Dalcouffe1/Design-Build-Fly/README.md

# CAPSTONE Design–Build–Fly: Lift + Cruise VTOL (student capstone)

A hybrid VTOL with four vertical lift rotors for takeoff and landing, and a pusher prop and fixed wing for cruise. The lift rotors stop in cruise. The aircraft is built and flight-tested on a **fixed $2,000 budget** (hardware, spares, test gear, tax and shipping) by **2027-04-30**.

**Open the design review:** double-click [`VTOL-Review.html`](VTOL-Review.html). It is one self-contained report in three parts (the decision, the design, build and fly), with interactive charts, a rotatable SOLIDWORKS model and links to the companion documents:

| Document | Open |
|---|---|
| Design review DBF-RPT-001, issue 3 | [`VTOL-Review.html`](VTOL-Review.html) |
| Build manual DBF-MAN-001 (14 work packages, step by step) | [`build-manual.html`](build-manual.html) · source [`docs/build/BUILD-MANUAL.md`](docs/build/BUILD-MANUAL.md) |
| Test and evaluation plan DBF-TP-001 | [`test-plan.html`](test-plan.html) · source [`docs/test/TEST-PLAN.md`](docs/test/TEST-PLAN.md) |
| Flight software setup DBF-SW-001 | [`flight-software.html`](flight-software.html) · source [`firmware/README.md`](firmware/README.md) |
| Hot-wire templates (1:1) | [`templates.html`](templates.html) |
| Drawing set DBF-DRW-001 rev B (9 sheets) | [`cad/drawings/DBF-DRW-001.PDF`](cad/drawings/DBF-DRW-001.PDF) |

## Current design (v0.4.0, 2026-10-21)

The numbers below come from `analysis/results.json` (sizing) and `analysis/aero/aero_results.json` (aerodynamics).

| | |
|---|---|
| Layout | C0: 4-lift twin-boom quadplane, H-tail with twin rudders on the booms, pusher on the pod; best of 29 configurations that keep the lift rotors stopped in cruise (`analysis/tradestudy.json`) |
| Span / wing | 2.4 m, 0.632 m² (chord 263 mm), NACA 2415, XPS foam core with packing-tape skin |
| MTOW | 6.43 kg (hard cap 25 kg; below the 8–15 kg working target, pending sign-off) |
| Lift / pusher | 5 × SunnySky X4110S 400KV; 17 in lift props; APC 14×8.5EP pusher |
| Hover / cruise | 888 W / 323 W at 20 m/s (aero build-up 297 W); hover T/W 1.95 on maker data |
| Energy | 2 × Ovonic 6S 6500 mAh LiPo; 13.1 min cruise available after 2 min hover + 20 % reserve (needs the printed leg fairings) |
| Aerodynamics | CD0 0.0427, L/D 8.3 at cruise; stall 12.05 m/s predicted (R11 ≤ 12, at the limit); neutral point 40.4 % MAC with the pod |
| Structure | 6061-T6 booms, spar sockets and a 0.76 m slip-fit joiner; joiner reserve factor 1.78 on yield at 4.5 g |
| CAD | SOLIDWORKS rev B: 75 part files, 397 components including every screw, nut, washer and insert; interference-checked |
| Avionics | CoreWing F405 Wing V2 + ArduPlane 4.7.2 stable QuadPlane; parameter file `firmware/vtol_c0.param` checked, SITL scenarios A–G pass |
| Budget | **$1,896.79 committed** (goods $1,620.67 + 10.25 % tax + $110 shipping estimate); **$103.21 reserve** |

## Repository layout

| Path | What it is |
|---|---|
| `VTOL-Review.html`, `*.html` at the root | The review and its companion pages (generated by `review/build.mjs`) |
| `docs/DESIGN-BASIS.md` | Requirements R1–R20 (Given vs Assumed), design outcomes |
| `docs/research/` | Parts research with prices, URLs and dates; `hardware-spec.md` (fasteners and fits), `configurations.md` (trade-study literature), `aerodynamics.md`, `firmware.md` |
| `docs/build/` | Build manual, cut / print / wiring lists, hot-wire template generator |
| `docs/test/` | Test plan, test matrix, flight test cards, data-reduction scripts |
| `docs/purchasing/C0_BOM.csv` | Purchasing list grouped by vendor, with order-tracking columns |
| `analysis/` | Sizing model and script, vortex-lattice check, trade study, independent checks (`verify.py`) |
| `analysis/aero/` | XFOIL, NeuralFoil, AVL, drag build-up and SU2 CFD (`run_all.py`) |
| `firmware/` | ArduPlane parameter files, setup guide, checklists, parameter checker, SITL scripts and results |
| `cad/` | SOLIDWORKS model generator, drawings, simulations and outputs. See [`cad/README.md`](cad/README.md) |
| `review/` | Page sources (`src/`), companion-page renderer and build script |

## Regenerate everything

```bash
node analysis/sizing.mjs        # sizing + BOM  -> analysis/results.json
node analysis/vlm.mjs           # aero check    -> analysis/aero.json
node analysis/export_bom.mjs    # purchasing    -> docs/purchasing/C0_BOM.csv
py -3 analysis/verify.py        # independent checks (expects "FAILED CHECKS: none")
node analysis/tradestudy.mjs    # 29-variant trade study -> analysis/tradestudy.json
py -3 analysis/aero/run_all.py  # aerodynamics and CFD -> analysis/aero/aero_results.json (--skip-cfd for the fast tools)
py -3 firmware/tools/check_params.py firmware/vtol_c0.param
node review/build.mjs           # review and companion pages
```

The CAD and simulations need SOLIDWORKS 2025 with Simulation on Windows:

```bash
powershell -ExecutionPolicy Bypass -File cad/build.ps1   # params -> parts, assembly, drawings, meshes
cad/Sim.exe cad/params.txt cad/sim                      # FEA + modal + thermal -> cad/sim/results.txt
```

## Working rules (from CLAUDE.md)

- Every number cites its source: a repo file, a formula shown in the review, or a URL with the date checked.
- Estimates are labelled `est`. Unknowns are shown as "—" and never invented.

## Open items for the team

1. **Approve and order.** Client approval and Order A (test motors, packs, charger) by 2026-11-02.
2. **Flying site and legal path.** Ask UCPD/Risk Services by 2026-11-06 and request Richmond Field Station.
3. **Thrust stand first.** Qualify every motor and ESC before any flight; C0 has no hover motor-out tolerance.
4. **Measure.** Each chapter of the review lists what the team still has to measure; the overview gathers them in one list.
