Dalcouffe1/Design-Build-Fly/analysis/aero/plots/aircraft_polar.png

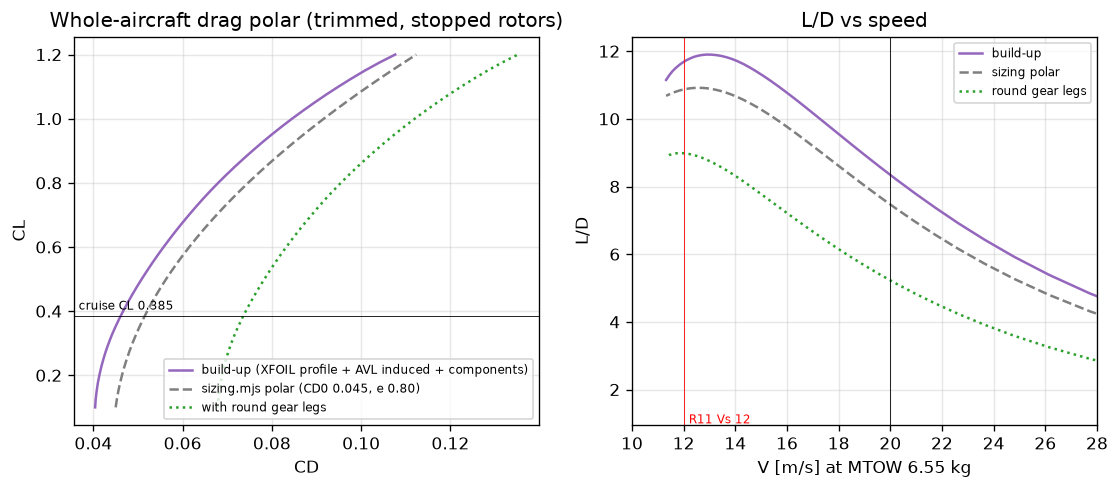
analysis/aero/plots/aircraft_polar.png
