Dalcouffe1/Design-Build-Fly/analysis/aero/plots/cg_np.png

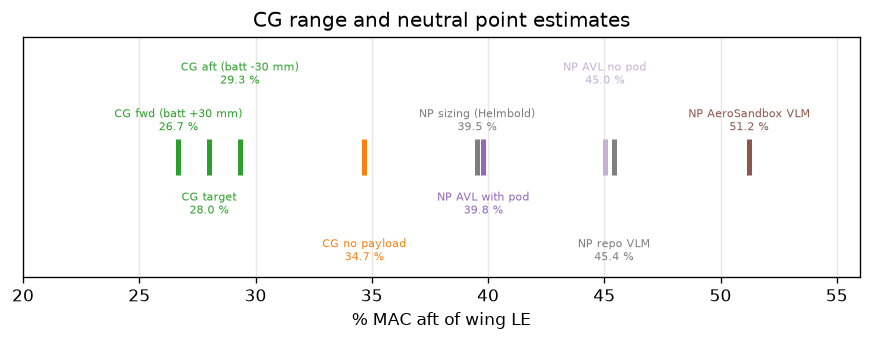
analysis/aero/plots/cg_np.png
