Dalcouffe1/Design-Build-Fly/analysis/aero/plots/cp_distributions.png

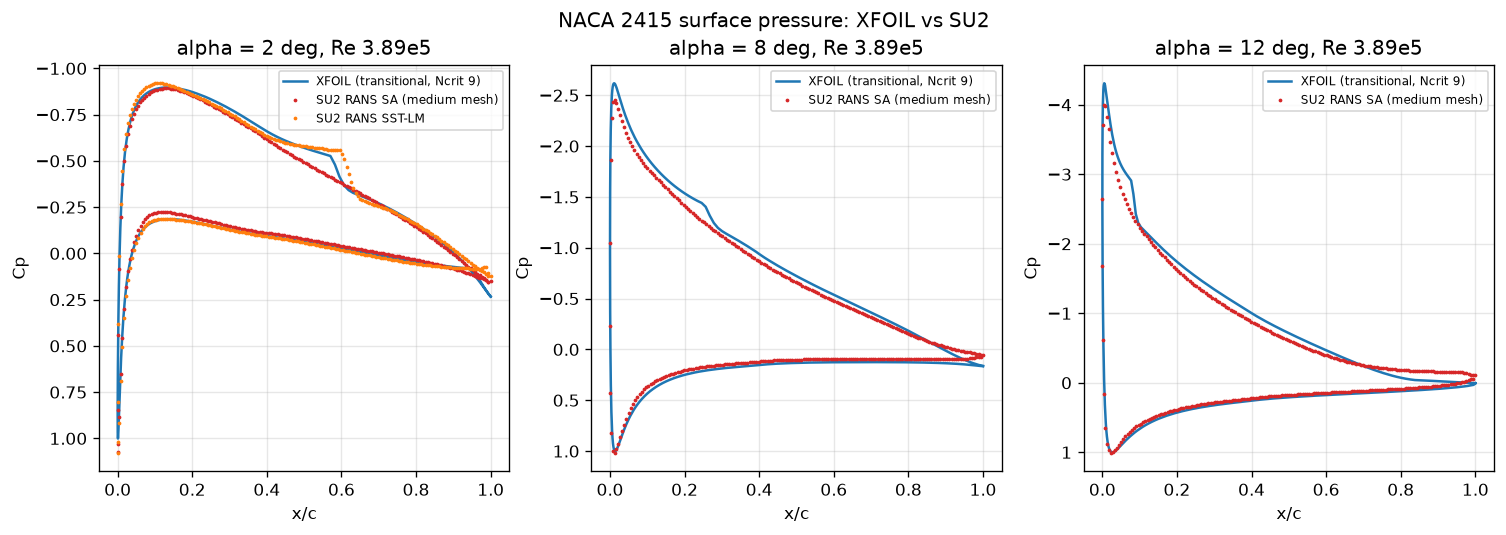
analysis/aero/plots/cp_distributions.png
