Dalcouffe1/Design-Build-Fly/analysis/aero/plots/drag_breakdown.png

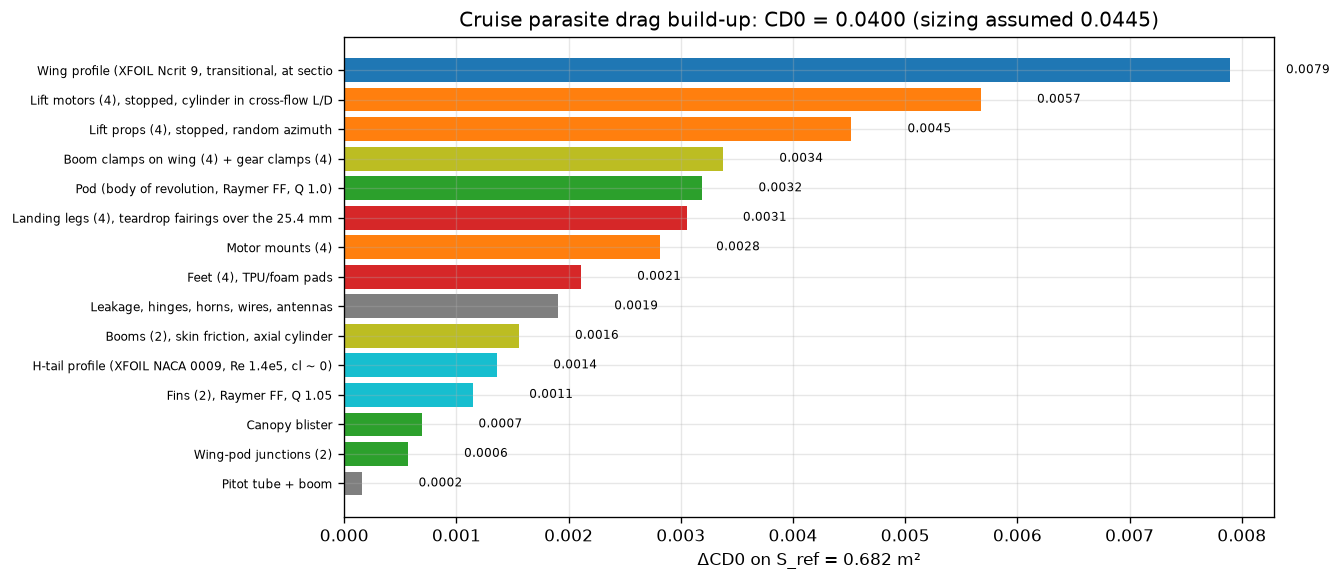
analysis/aero/plots/drag_breakdown.png
