Dalcouffe1/Design-Build-Fly/analysis/aero/plots/drag_pie.png

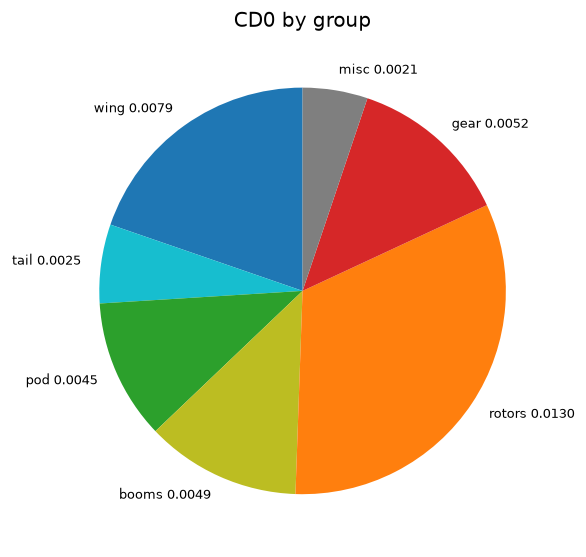
analysis/aero/plots/drag_pie.png
