Dalcouffe1/Design-Build-Fly/analysis/aero/plots/flow_0.png

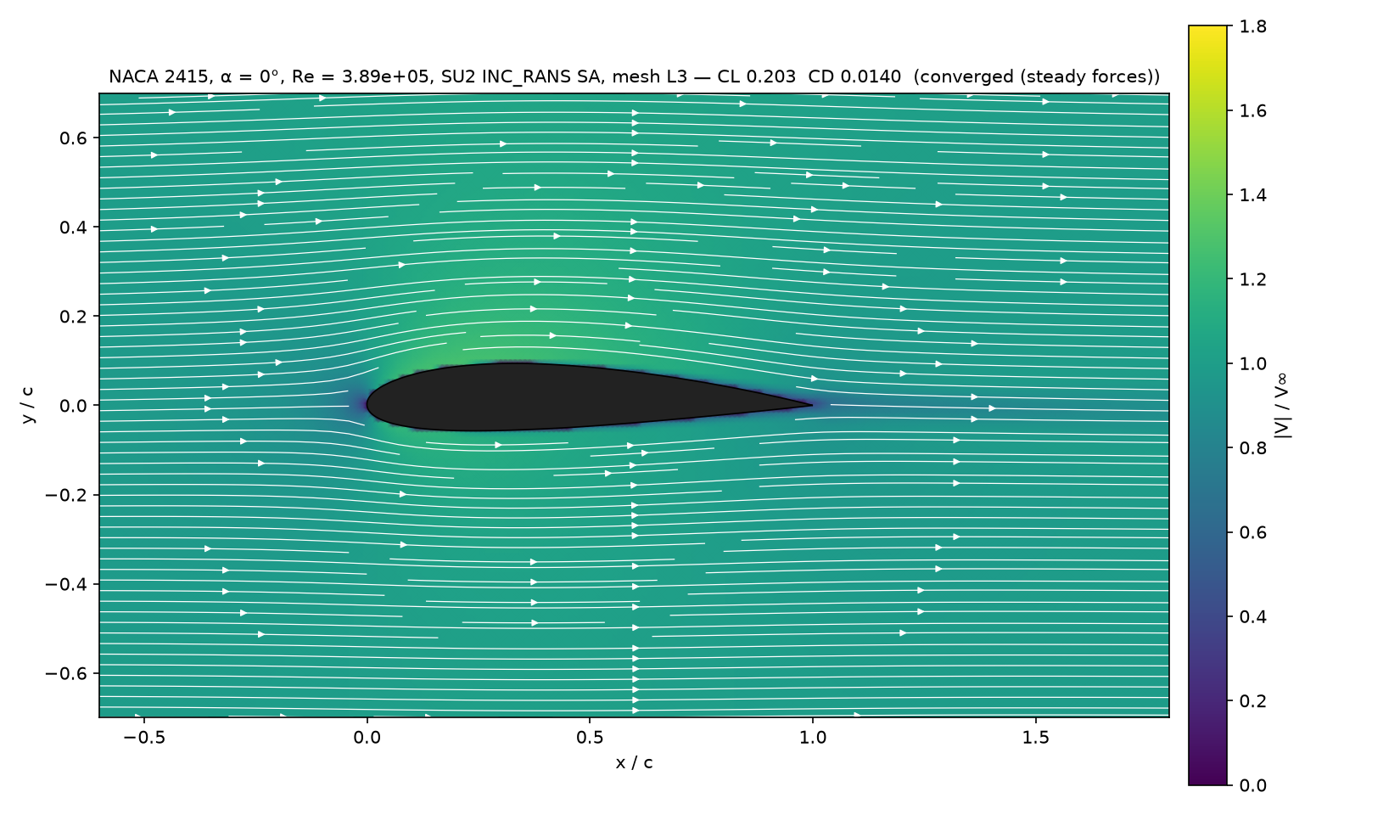
analysis/aero/plots/flow_0.png
