Dalcouffe1/Design-Build-Fly/analysis/aero/plots/flow_3d.png

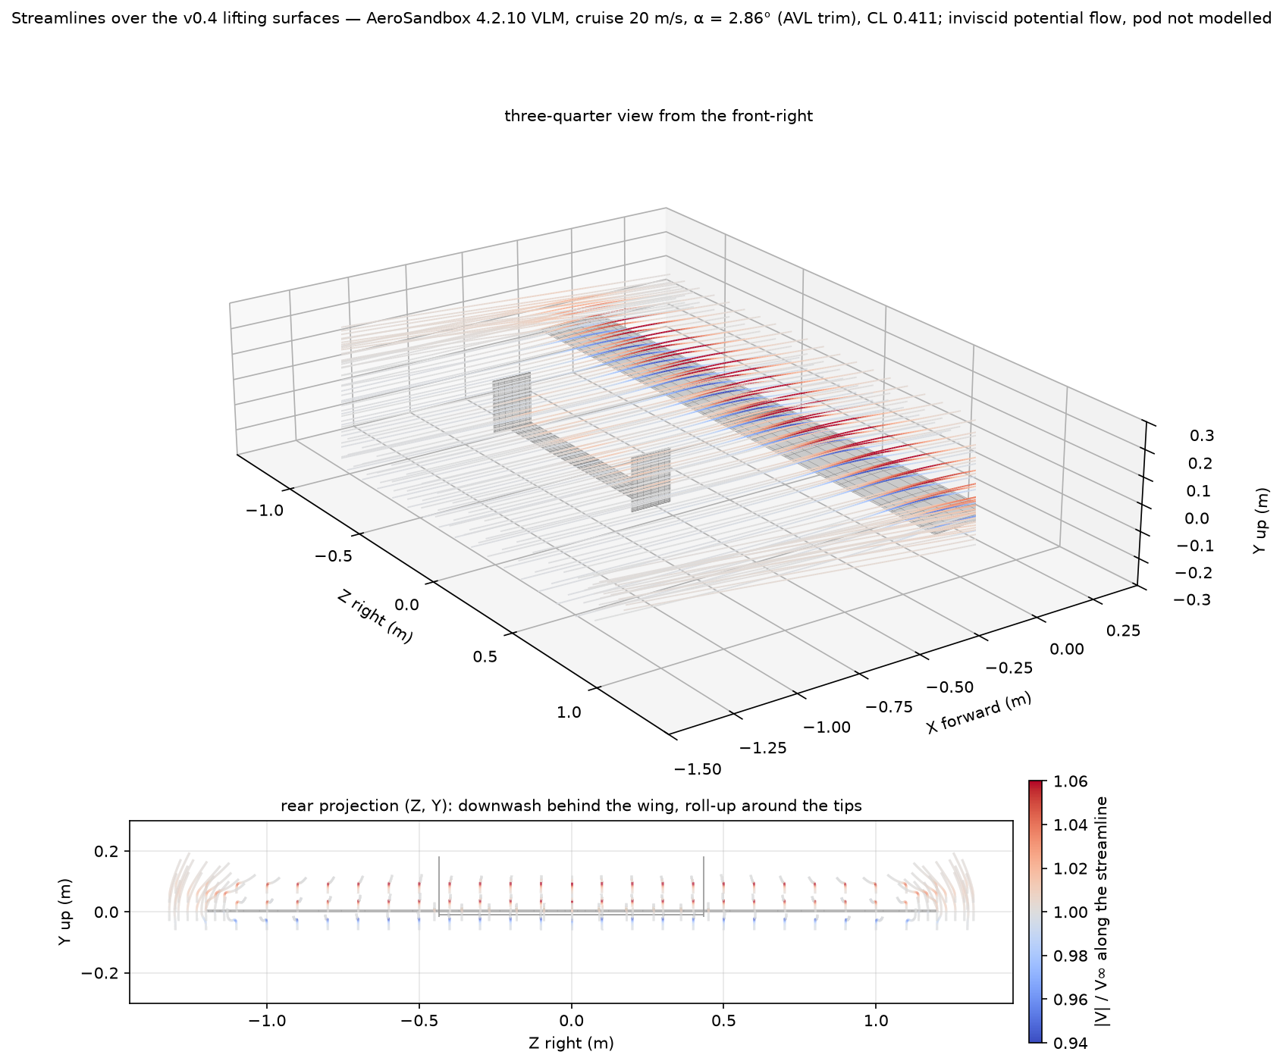
analysis/aero/plots/flow_3d.png
