Dalcouffe1/Design-Build-Fly/analysis/aero/plots/flow_4.png

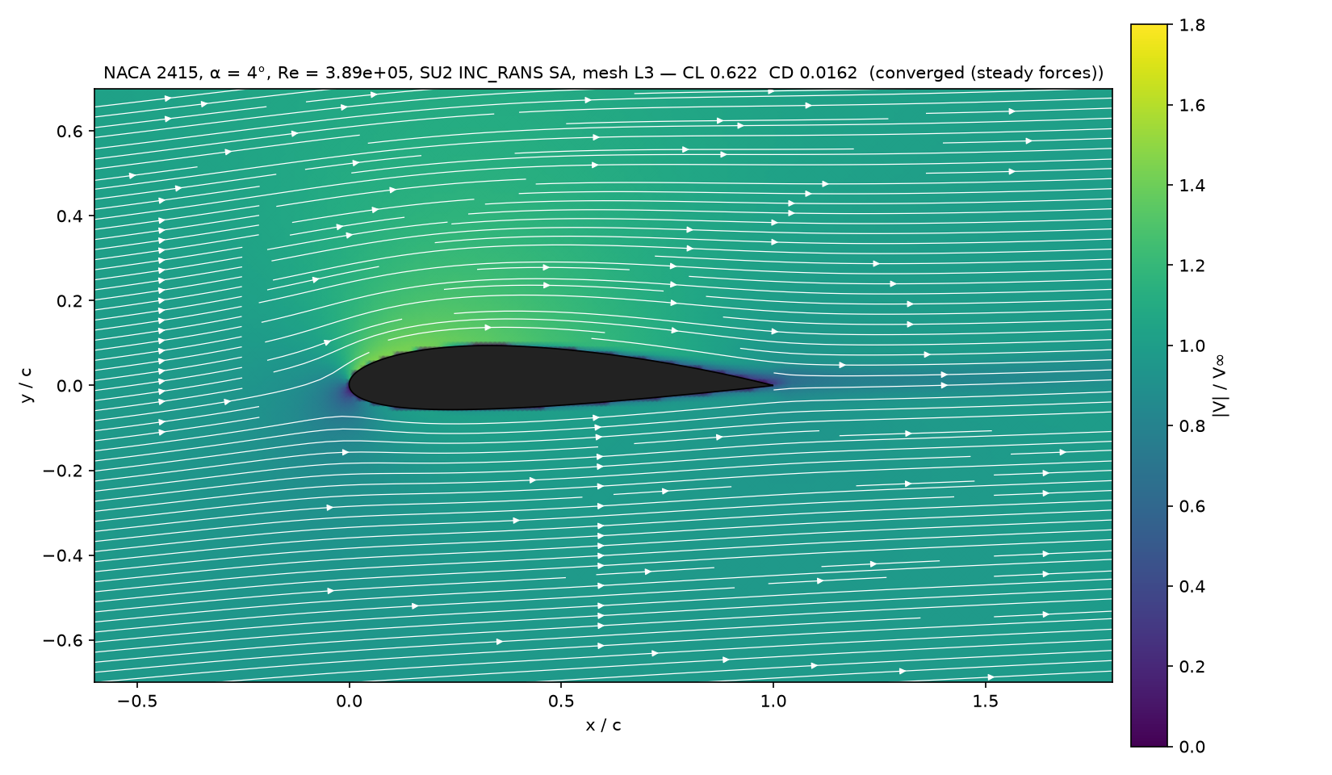
analysis/aero/plots/flow_4.png
