Dalcouffe1/Design-Build-Fly/analysis/aero/plots/flow_8.png

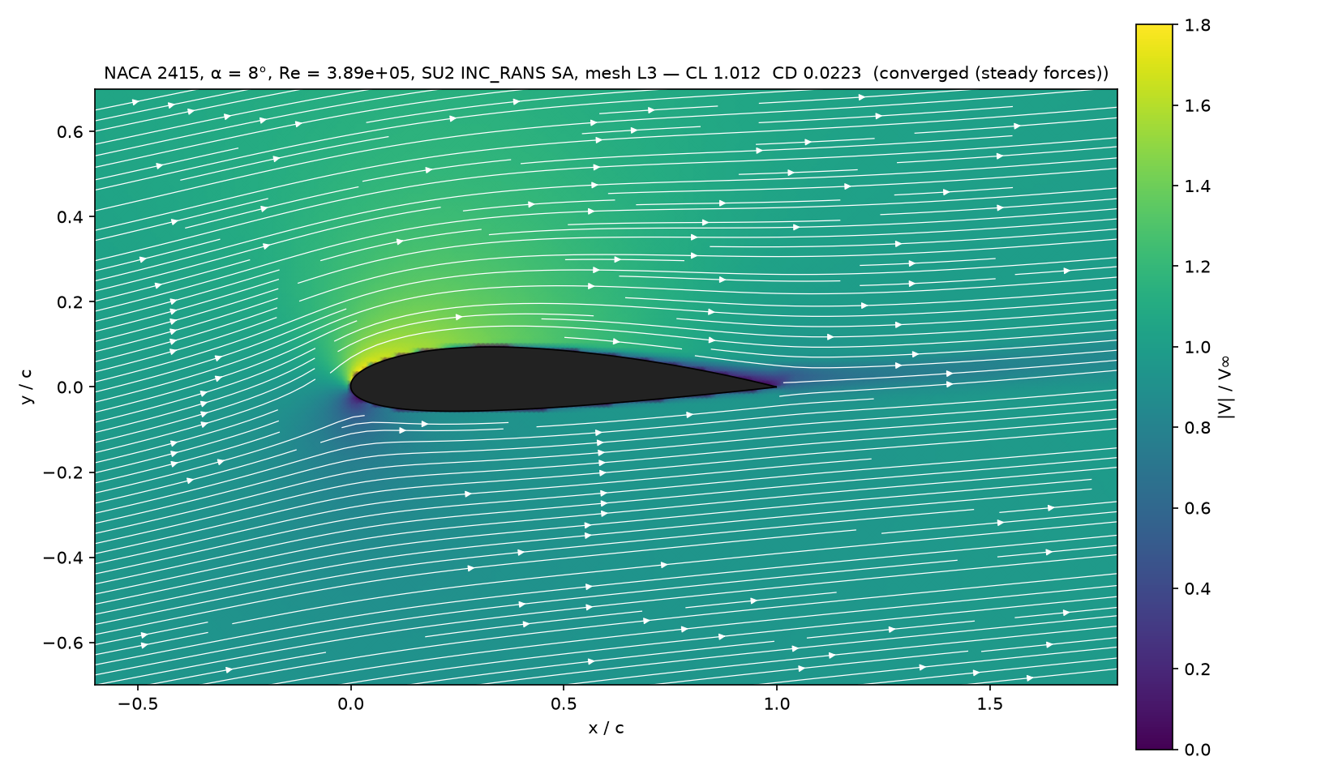
analysis/aero/plots/flow_8.png
