Dalcouffe1/Design-Build-Fly/analysis/aero/plots/flow_12.png

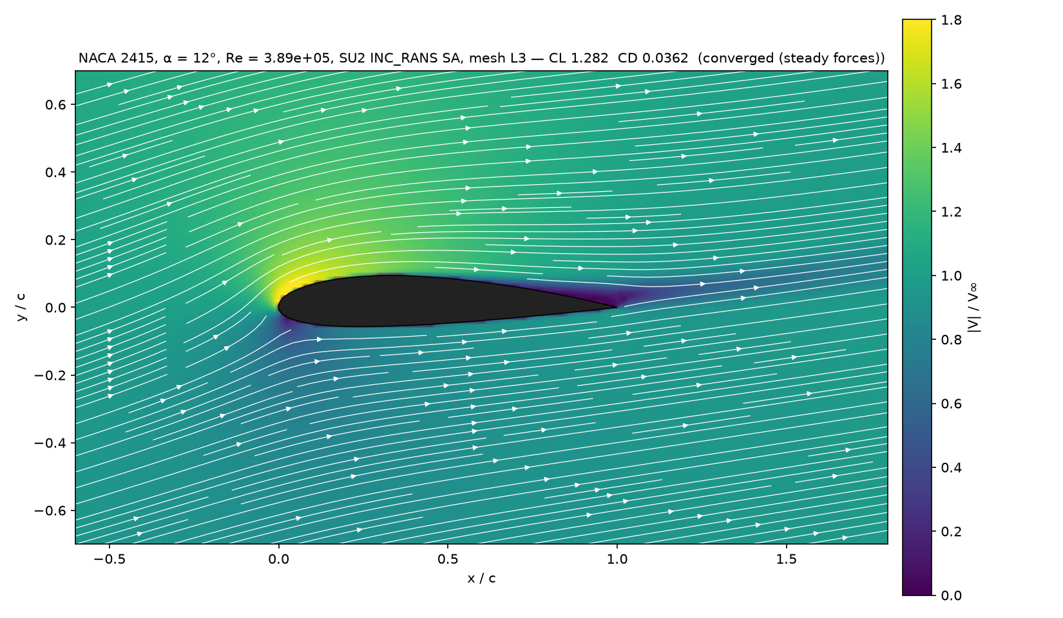
analysis/aero/plots/flow_12.png
