Dalcouffe1/Design-Build-Fly/analysis/aero/plots/flow_15.png

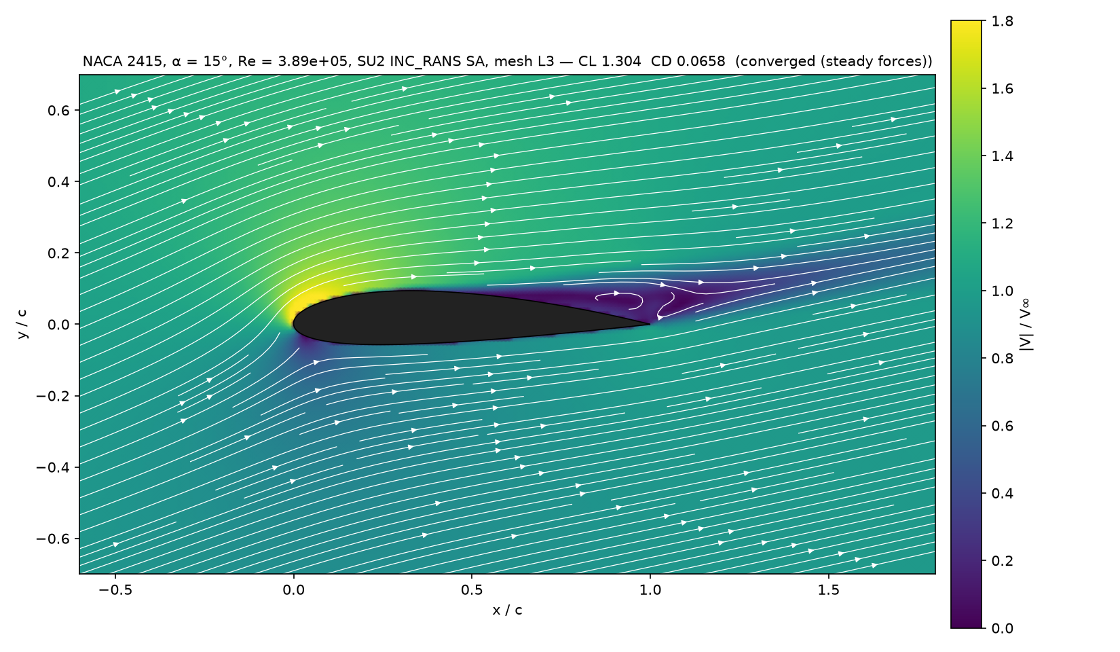
analysis/aero/plots/flow_15.png
