Dalcouffe1/Design-Build-Fly/analysis/aero/plots/flow_cp_8.png

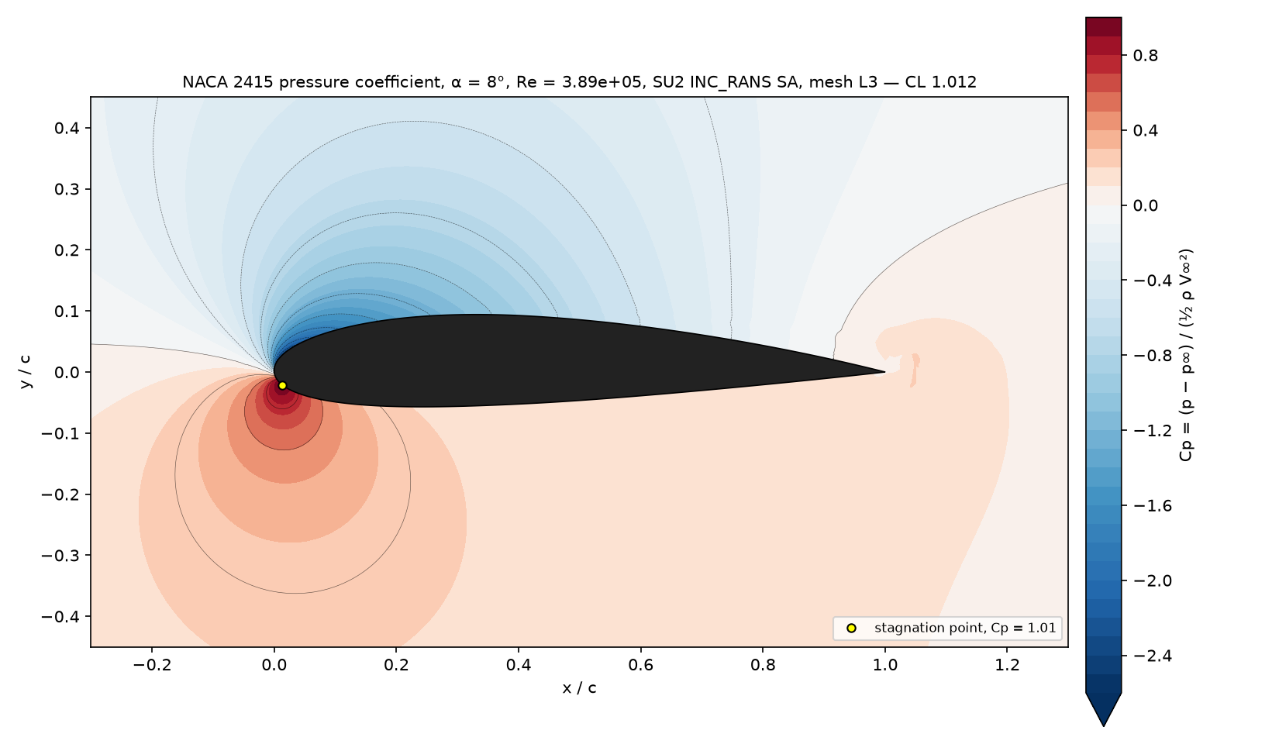
analysis/aero/plots/flow_cp_8.png
