Dalcouffe1/Design-Build-Fly/analysis/aero/plots/mesh_check_L1.png

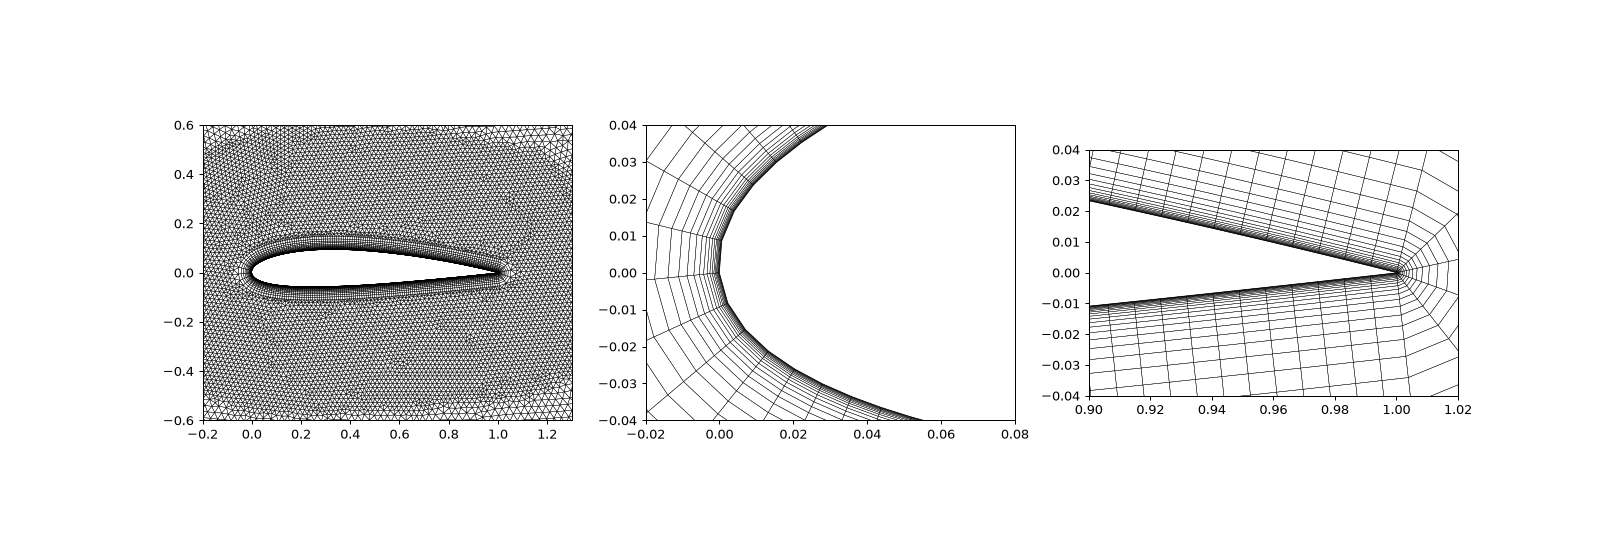
analysis/aero/plots/mesh_check_L1.png
