Dalcouffe1/Design-Build-Fly/analysis/aero/plots/section_polars.png

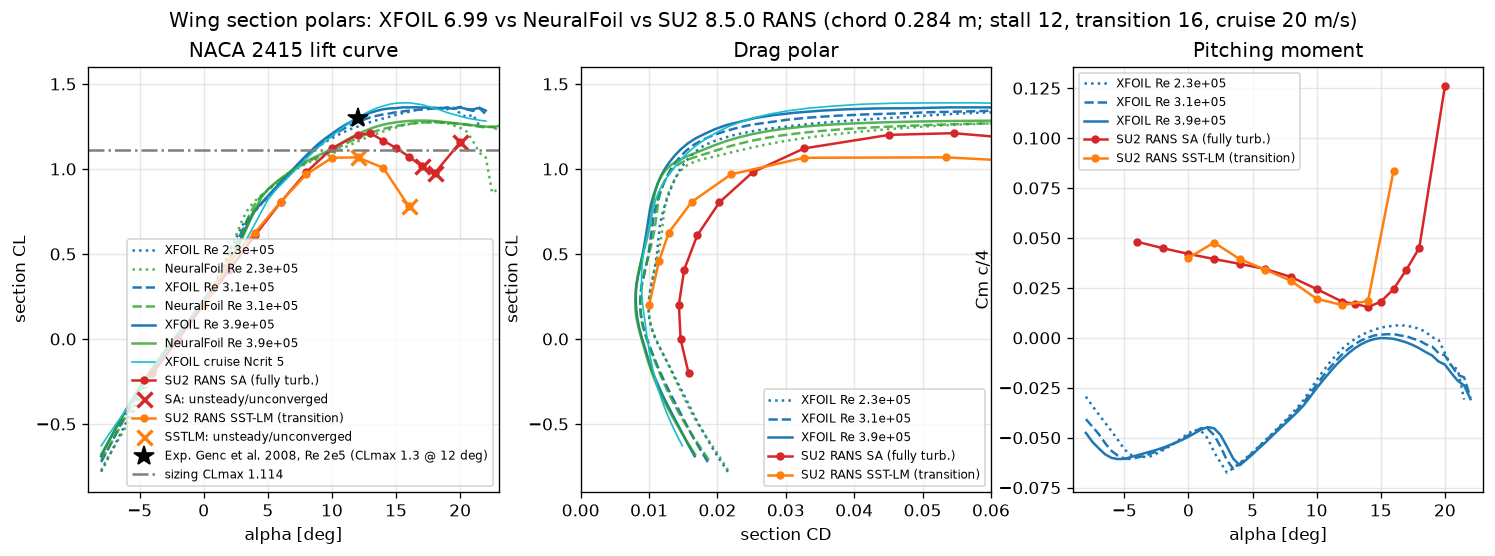
analysis/aero/plots/section_polars.png
