Dalcouffe1/Design-Build-Fly/analysis/aero/plots/span_loading.png

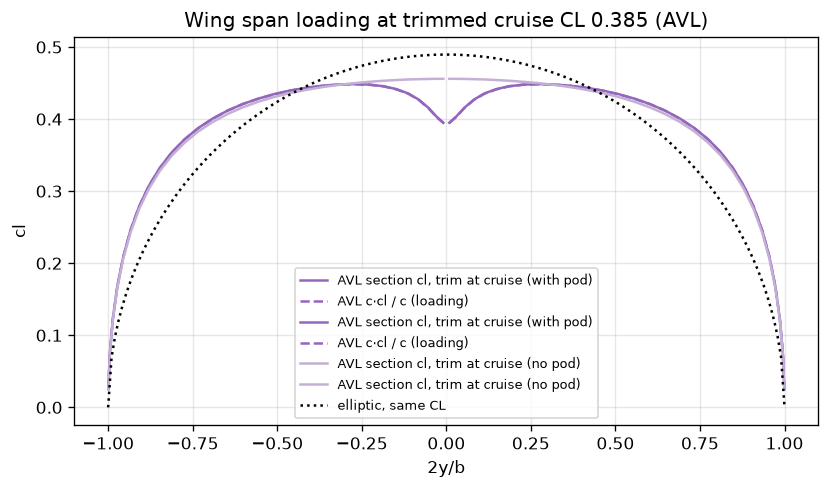
analysis/aero/plots/span_loading.png
