Dalcouffe1/Design-Build-Fly/analysis/aero/plots/stability.png

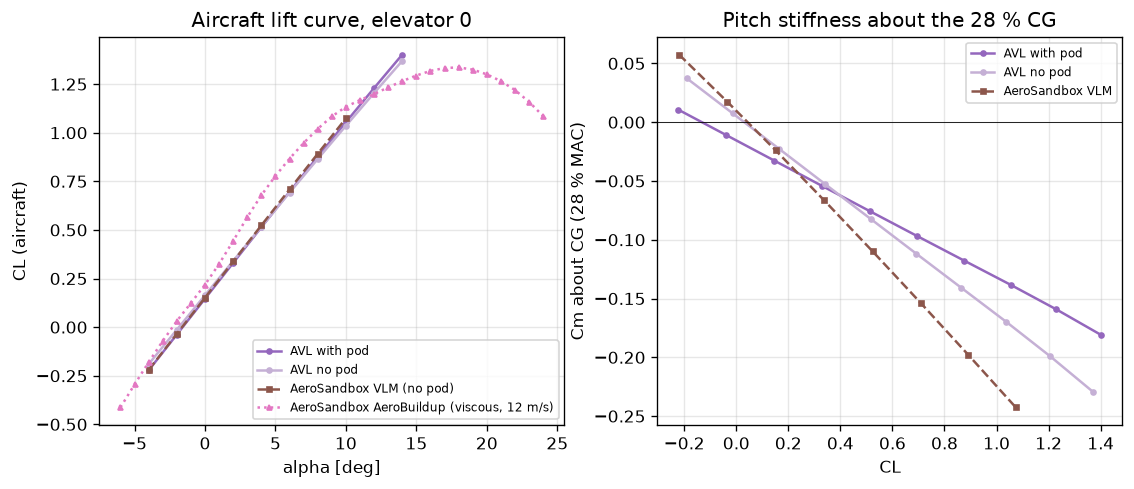
analysis/aero/plots/stability.png
