Dalcouffe1/Design-Build-Fly/analysis/aero/plots/su2_convergence.png

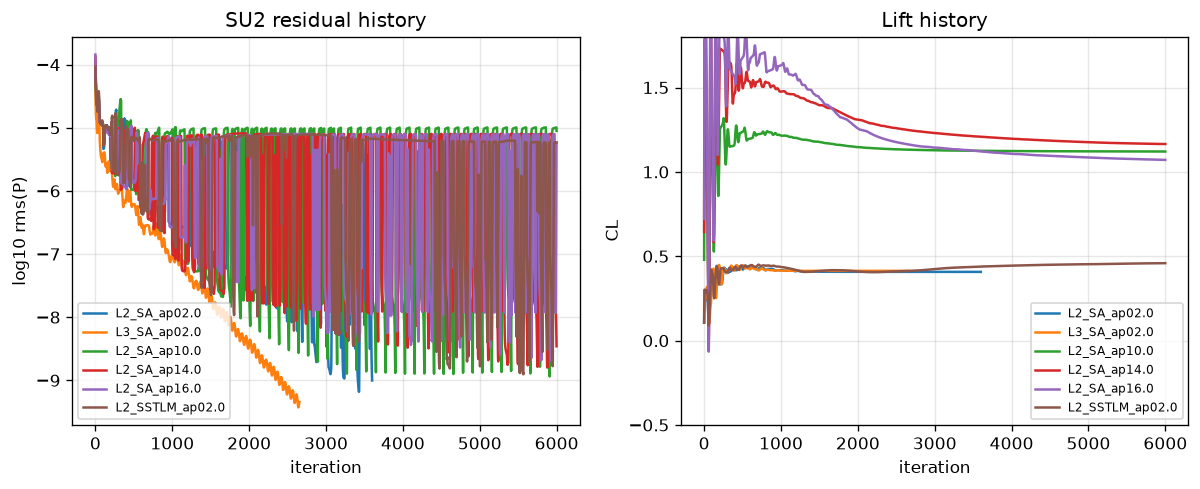
analysis/aero/plots/su2_convergence.png
