Dalcouffe1/Design-Build-Fly/analysis/aero/plots/su2_mesh_study.png

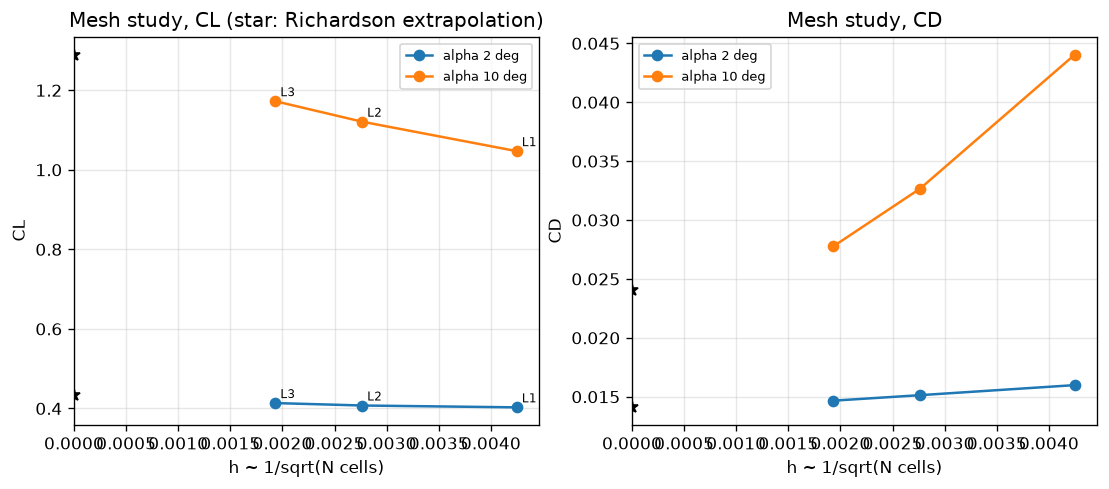
analysis/aero/plots/su2_mesh_study.png
