Dalcouffe1/Design-Build-Fly/analysis/aero/plots/tail_section_polars.png

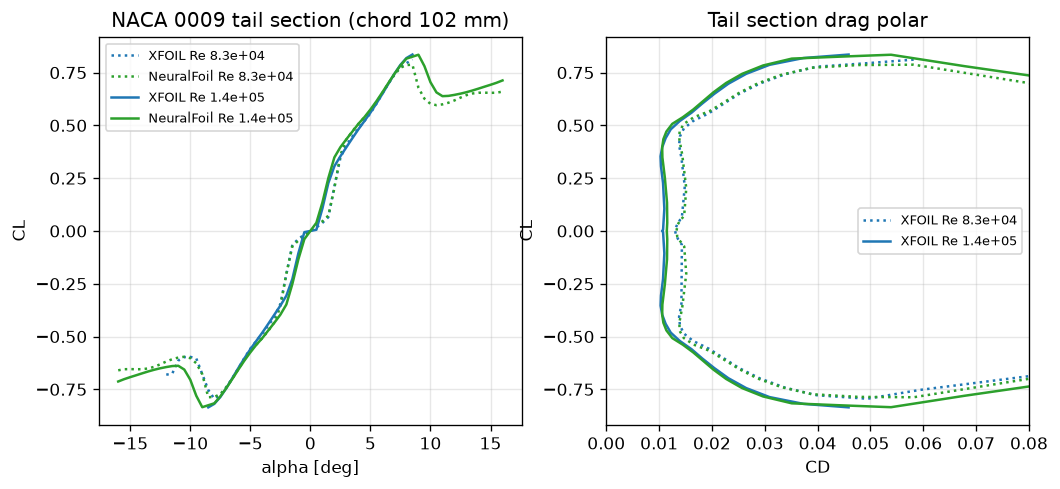
analysis/aero/plots/tail_section_polars.png
