Dalcouffe1/Design-Build-Fly/analysis/thermal/img/lift_unit_hover_30_60_90.png

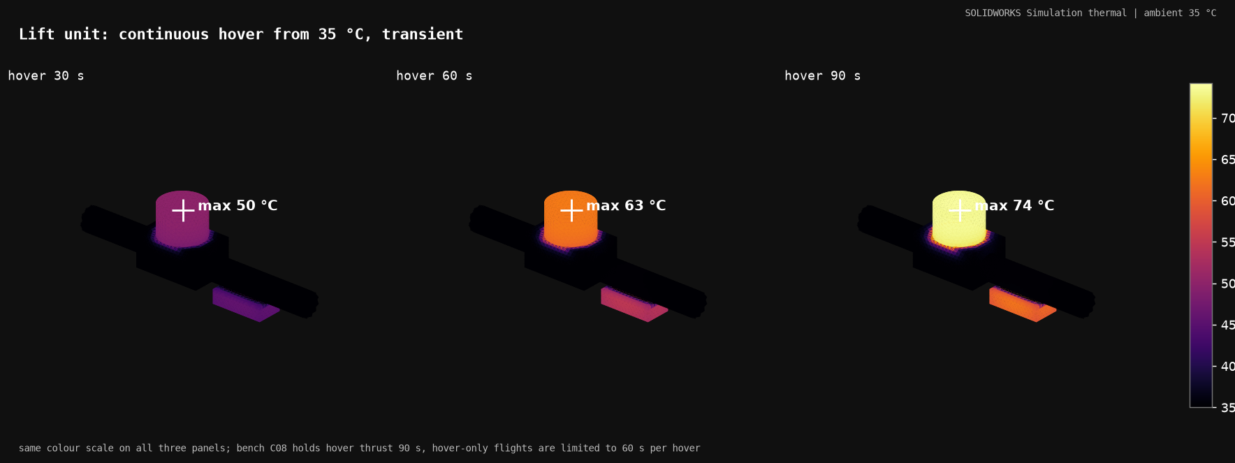
analysis/thermal/img/lift_unit_hover_30_60_90.png
