Dalcouffe1/Design-Build-Fly/analysis/thermal/img/lift_unit_mission.png

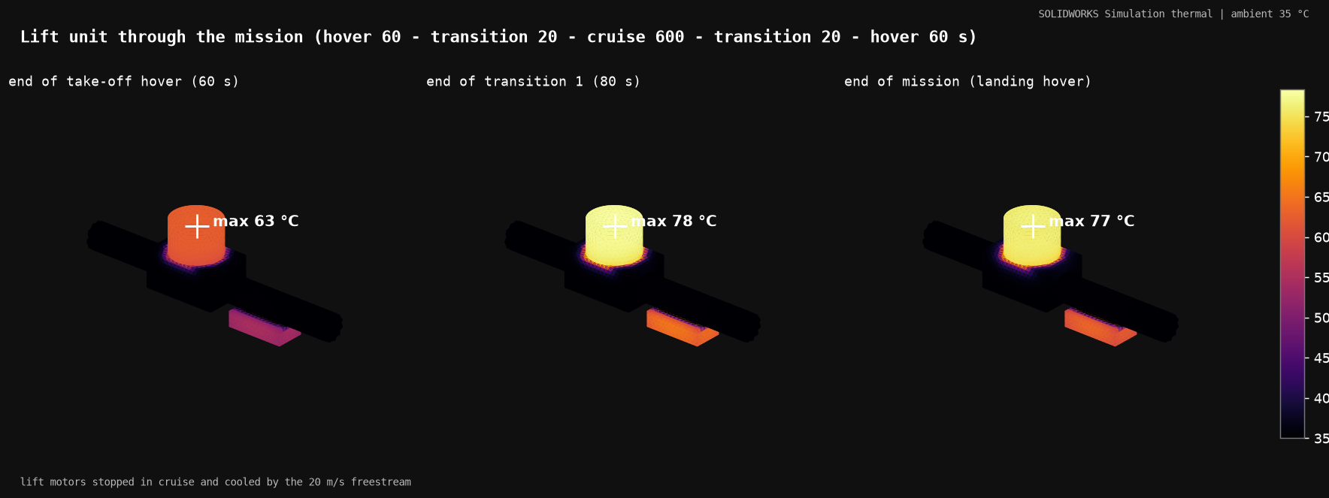
analysis/thermal/img/lift_unit_mission.png
