Dalcouffe1/Design-Build-Fly/analysis/thermal/img/lift_unit_steady.png

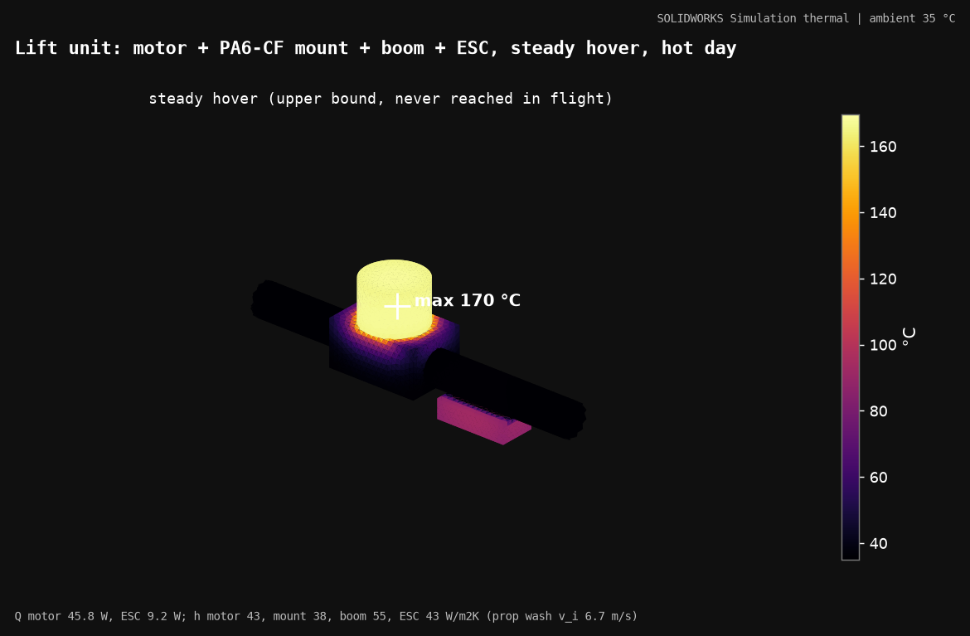
analysis/thermal/img/lift_unit_steady.png
