Dalcouffe1/Design-Build-Fly/analysis/thermal/img/pod_end_cruise.png

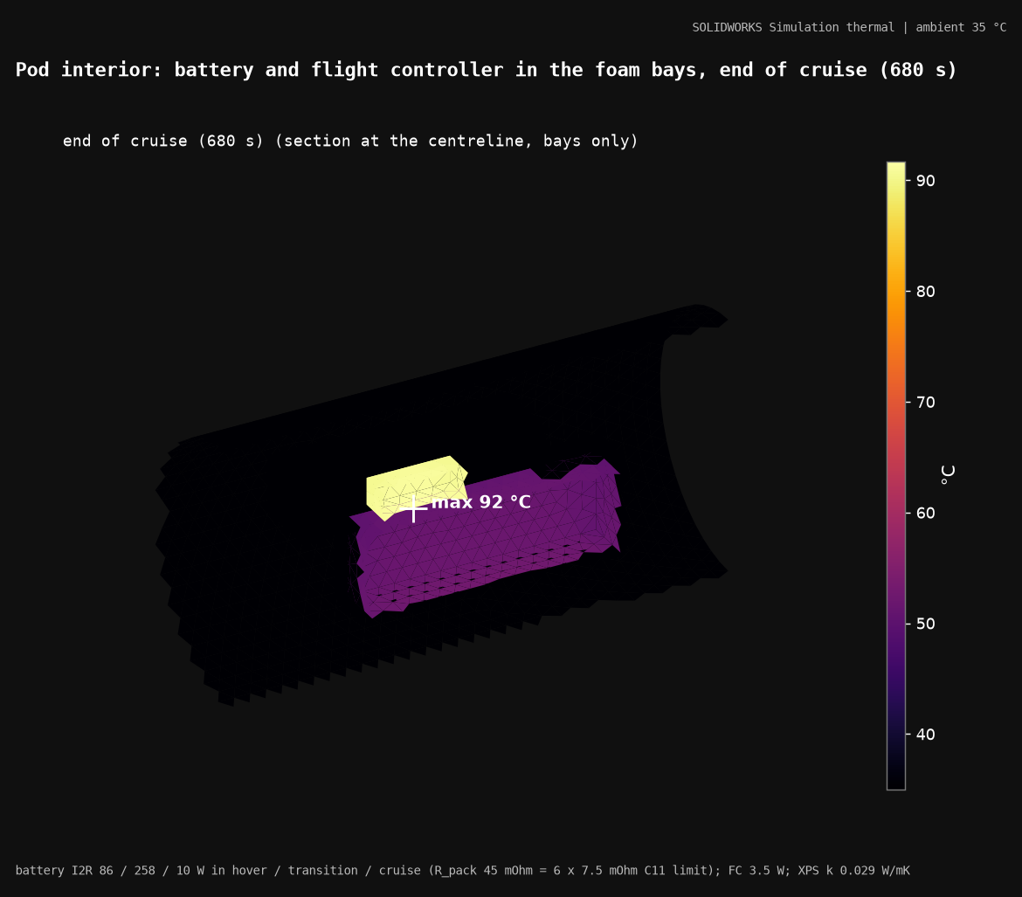
analysis/thermal/img/pod_end_cruise.png
