Dalcouffe1/Design-Build-Fly/analysis/thermal/img/pusher_cruise.png

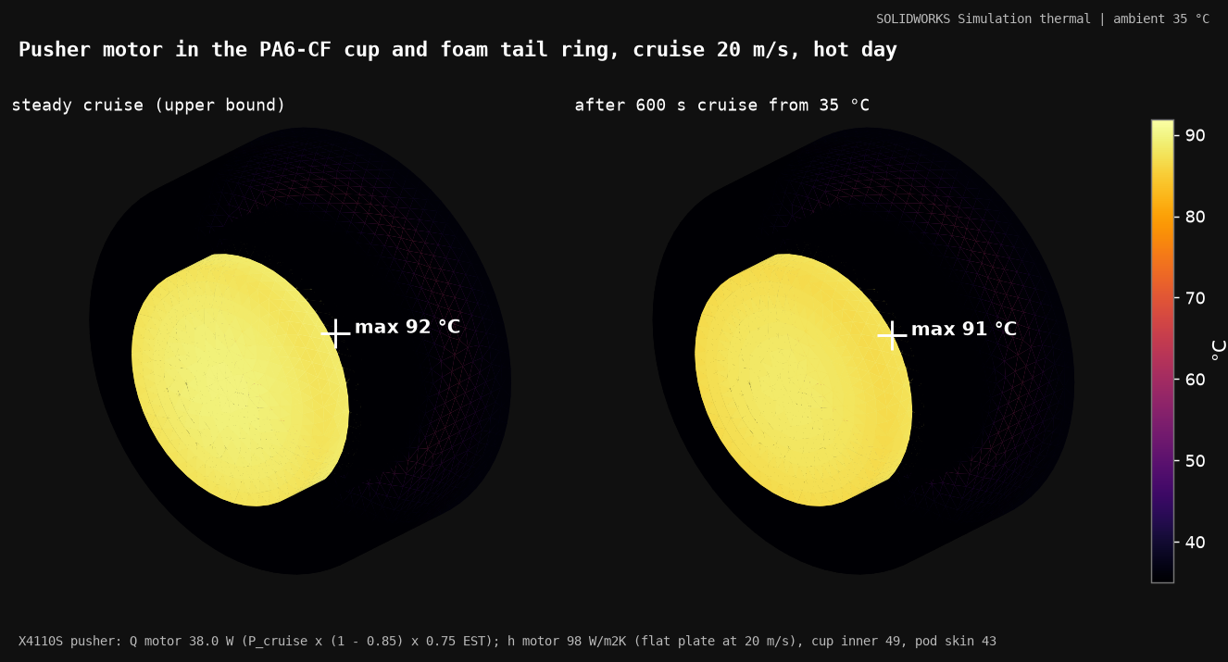
analysis/thermal/img/pusher_cruise.png
