Dalcouffe1/Design-Build-Fly/cad/drawings/DBF-DRW-001_sheet4.png

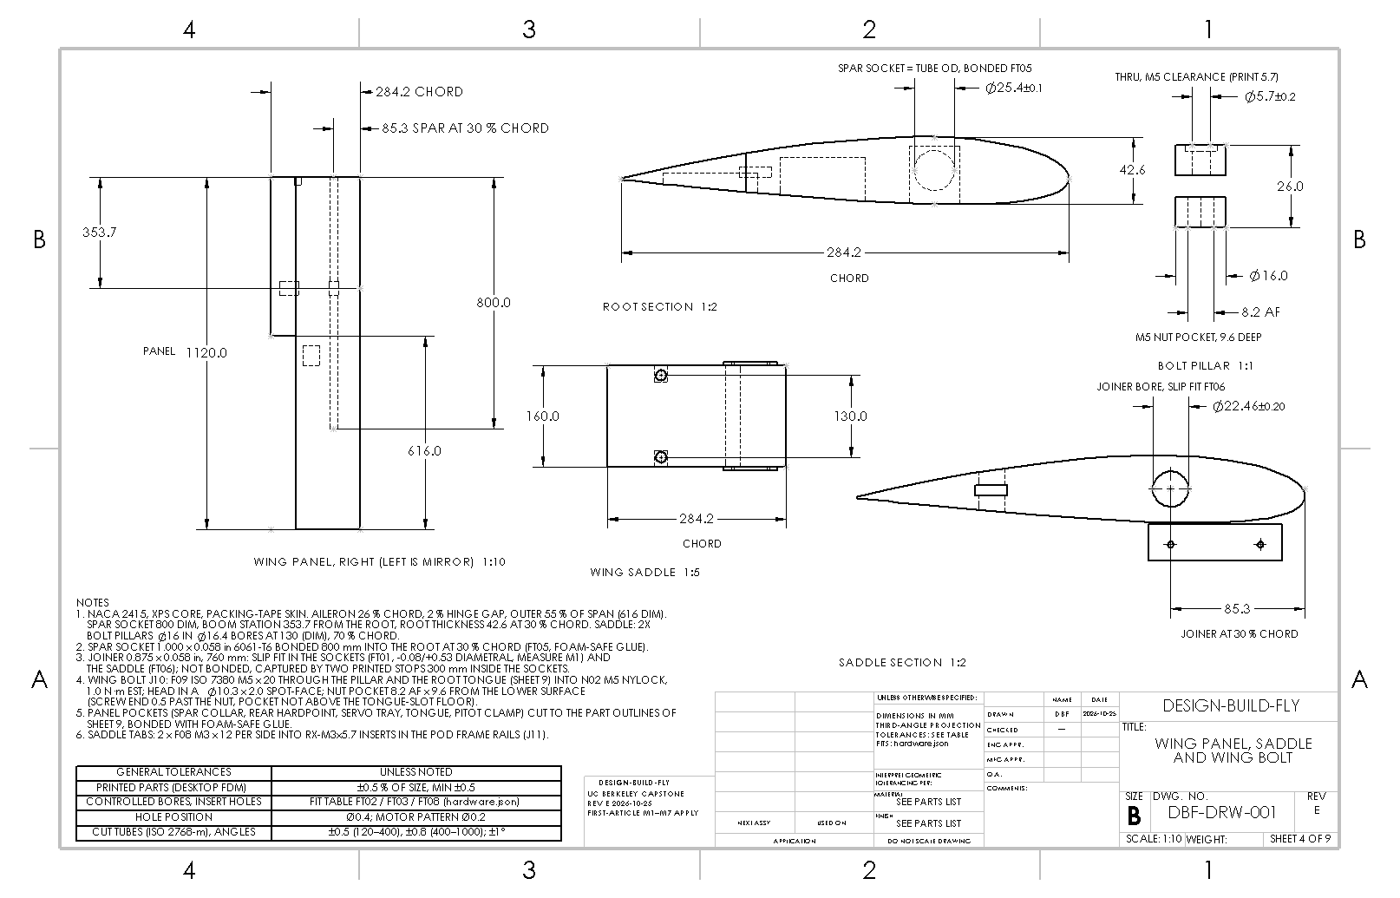
cad/drawings/DBF-DRW-001_sheet4.png
