Dalcouffe1/Design-Build-Fly/cad/drawings/DBF-DRW-001_sheet8.png

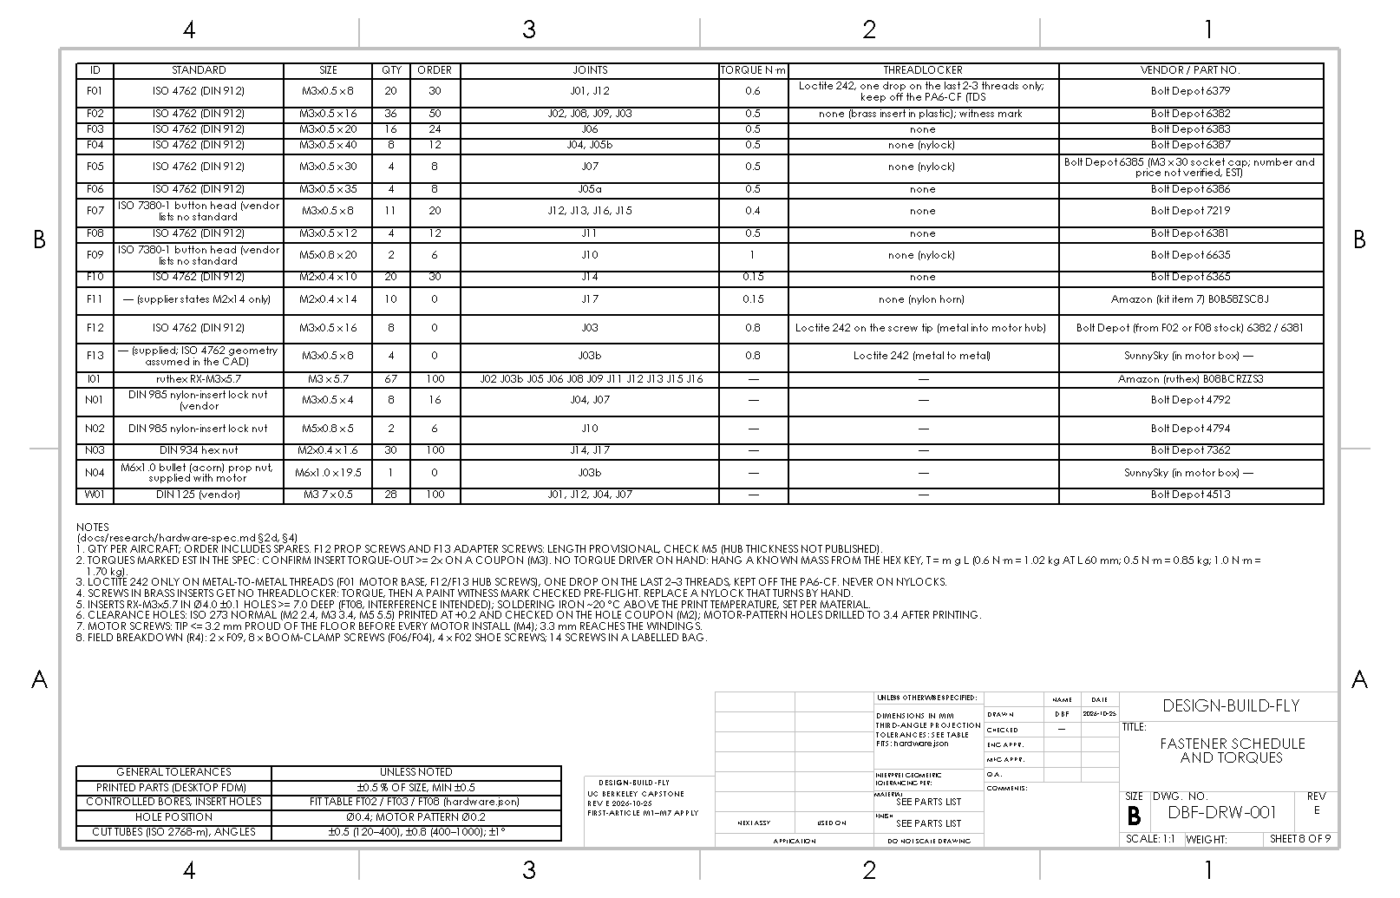
cad/drawings/DBF-DRW-001_sheet8.png
