Dalcouffe1/Design-Build-Fly/cad/images/VTOL_Concept_front.png

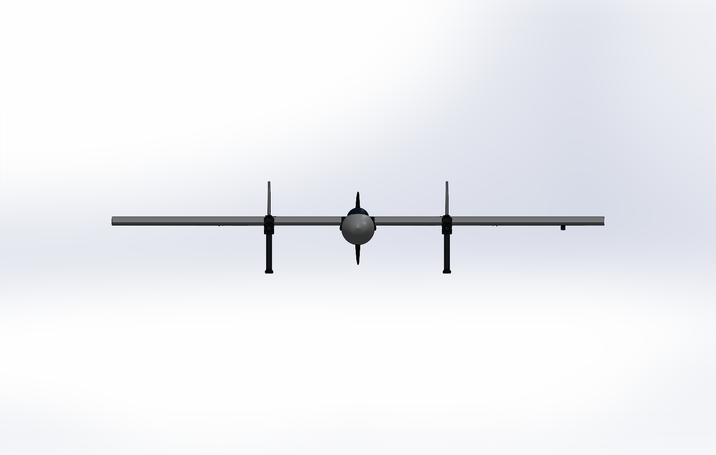
cad/images/VTOL_Concept_front.png
