Dalcouffe1/Design-Build-Fly/cad/images/VTOL_Concept_iso.png

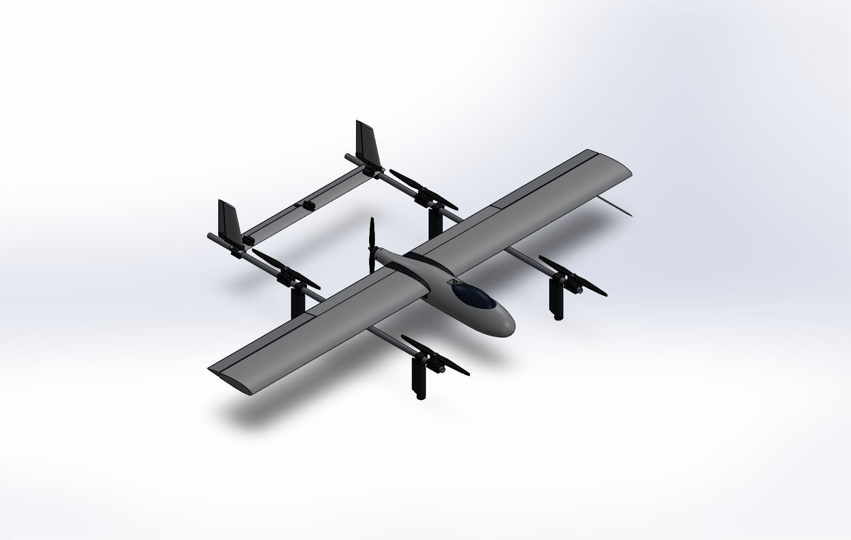
cad/images/VTOL_Concept_iso.png
