Dalcouffe1/Design-Build-Fly/cad/images/VTOL_Concept_side.png

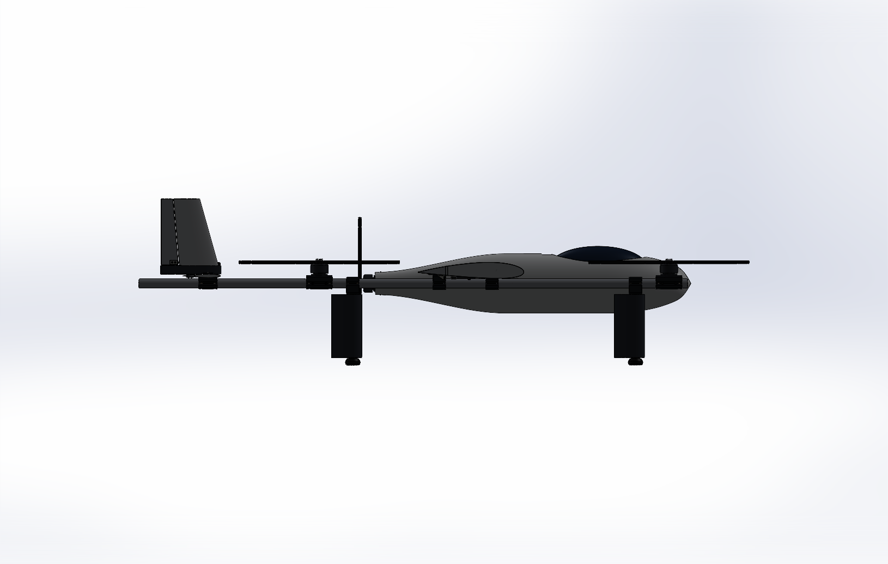
cad/images/VTOL_Concept_side.png
