Dalcouffe1/Design-Build-Fly/cad/images/VTOL_Concept_top.png

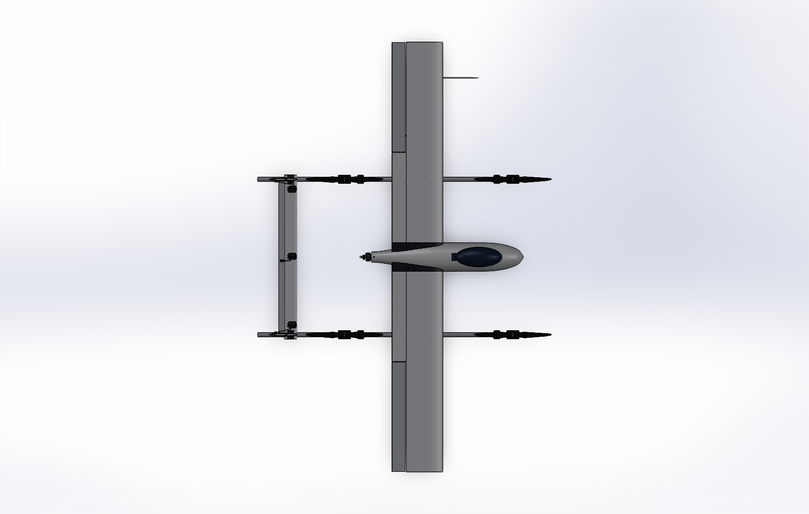
cad/images/VTOL_Concept_top.png
