Dalcouffe1/Design-Build-Fly/cad/sim/FEA_Boom_vonMises.png

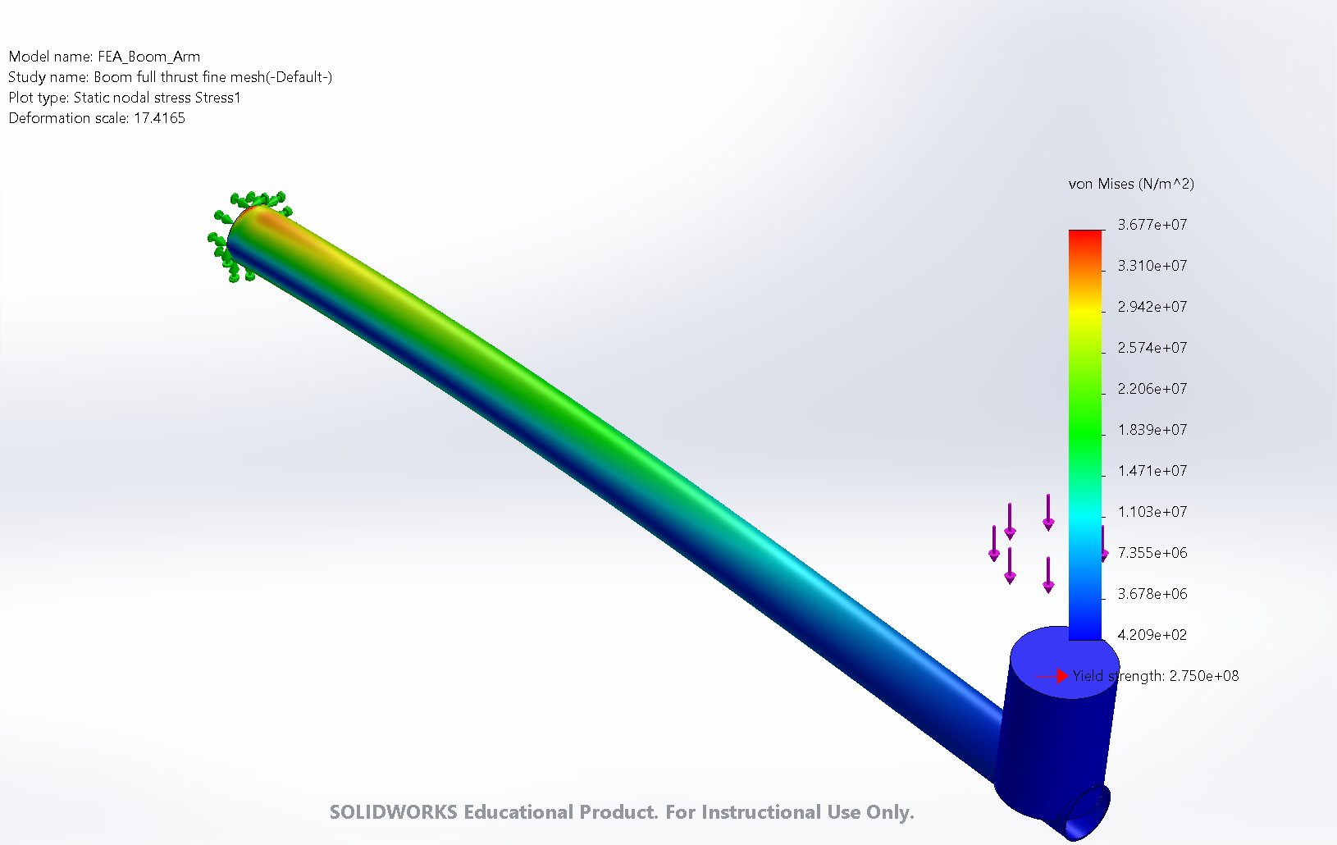
cad/sim/FEA_Boom_vonMises.png
