Dalcouffe1/Design-Build-Fly/cad/sim/FEA_Spar_vonMises.png

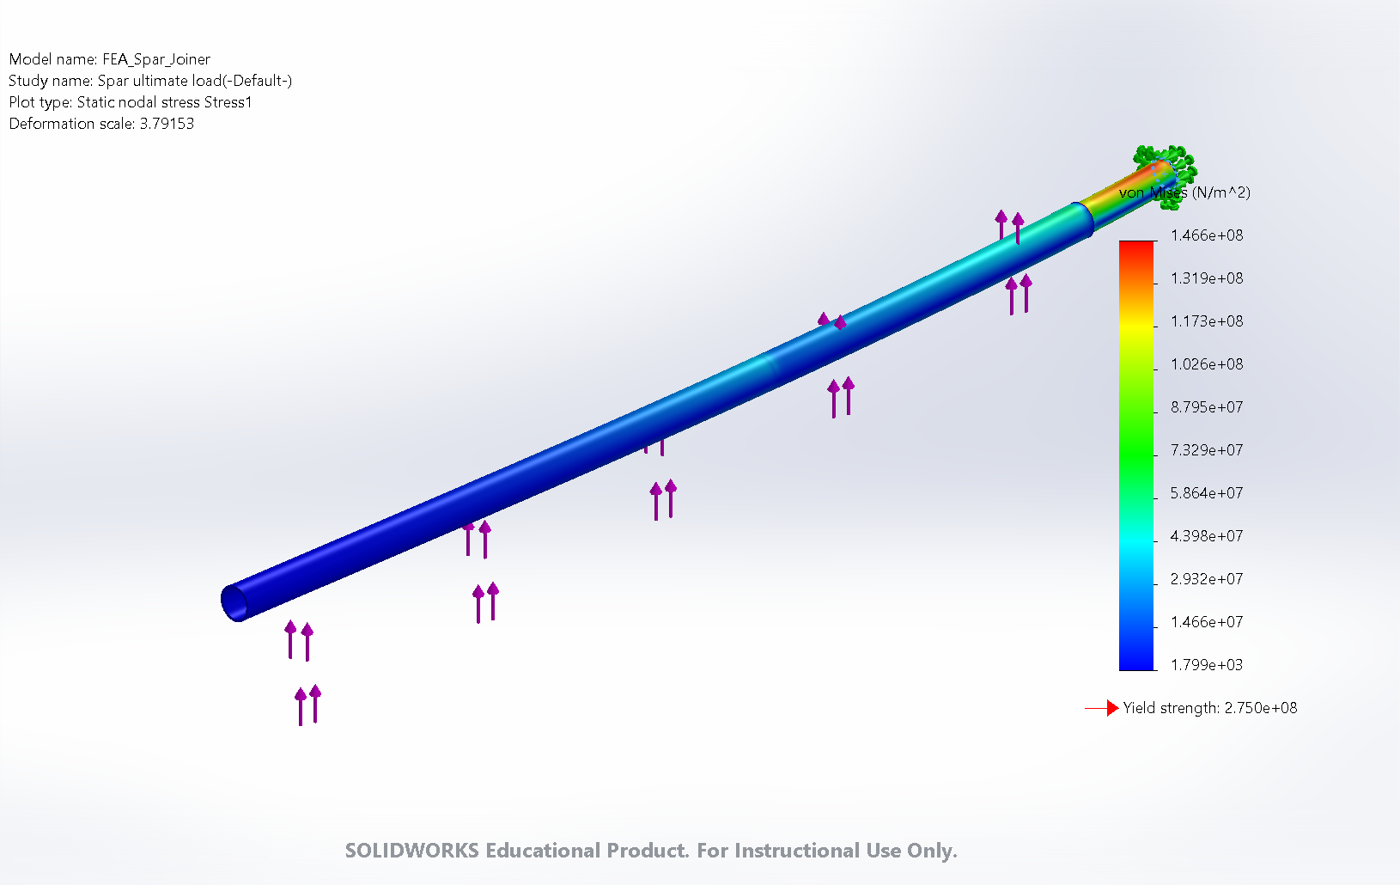
cad/sim/FEA_Spar_vonMises.png
