Dalcouffe1/Design-Build-Fly/cad/sim/THERM_Motor_steady.png

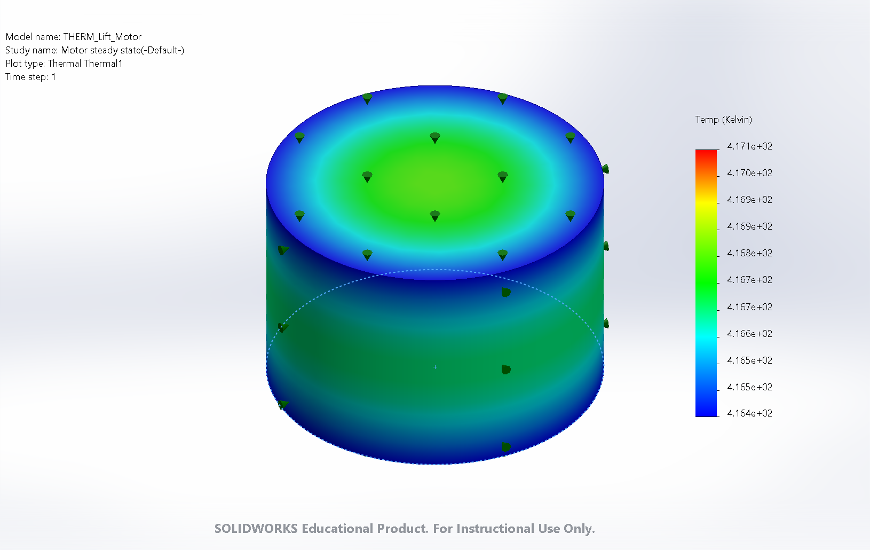
cad/sim/THERM_Motor_steady.png
