Dalcouffe1/Design-Build-Fly/cad/sim/thermal/THERM_Lift_Unit_steady.png

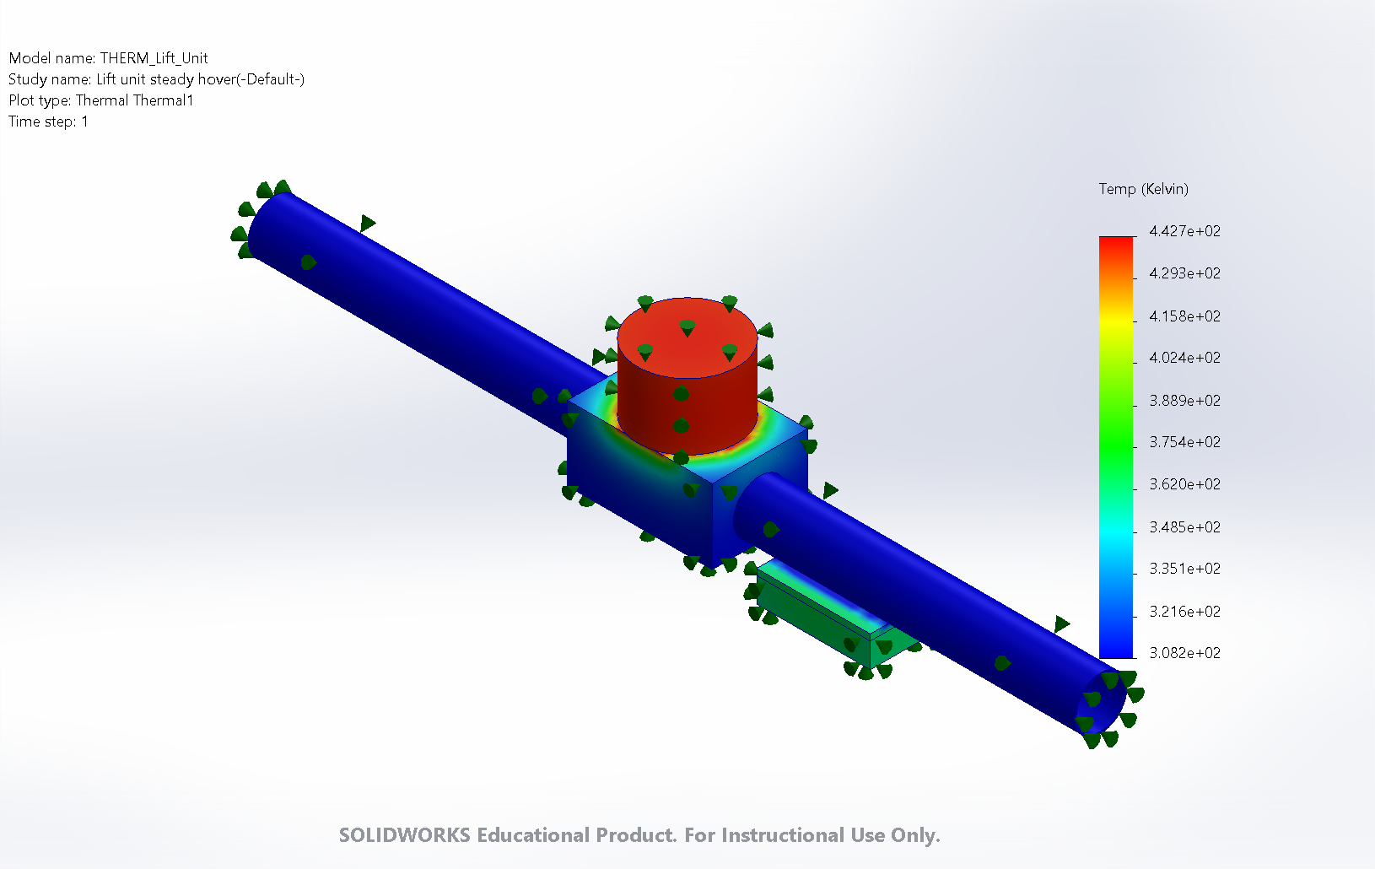
cad/sim/thermal/THERM_Lift_Unit_steady.png
