Dalcouffe1/Design-Build-Fly/cad/sim/thermal/THERM_Pod_mission.png

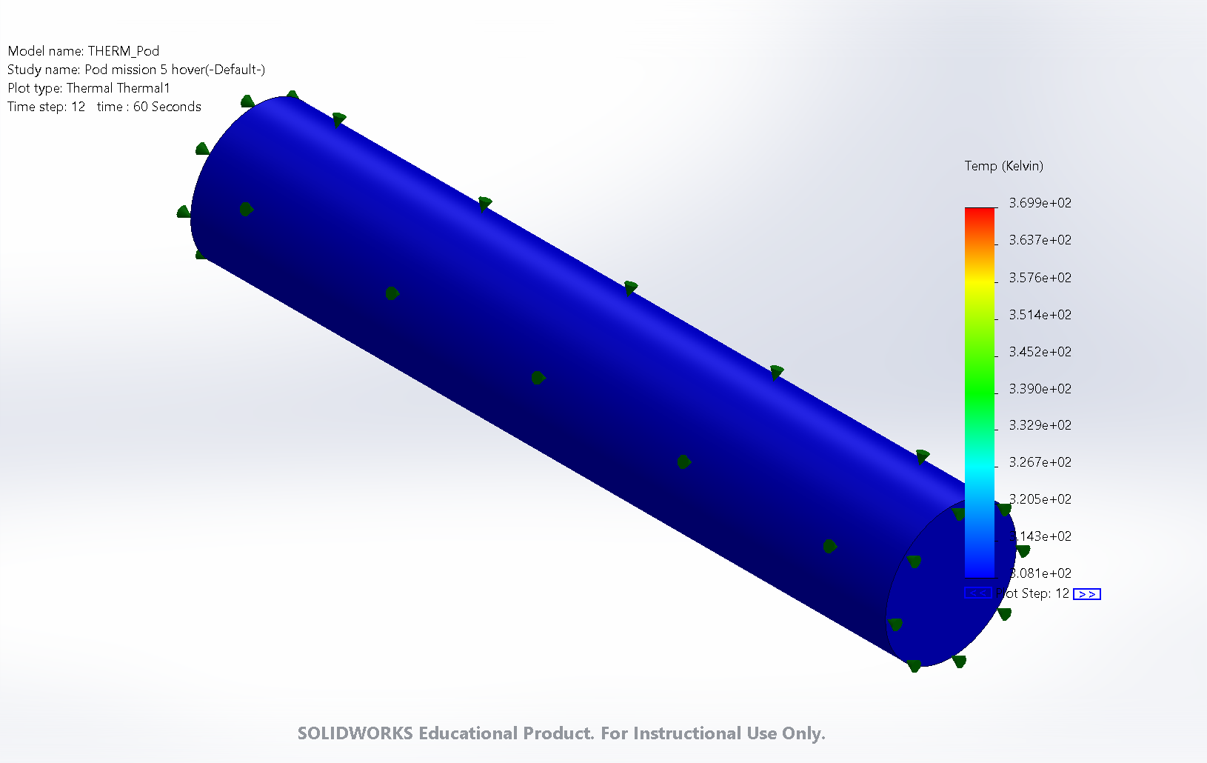
cad/sim/thermal/THERM_Pod_mission.png
