Dalcouffe1/Design-Build-Fly/cad/sim/thermal/THERM_Pusher_steady.png

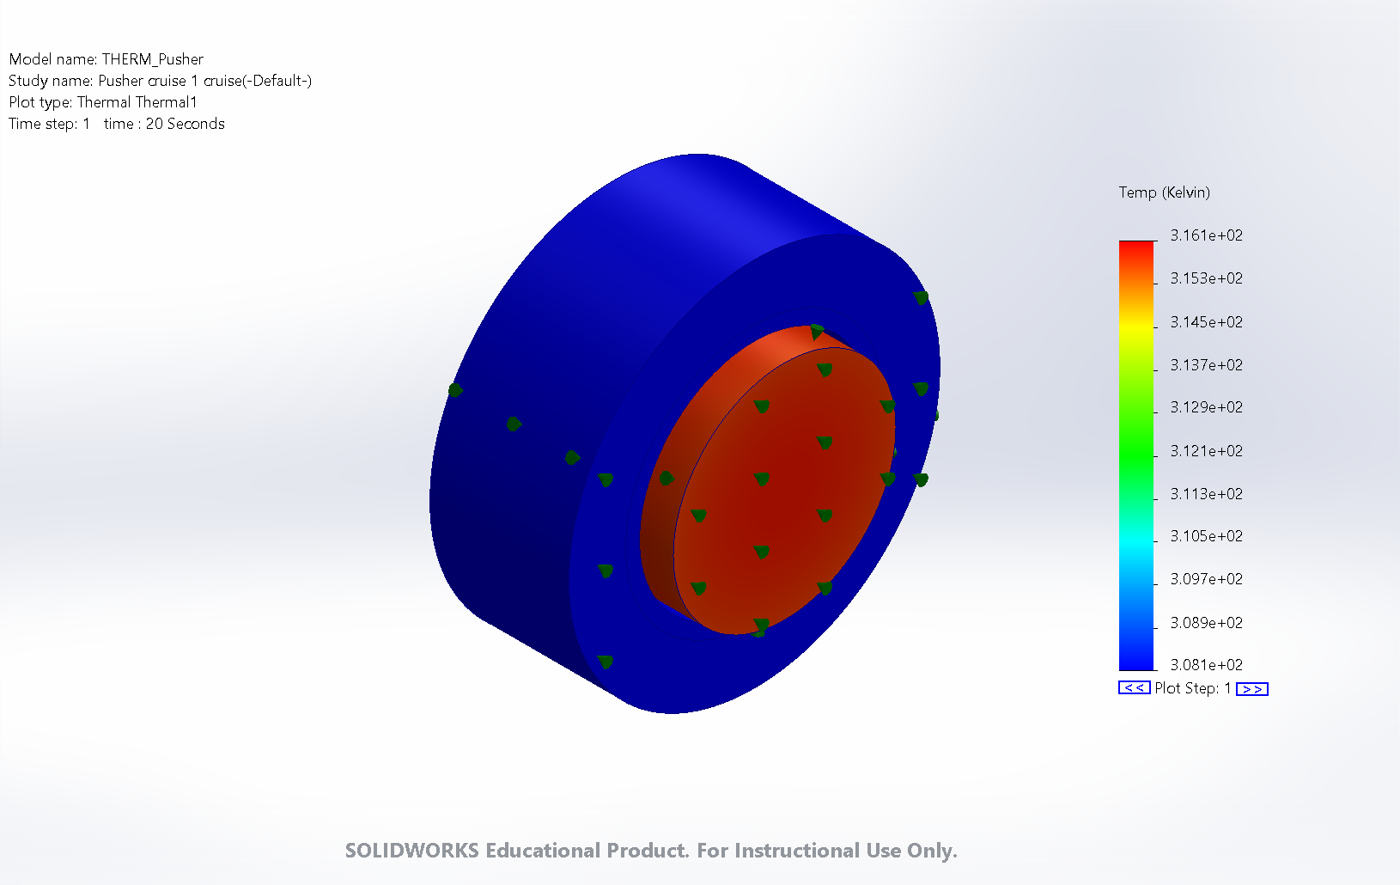
cad/sim/thermal/THERM_Pusher_steady.png
