Dalcouffe1/Design-Build-Fly/docs/reference/lift-cruise-reference.png

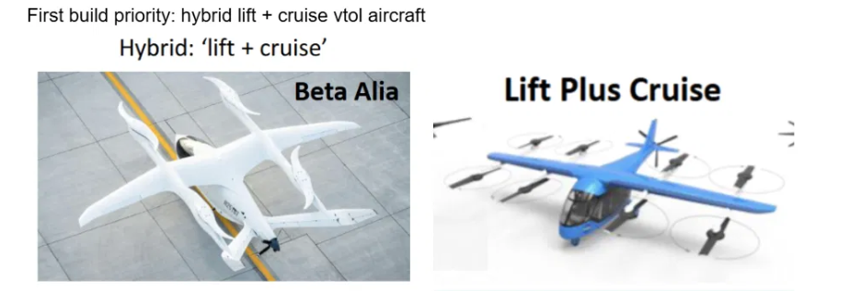
docs/reference/lift-cruise-reference.png
