Dalcouffe1/Design-Build-Fly/cad/mesh/Fuselage_Pod.STL

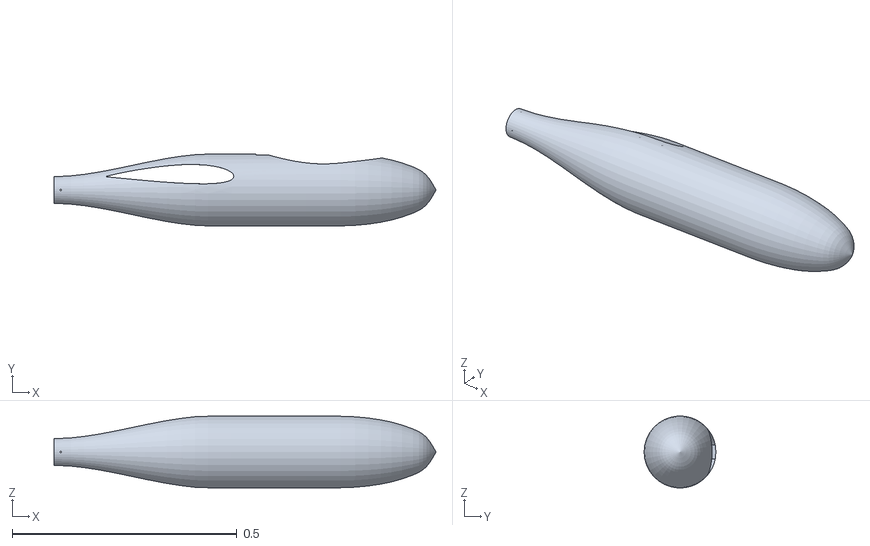
[picture p45: CAD file, 2026-10-25]
cad/mesh/Fuselage_Pod.STL
0.85 x 0.16 x 0.16
