Dalcouffe1/Design-Build-Fly/cad/model/FC_Tray.SLDPRT

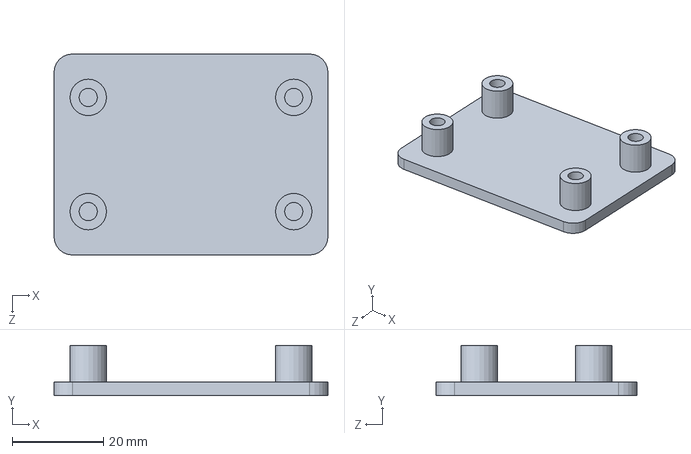
[picture p46: CAD file, 2026-10-25]
cad/model/FC_Tray.SLDPRT
60.0 x 11.0 x 44.0 mm
