Dalcouffe1/Design-Build-Fly/cad/sim/THERM_Lift_Motor.SLDPRT

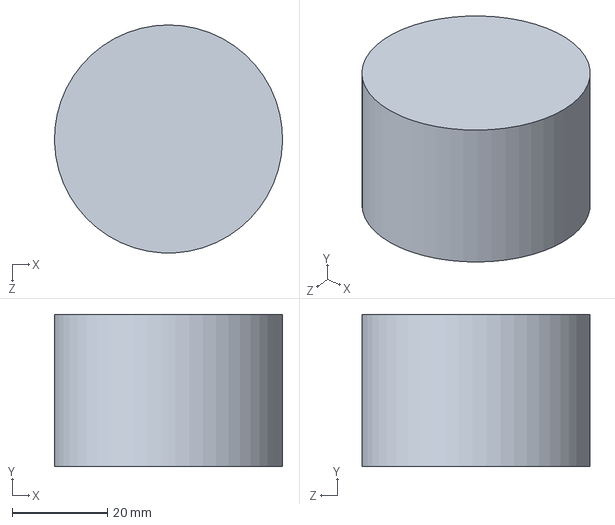
[picture p47: CAD file, 2026-10-25]
cad/sim/THERM_Lift_Motor.SLDPRT
48.0 x 32.0 x 48.0 mm
