Dalcouffe1/Design-Build-Fly/cad/sim/thermal/THERM_Pusher.SLDPRT

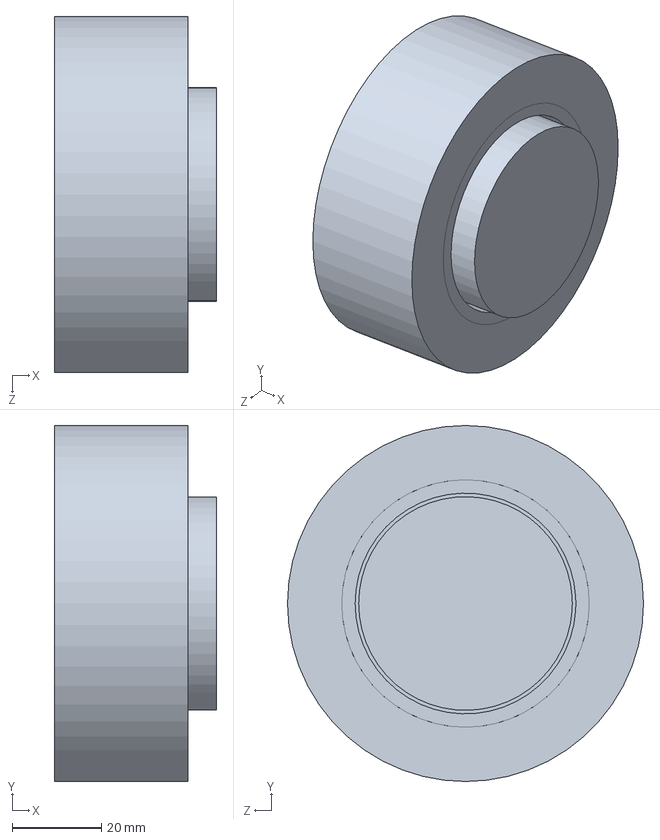
[picture p48: CAD file, 2026-10-25]
cad/sim/thermal/THERM_Pusher.SLDPRT
36.5 x 80.0 x 80.0 mm
