Dalcouffe1/Design-Build-Fly/cad/mesh/Spar_Collar.STL

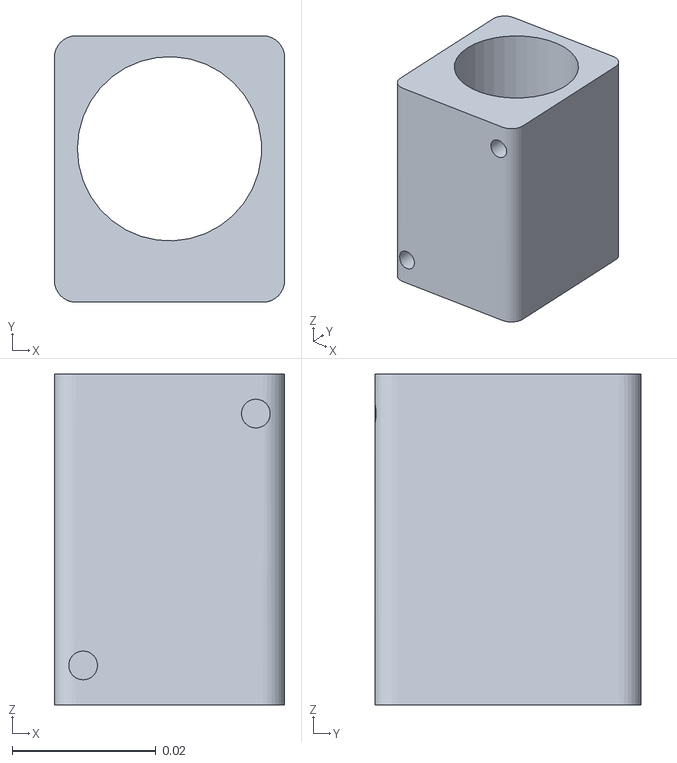
[picture p49: CAD file, 2026-10-25]
cad/mesh/Spar_Collar.STL
0.032 x 0.037 x 0.046
