Dalcouffe1/Design-Build-Fly/cad/model/Pushrod_Rudder.SLDPRT

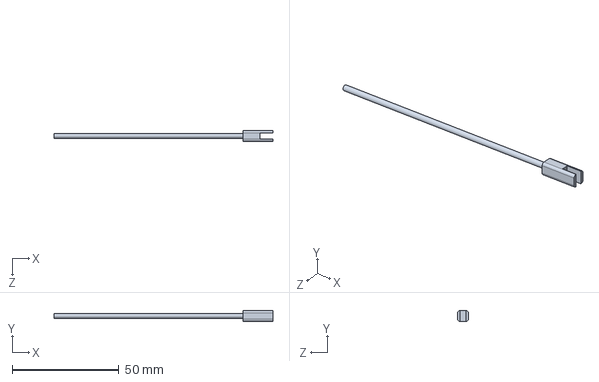
[picture p50: CAD file, 2026-10-25]
cad/model/Pushrod_Rudder.SLDPRT
102.4 x 5.00 x 5.00 mm
