Dalcouffe1/Design-Build-Fly/cad/sim/FEA_Boom_Arm.SLDPRT

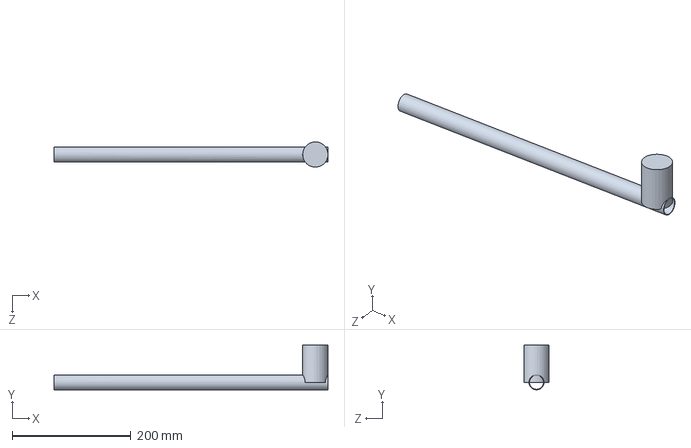
[picture p51: CAD file, 2026-10-25]
cad/sim/FEA_Boom_Arm.SLDPRT
462.0 x 75.4 x 42.7 mm
