Dalcouffe1/Design-Build-Fly/cad/sim/thermal/THERM_Pod.SLDPRT

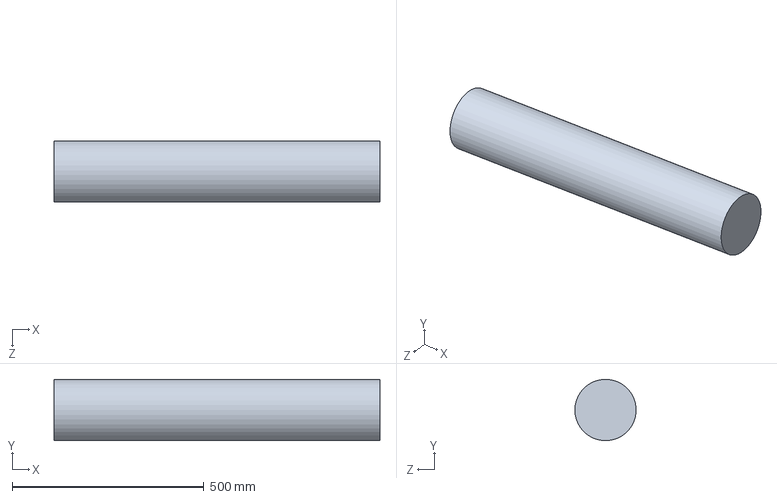
[picture p52: CAD file, 2026-10-25]
cad/sim/thermal/THERM_Pod.SLDPRT
850.0 x 159.9 x 160.0 mm
