Dalcouffe1/Design-Build-Fly/cad/mesh/Pushrod_Aileron.STL

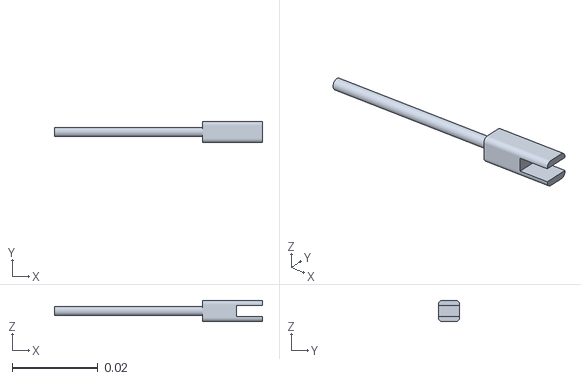
[picture p53: CAD file, 2026-10-25]
cad/mesh/Pushrod_Aileron.STL
0.0484 x 0.005 x 0.005
