Dalcouffe1/Design-Build-Fly/cad/model/Pusher_Motor.SLDPRT

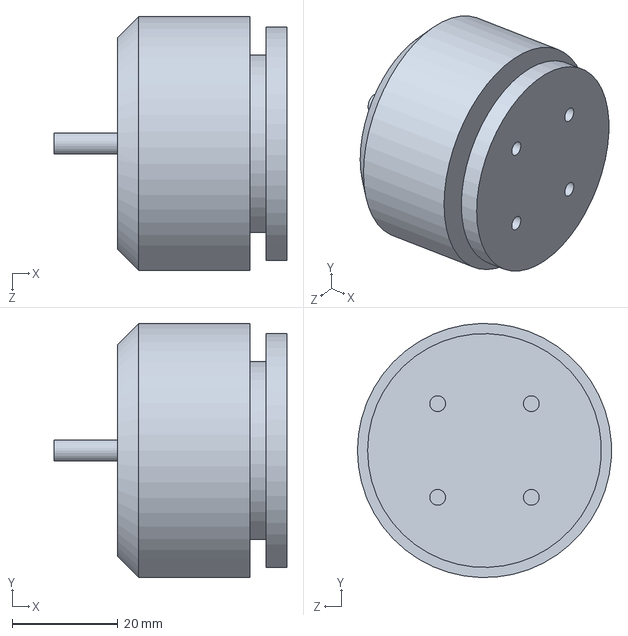
[picture p54: CAD file, 2026-10-25]
cad/model/Pusher_Motor.SLDPRT
44.0 x 48.0 x 48.0 mm
