Dalcouffe1/Design-Build-Fly/cad/sim/FEA_Spar_Joiner.SLDPRT

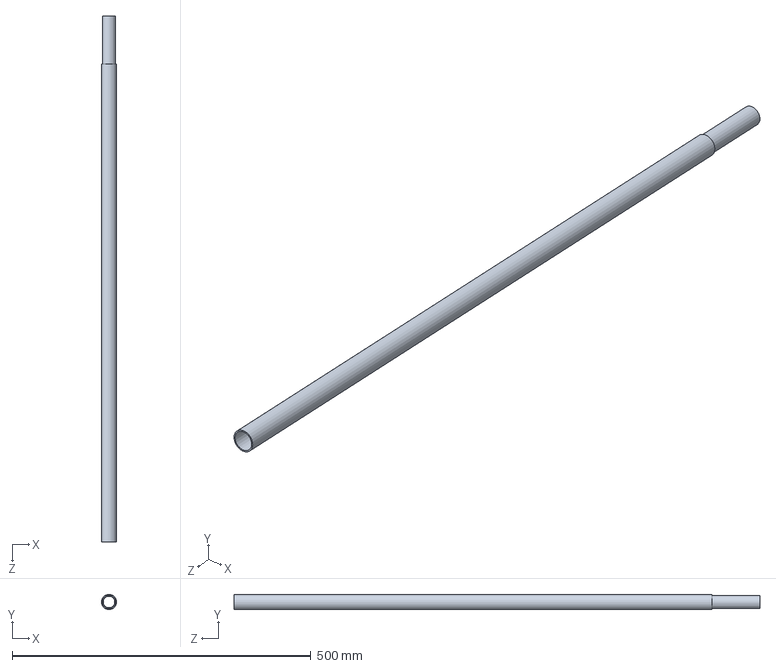
[picture p55: CAD file, 2026-10-25]
cad/sim/FEA_Spar_Joiner.SLDPRT
25.4 x 25.2 x 880.0 mm
