Dalcouffe1/Design-Build-Fly/cad/sim/thermal/THERM_Lift_Unit.SLDPRT

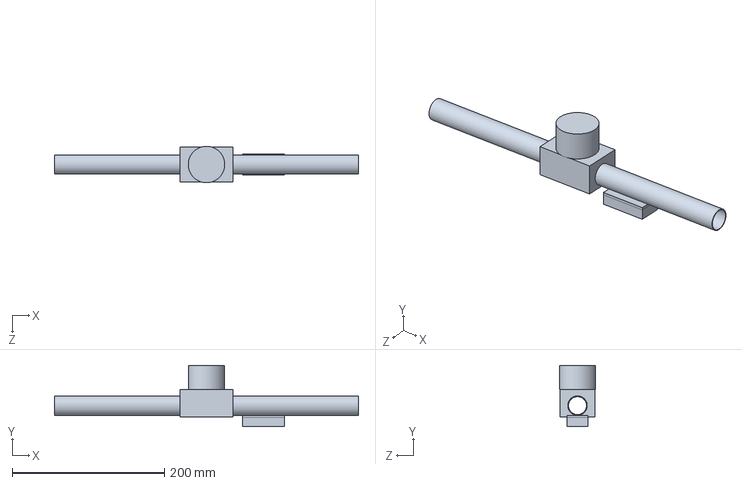
[picture p56: CAD file, 2026-10-25]
cad/sim/thermal/THERM_Lift_Unit.SLDPRT
400.0 x 80.7 x 48.0 mm
