Dalcouffe1/Design-Build-Fly/cad/mesh/H_Tail.STL

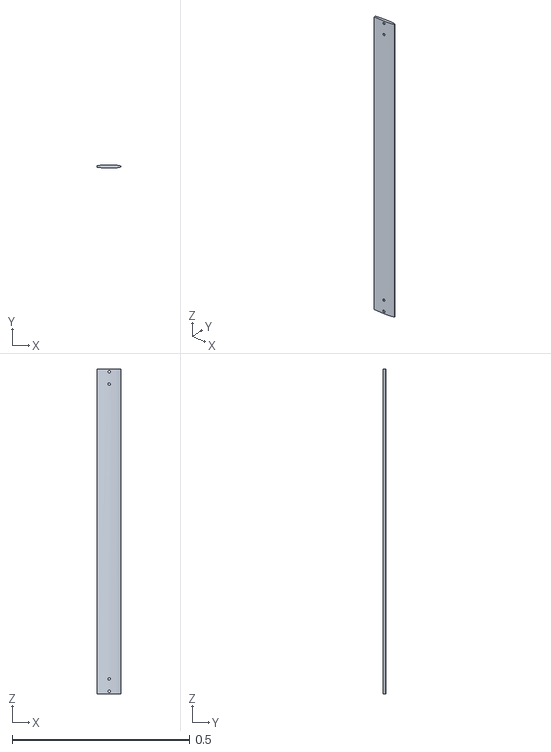
[picture p57: CAD file, 2026-10-25]
cad/mesh/H_Tail.STL
0.069 x 0.00914 x 0.917
