Dalcouffe1/Design-Build-Fly/cad/model/Fin_Shoe.SLDPRT

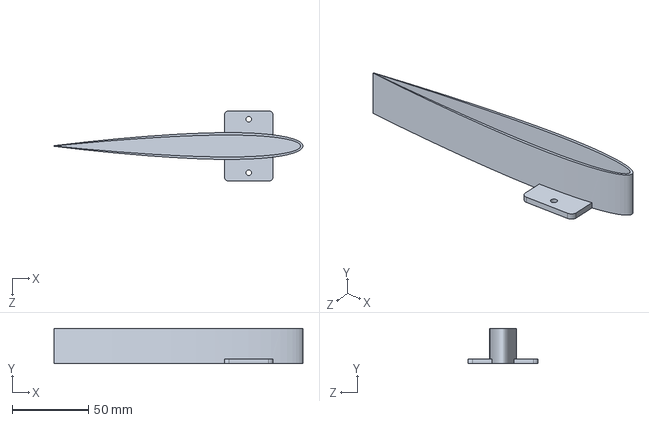
[picture p58: CAD file, 2026-10-25]
cad/model/Fin_Shoe.SLDPRT
162.9 x 23.0 x 46.0 mm
