Dalcouffe1/Design-Build-Fly/cad/mesh/Fin_Shoe.STL

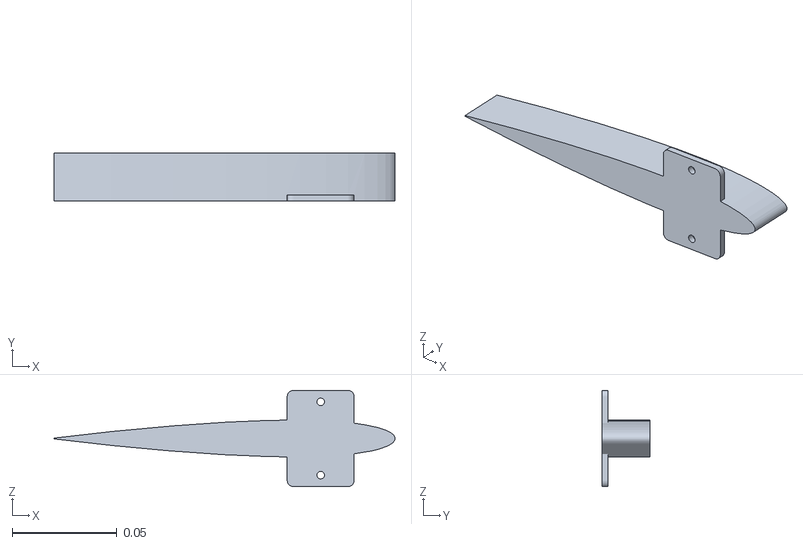
[picture p59: CAD file, 2026-10-25]
cad/mesh/Fin_Shoe.STL
0.163 x 0.023 x 0.046
