Dalcouffe1/Design-Build-Fly/cad/model/Boom_Rear_Stub.SLDPRT

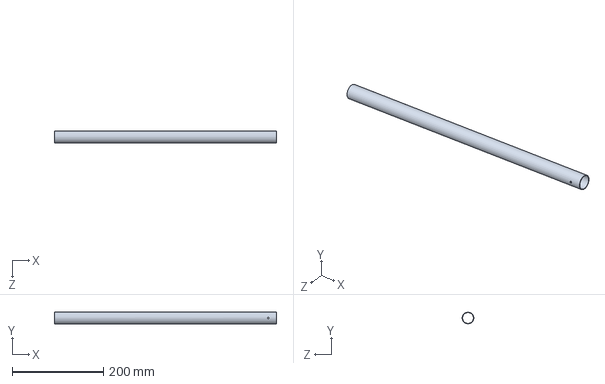
[picture p60: CAD file, 2026-10-25]
cad/model/Boom_Rear_Stub.SLDPRT
485.9 x 25.3 x 25.4 mm
