Dalcouffe1/Design-Build-Fly/cad/mesh/Boom_Clamp_R_Upper.STL

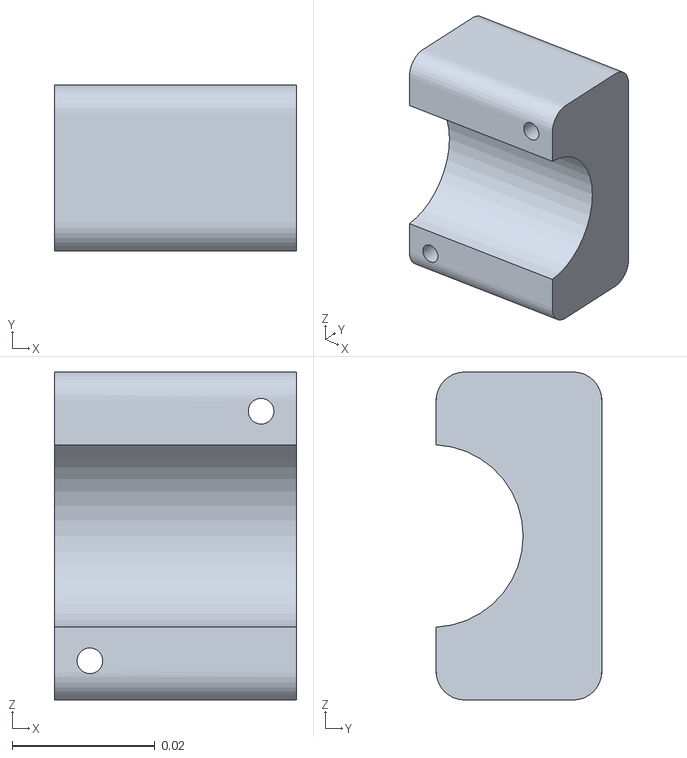
[picture p61: CAD file, 2026-10-25]
cad/mesh/Boom_Clamp_R_Upper.STL
0.034 x 0.0232 x 0.046
