Dalcouffe1/Design-Build-Fly/cad/model/Tail_Clamp_Cap.SLDPRT

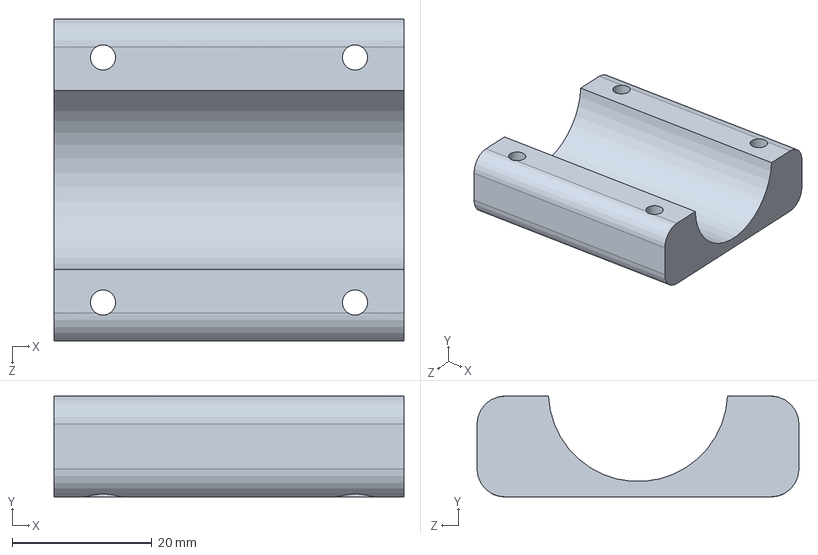
[picture p62: CAD file, 2026-10-25]
cad/model/Tail_Clamp_Cap.SLDPRT
50.0 x 14.4 x 46.0 mm
