Dalcouffe1/Design-Build-Fly/cad/mesh/Fin.STL

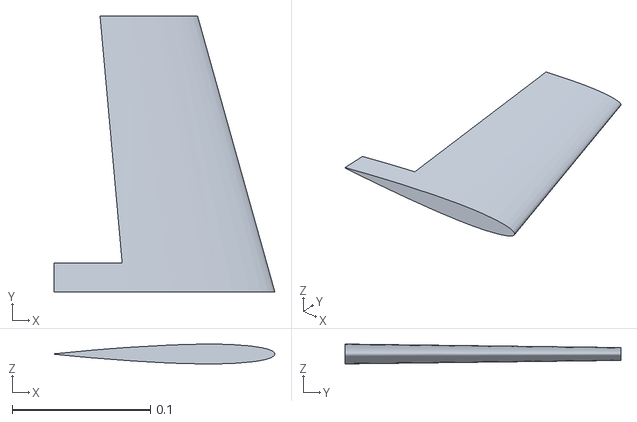
[picture p63: CAD file, 2026-10-25]
cad/mesh/Fin.STL
0.16 x 0.2 x 0.0144
