Dalcouffe1/Design-Build-Fly/cad/model/Battery_Tray.SLDPRT

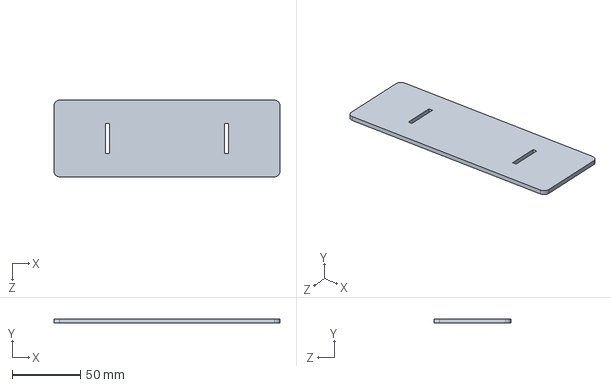
[picture p64: CAD file, 2026-10-25]
cad/model/Battery_Tray.SLDPRT
165.0 x 3.00 x 56.0 mm
