Dalcouffe1/Design-Build-Fly/cad/mesh/Boom_Clamp_F_Upper.STL

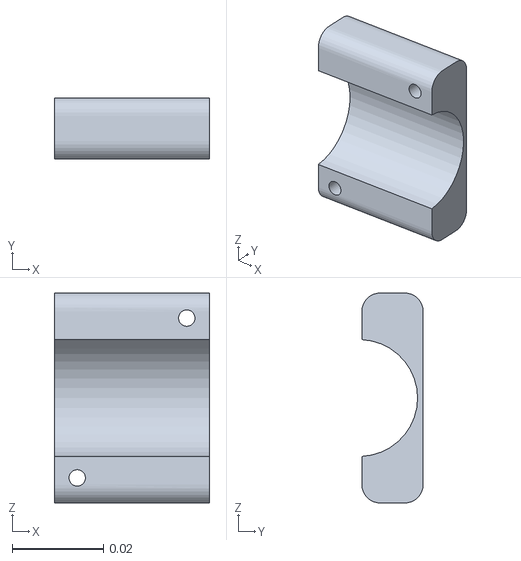
[picture p65: CAD file, 2026-10-25]
cad/mesh/Boom_Clamp_F_Upper.STL
0.034 x 0.0134 x 0.046
