Dalcouffe1/Design-Build-Fly/cad/model/Horn_Backplate.SLDPRT

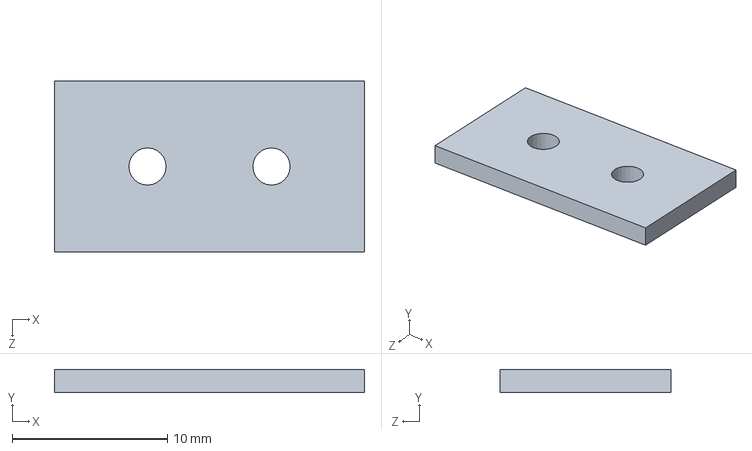
[picture p66: CAD file, 2026-10-25]
cad/model/Horn_Backplate.SLDPRT
20.0 x 1.50 x 11.0 mm
