Dalcouffe1/Design-Build-Fly/cad/mesh/Boom_Front.STL

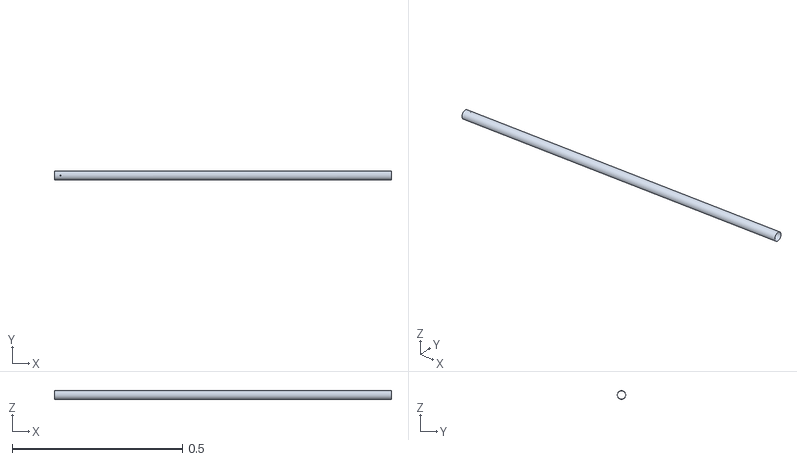
[picture p67: CAD file, 2026-10-25]
cad/mesh/Boom_Front.STL
0.991 x 0.0253 x 0.0254
