Dalcouffe1/Design-Build-Fly/cad/model/Pushrod_Aileron.SLDPRT

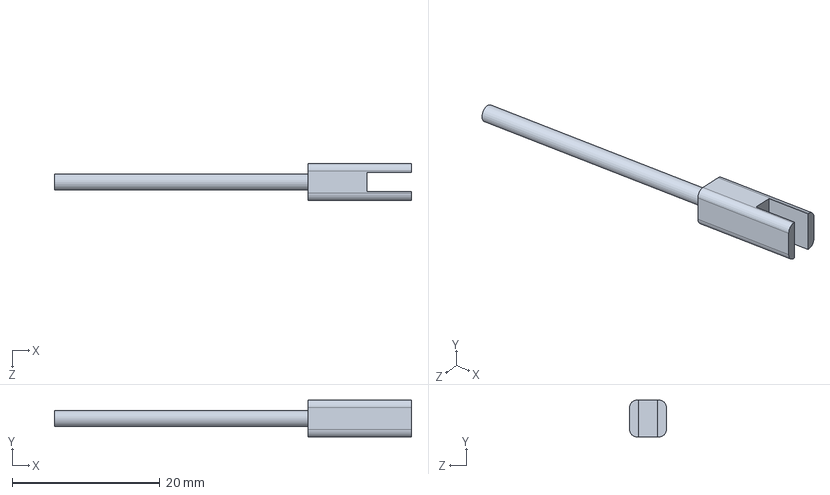
[picture p68: CAD file, 2026-10-25]
cad/model/Pushrod_Aileron.SLDPRT
48.4 x 5.00 x 5.00 mm
