Dalcouffe1/Design-Build-Fly/cad/mesh/Aileron_R.STL

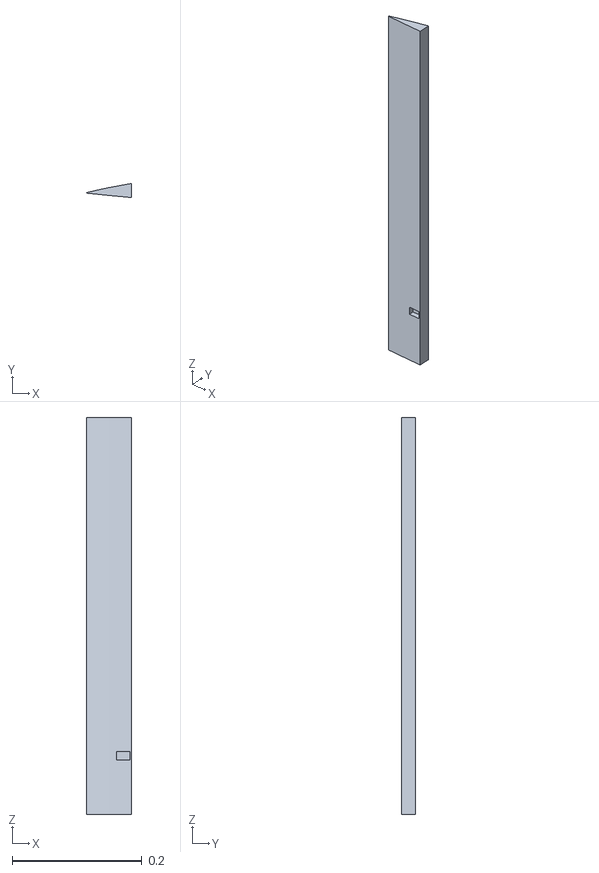
[picture p69: CAD file, 2026-10-25]
cad/mesh/Aileron_R.STL
0.0693 x 0.0218 x 0.612
