Dalcouffe1/Design-Build-Fly/cad/model/Lift_Prop.SLDPRT

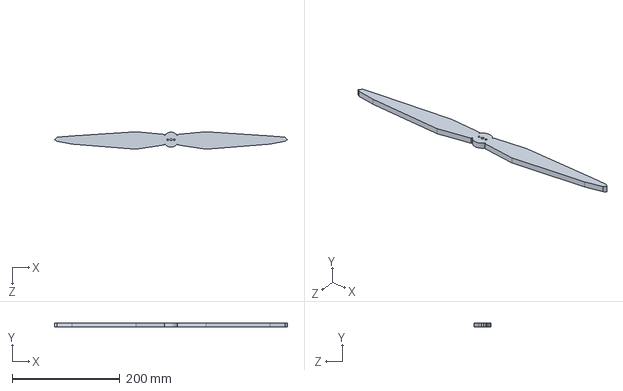
[picture p70: CAD file, 2026-10-25]
cad/model/Lift_Prop.SLDPRT
431.8 x 8.00 x 32.4 mm
