Dalcouffe1/Design-Build-Fly/cad/mesh/Rudder.STL

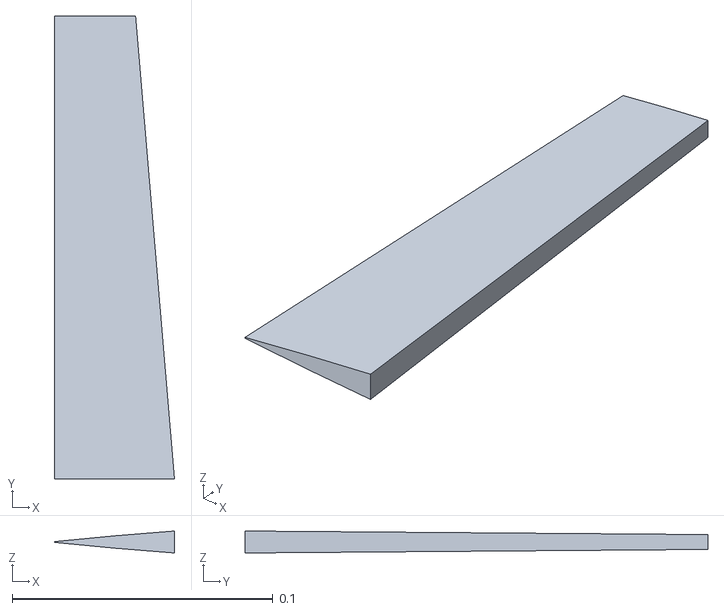
[picture p71: CAD file, 2026-10-25]
cad/mesh/Rudder.STL
0.0461 x 0.178 x 0.00843
