Dalcouffe1/Design-Build-Fly/cad/model/Wing_Joiner.SLDPRT

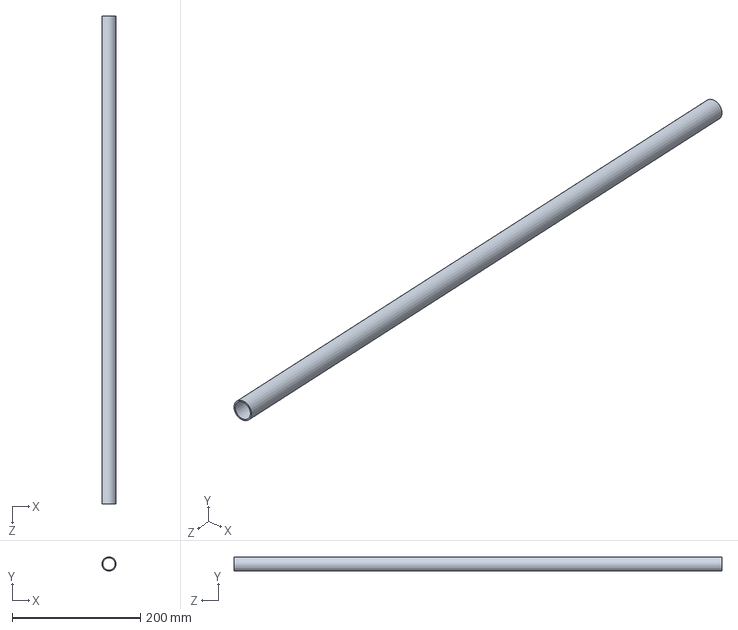
[picture p72: CAD file, 2026-10-25]
cad/model/Wing_Joiner.SLDPRT
22.2 x 22.1 x 760.0 mm
