Dalcouffe1/Design-Build-Fly/cad/mesh/Crush_Sleeve.STL

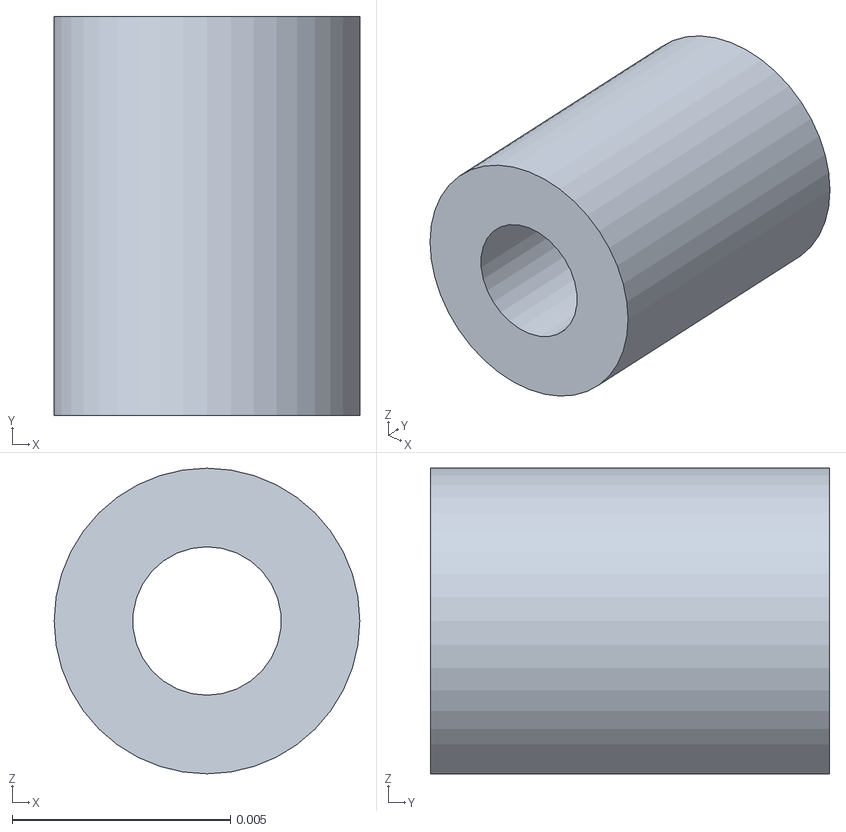
[picture p73: CAD file, 2026-10-25]
cad/mesh/Crush_Sleeve.STL
0.007 x 0.00914 x 0.007
