Dalcouffe1/Design-Build-Fly/cad/model/I01_M3_Insert.SLDPRT

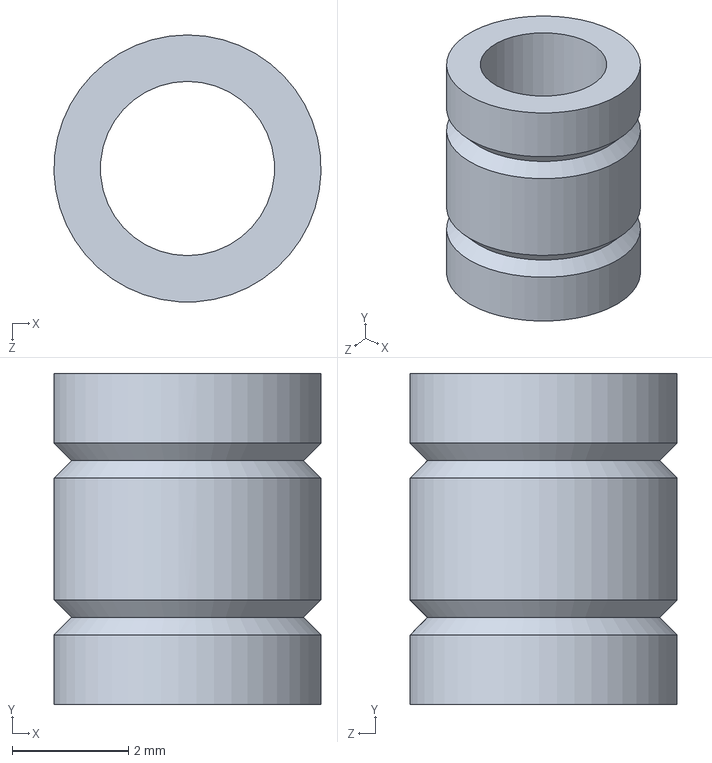
[picture p74: CAD file, 2026-10-25]
cad/model/I01_M3_Insert.SLDPRT
4.60 x 5.70 x 4.60 mm
