Dalcouffe1/Design-Build-Fly/cad/mesh/Pushrod_Rudder.STL

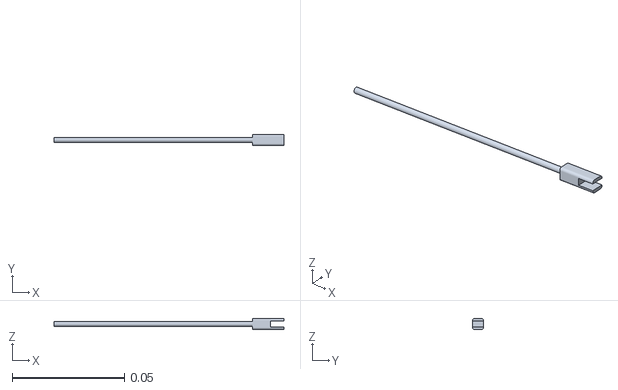
[picture p75: CAD file, 2026-10-25]
cad/mesh/Pushrod_Rudder.STL
0.102 x 0.005 x 0.005
