Dalcouffe1/Design-Build-Fly/cad/mesh/Elevator.STL

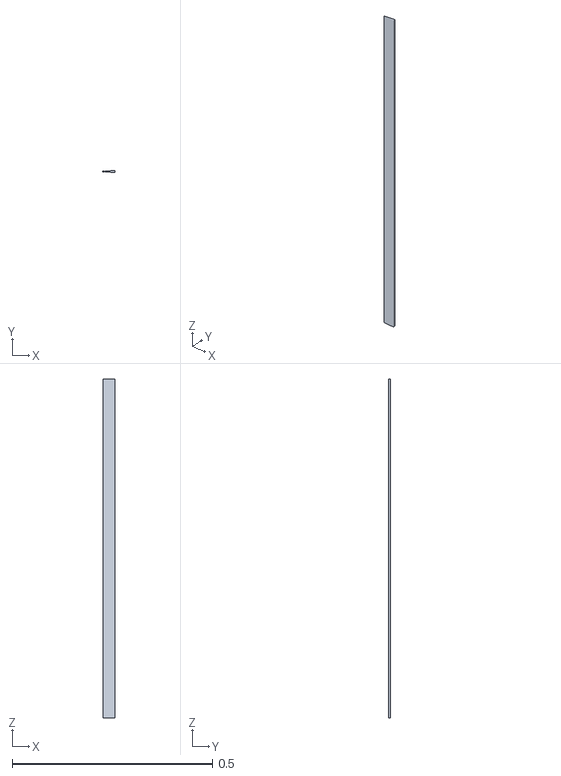
[picture p76: CAD file, 2026-10-25]
cad/mesh/Elevator.STL
0.0305 x 0.00558 x 0.846
