Dalcouffe1/Design-Build-Fly/cad/model/Crush_Sleeve.SLDPRT

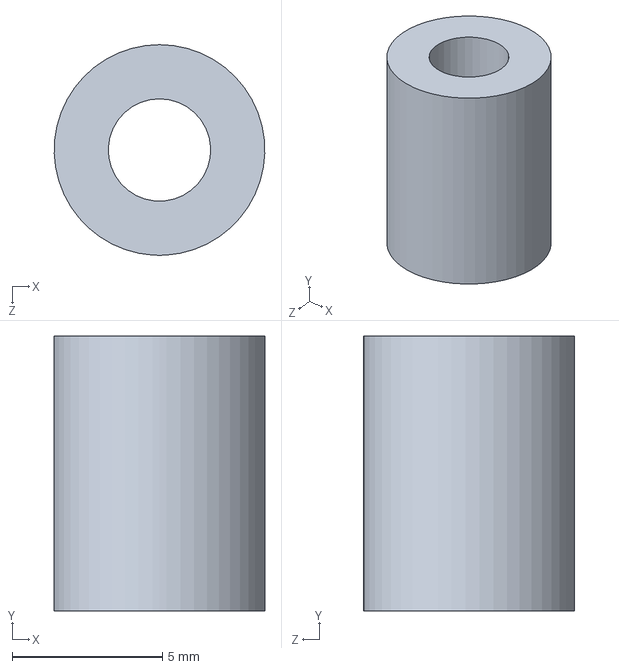
[picture p77: CAD file, 2026-10-25]
cad/model/Crush_Sleeve.SLDPRT
7.00 x 9.14 x 7.00 mm
