Dalcouffe1/Design-Build-Fly/cad/mesh/Wing_Panel_L.STL

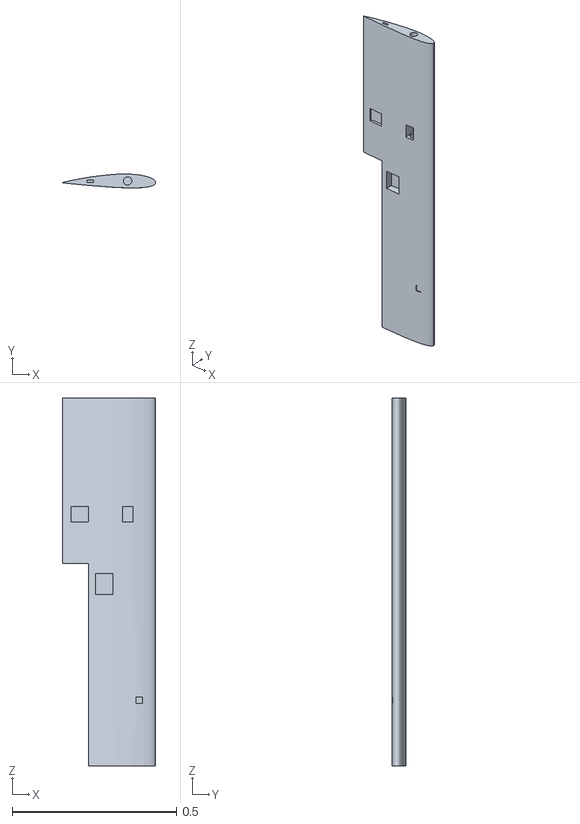
[picture p78: CAD file, 2026-10-25]
cad/mesh/Wing_Panel_L.STL
0.284 x 0.0428 x 1.12
