Dalcouffe1/Design-Build-Fly/cad/model/F09_M5x20_BHCS.SLDPRT

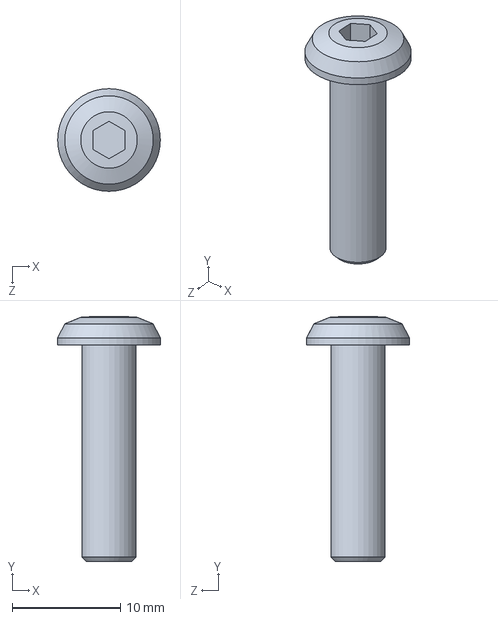
[picture p79: CAD file, 2026-10-25]
cad/model/F09_M5x20_BHCS.SLDPRT
9.50 x 22.7 x 9.50 mm
