Dalcouffe1/Design-Build-Fly/cad/mesh/Wing_Saddle.STL

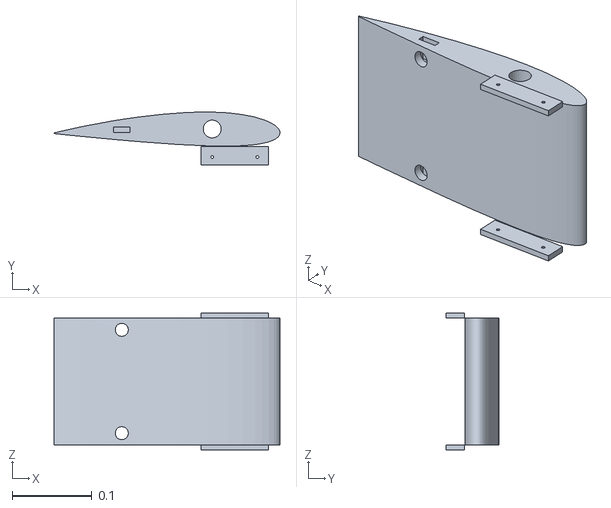
[picture p80: CAD file, 2026-10-25]
cad/mesh/Wing_Saddle.STL
0.284 x 0.0668 x 0.172
