Dalcouffe1/Design-Build-Fly/cad/mesh/Aileron_L.STL

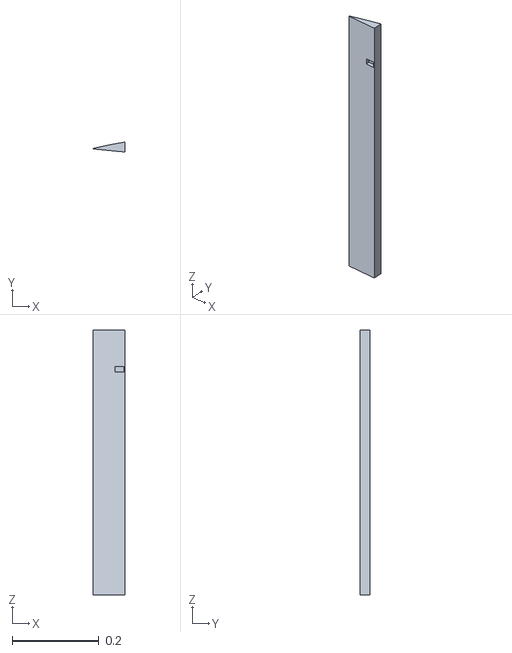
[picture p81: CAD file, 2026-10-25]
cad/mesh/Aileron_L.STL
0.0739 x 0.0232 x 0.612
