Dalcouffe1/Design-Build-Fly/cad/model/Wing_Panel_R.SLDPRT

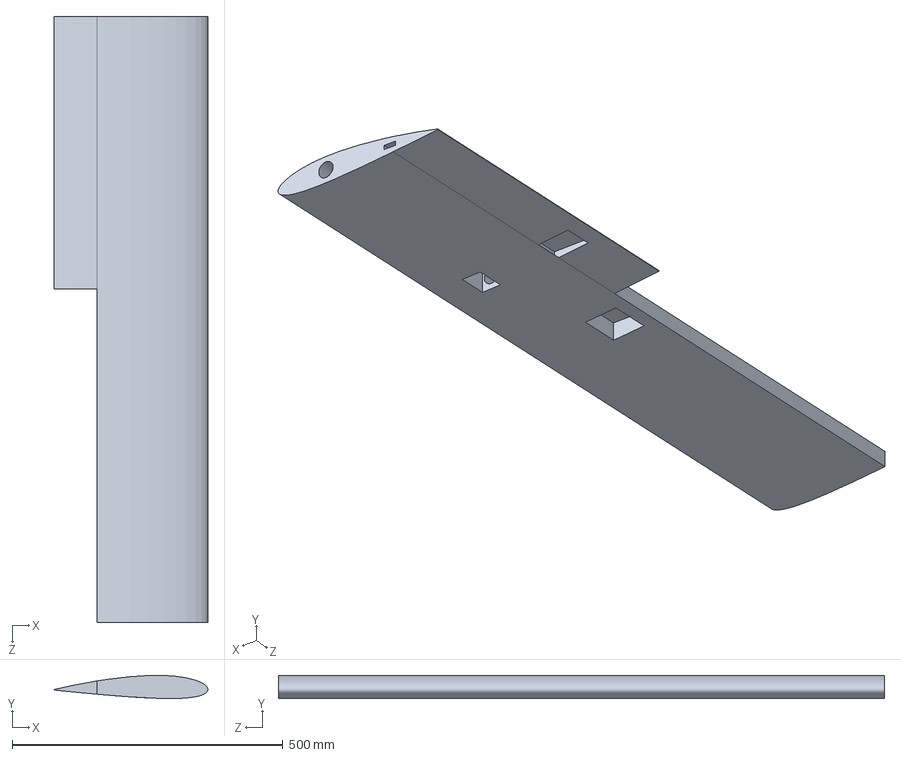
[picture p82: CAD file, 2026-10-25]
cad/model/Wing_Panel_R.SLDPRT
284.2 x 42.7 x 1120.0 mm
