Dalcouffe1/Design-Build-Fly/cad/model/N01_M3_Nylock.SLDPRT

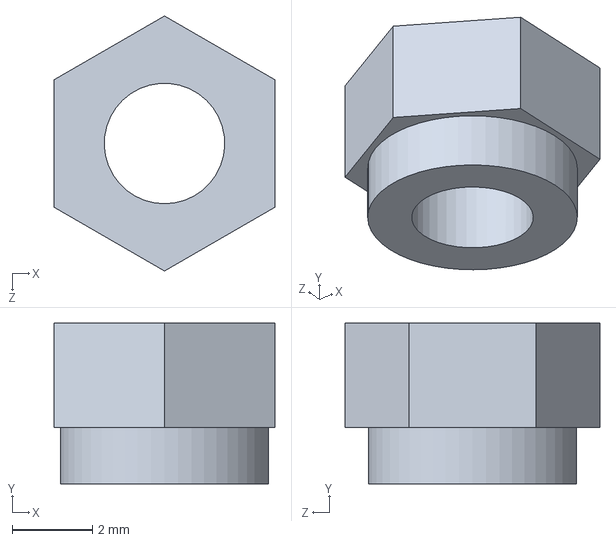
[picture p83: CAD file, 2026-10-25]
cad/model/N01_M3_Nylock.SLDPRT
5.50 x 4.00 x 6.35 mm
