Dalcouffe1/Design-Build-Fly/cad/model/Battery_6S_LiPo.SLDPRT

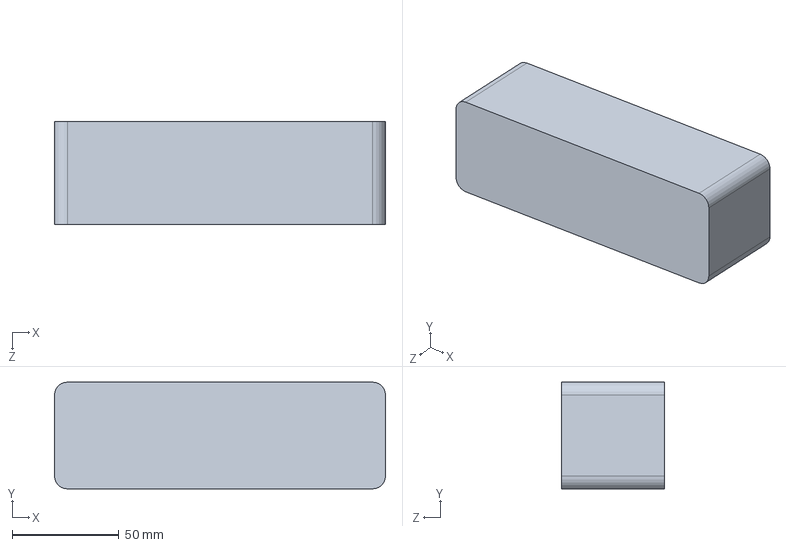
[picture p84: CAD file, 2026-10-25]
cad/model/Battery_6S_LiPo.SLDPRT
155.0 x 50.0 x 48.0 mm
