Dalcouffe1/Design-Build-Fly/cad/mesh/Pushrod_Elevator.STL

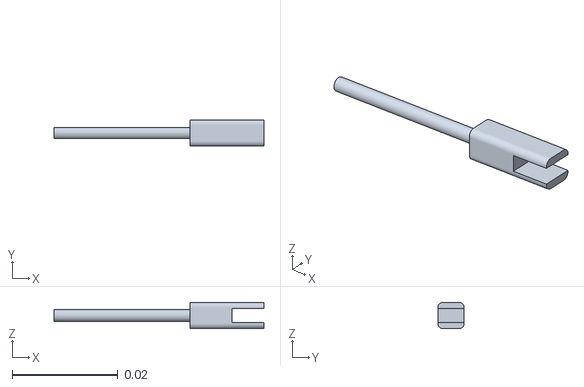
[picture p85: CAD file, 2026-10-25]
cad/mesh/Pushrod_Elevator.STL
0.0396 x 0.005 x 0.005
