Dalcouffe1/Design-Build-Fly/cad/model/Rear_Hardpoint.SLDPRT

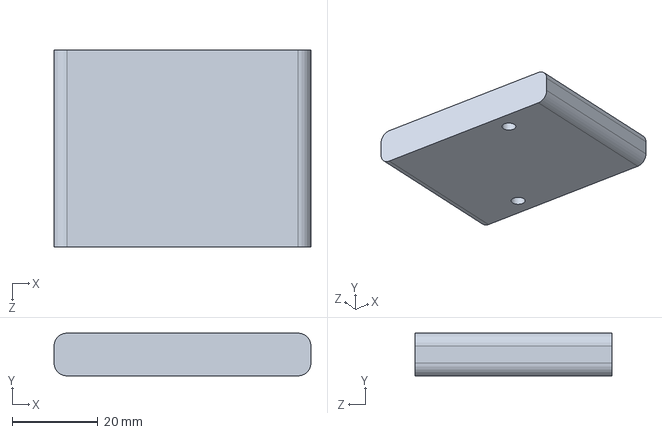
[picture p86: CAD file, 2026-10-25]
cad/model/Rear_Hardpoint.SLDPRT
60.0 x 10.0 x 46.0 mm
