Dalcouffe1/Design-Build-Fly/cad/mesh/Gear_Fairing.STL

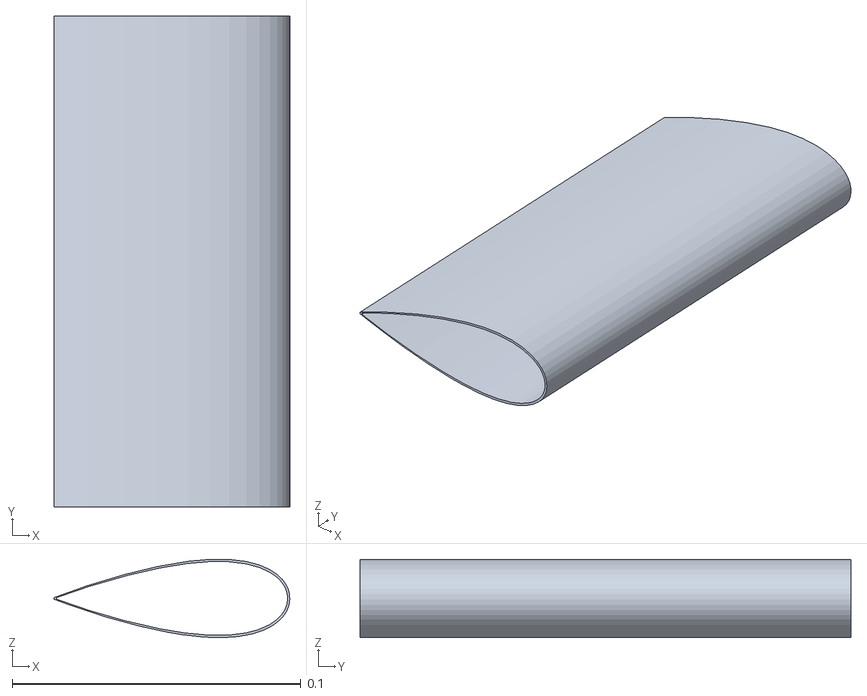
[picture p87: CAD file, 2026-10-25]
cad/mesh/Gear_Fairing.STL
0.0816 x 0.17 x 0.0271
