Dalcouffe1/Design-Build-Fly/cad/model/Tail_Clamp_Upper.SLDPRT

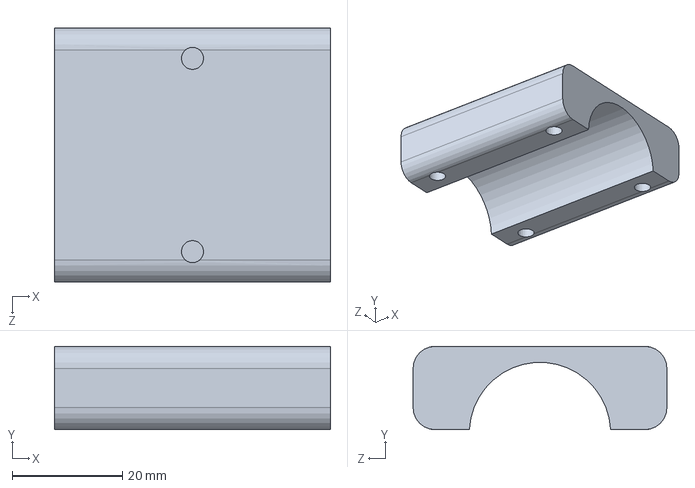
[picture p88: CAD file, 2026-10-25]
cad/model/Tail_Clamp_Upper.SLDPRT
50.0 x 15.1 x 46.0 mm
