Dalcouffe1/Design-Build-Fly/cad/mesh/N02_M5_Nylock.STL

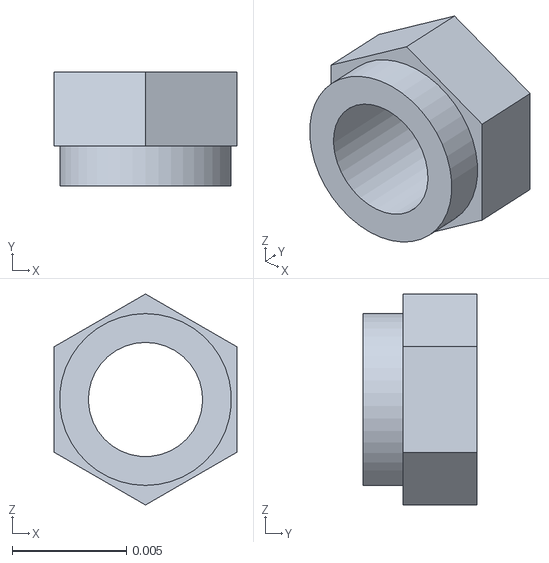
[picture p89: CAD file, 2026-10-22]
cad/mesh/N02_M5_Nylock.STL
0.008 x 0.005 x 0.00924
