Dalcouffe1/Design-Build-Fly/cad/model/Motor_Mount_Cap.SLDPRT

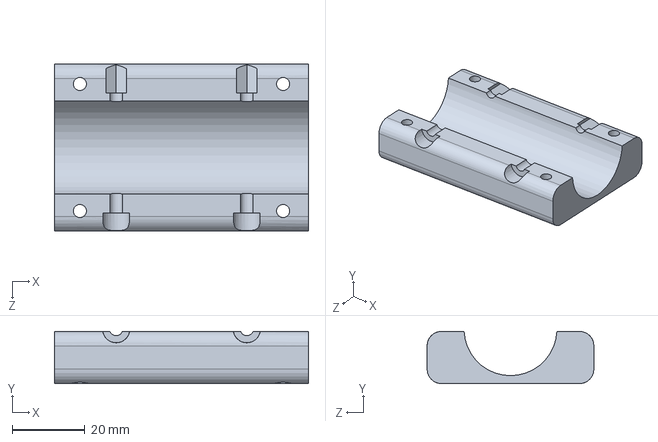
[picture p90: CAD file, 2026-10-25]
cad/model/Motor_Mount_Cap.SLDPRT
70.0 x 14.4 x 46.0 mm
