Dalcouffe1/Design-Build-Fly/cad/model/F05_M3x30_SHCS.SLDPRT

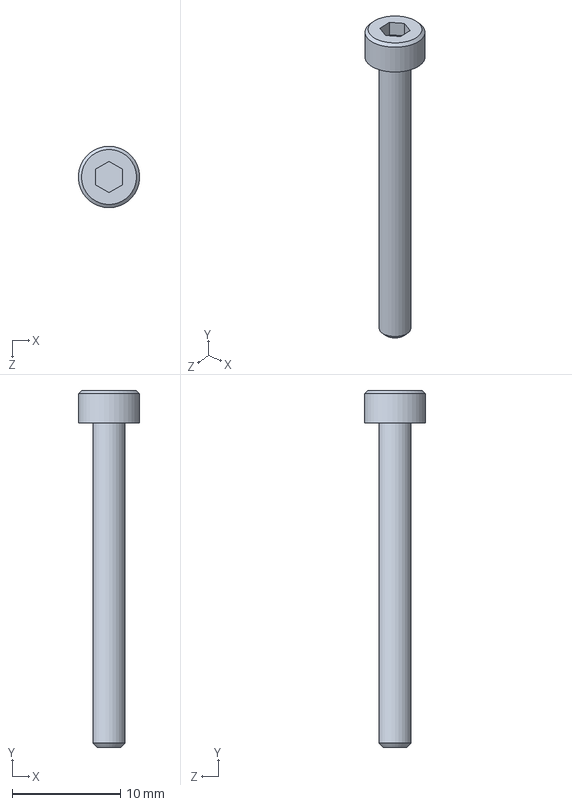
[picture p91: CAD file, 2026-10-25]
cad/model/F05_M3x30_SHCS.SLDPRT
5.66 x 33.0 x 5.68 mm
