Dalcouffe1/Design-Build-Fly/cad/mesh/Battery_Tray.STL

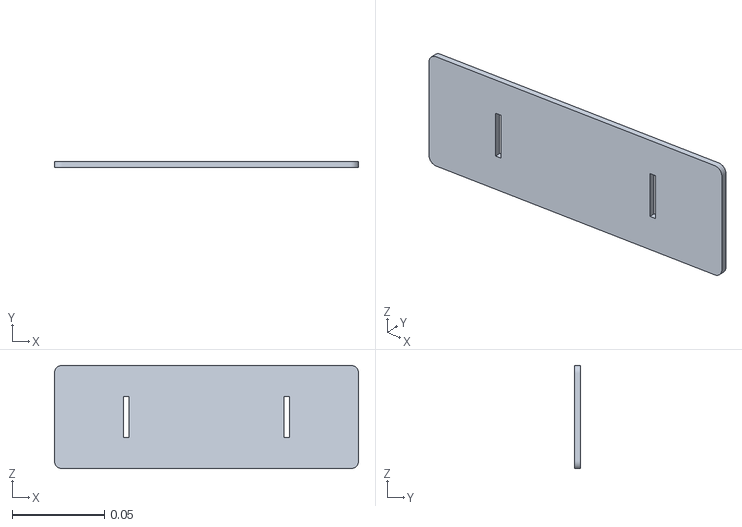
[picture p92: CAD file, 2026-10-22]
cad/mesh/Battery_Tray.STL
0.165 x 0.003 x 0.056
