Dalcouffe1/Design-Build-Fly/cad/model/Servo_Tray.SLDPRT

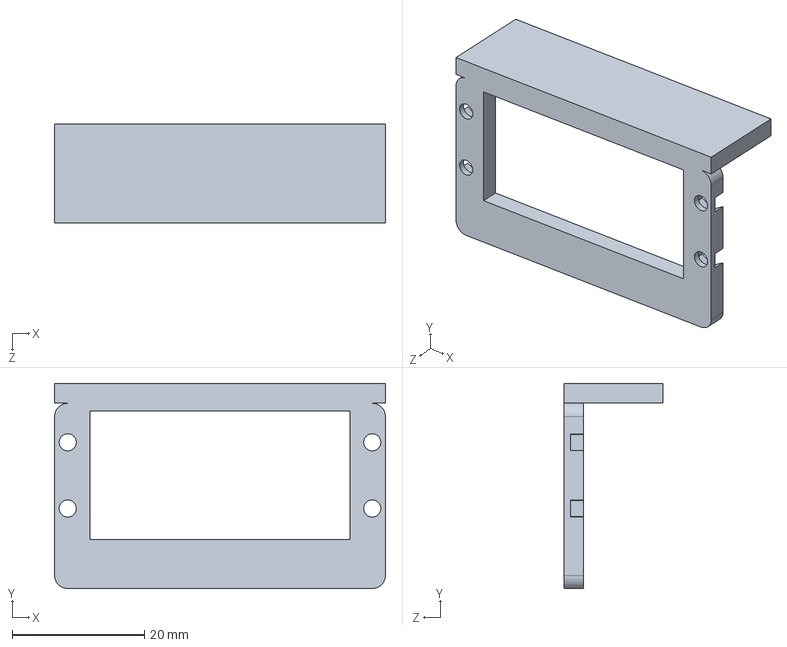
[picture p93: CAD file, 2026-10-25]
cad/model/Servo_Tray.SLDPRT
50.0 x 31.0 x 15.0 mm
