Dalcouffe1/Design-Build-Fly/cad/mesh/Lift_Motor.STL

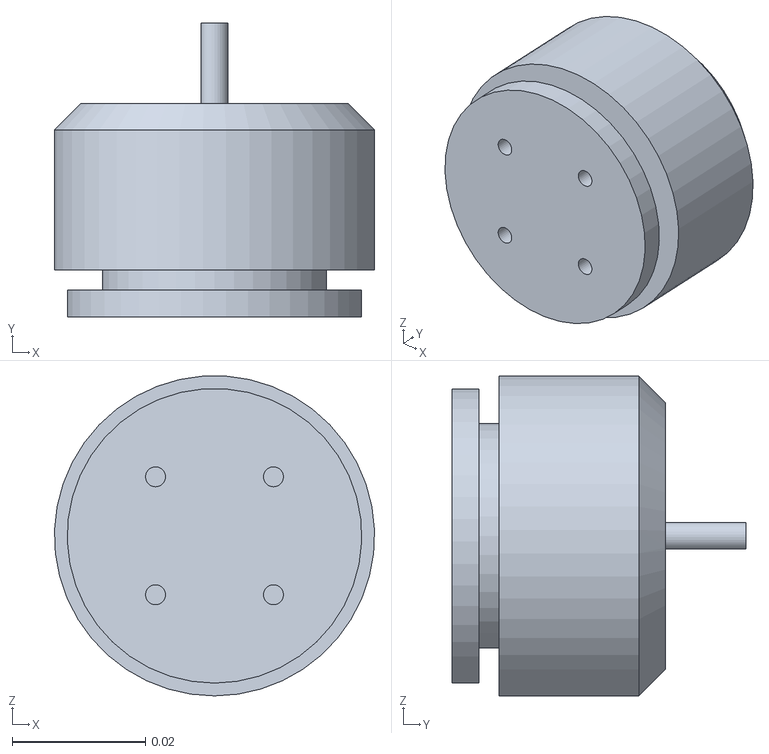
[picture p94: CAD file, 2026-10-22]
cad/mesh/Lift_Motor.STL
0.048 x 0.044 x 0.0479
