Dalcouffe1/Design-Build-Fly/cad/model/Aileron_R.SLDPRT

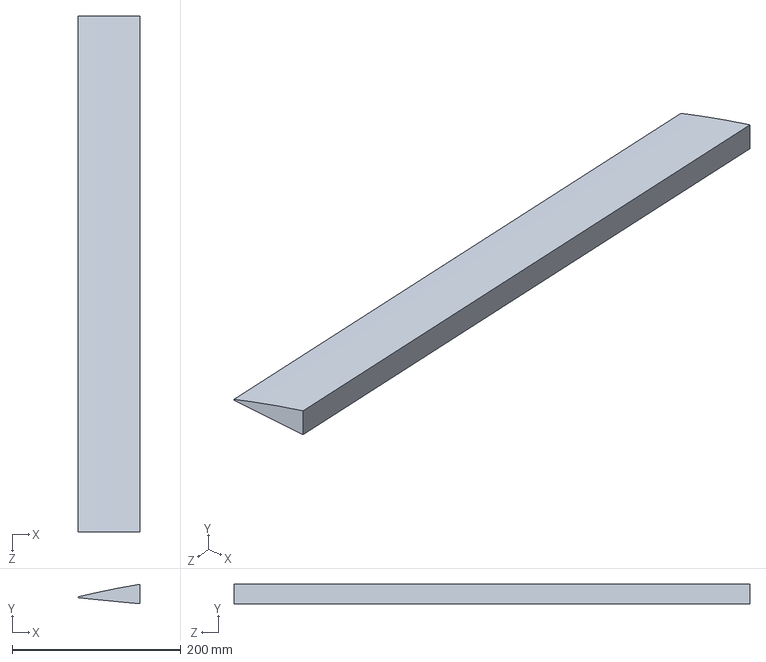
[picture p95: CAD file, 2026-10-25]
cad/model/Aileron_R.SLDPRT
73.9 x 23.2 x 612.0 mm
