Dalcouffe1/Design-Build-Fly/cad/mesh/Flight_Controller.STL

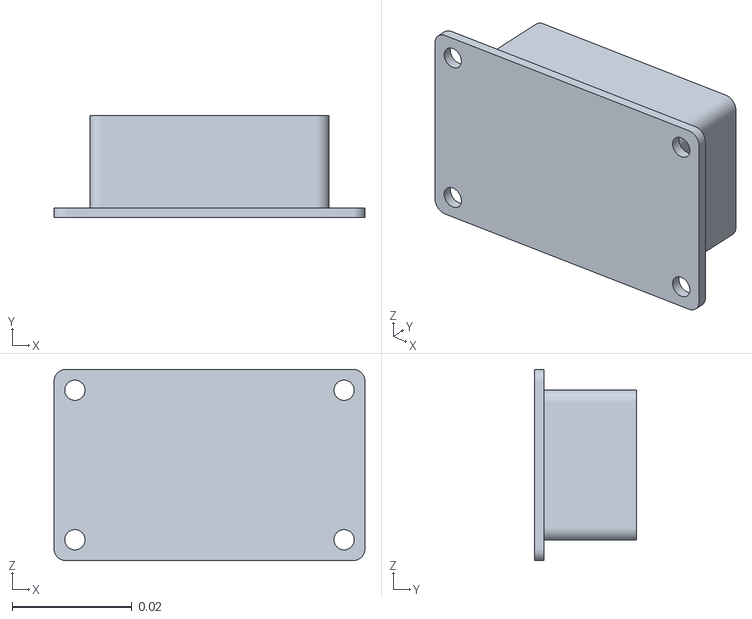
[picture p96: CAD file, 2026-10-22]
cad/mesh/Flight_Controller.STL
0.052 x 0.017 x 0.032
