Dalcouffe1/Design-Build-Fly/cad/model/Root_Tongue.SLDPRT

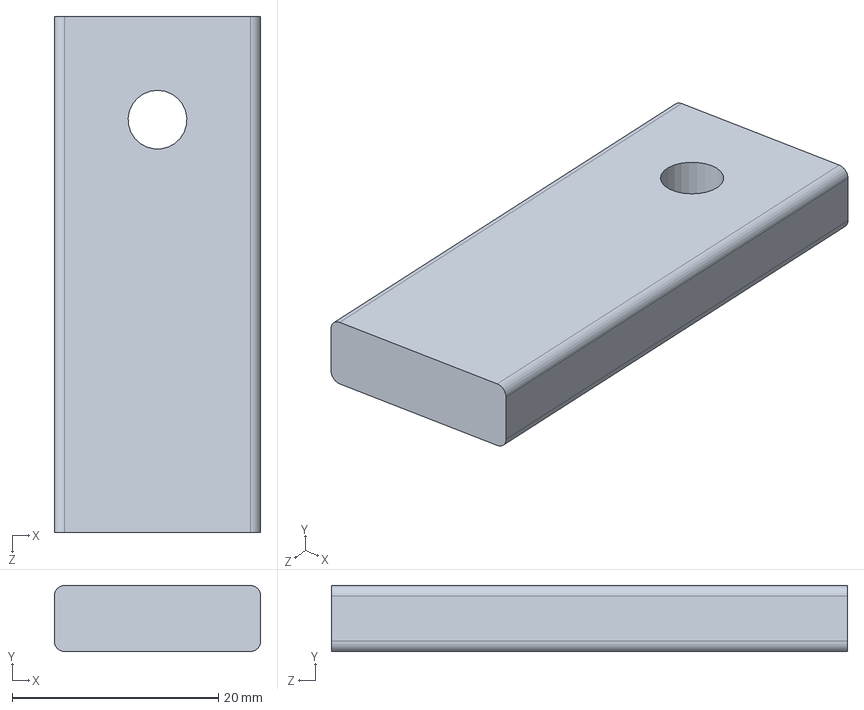
[picture p97: CAD file, 2026-10-25]
cad/model/Root_Tongue.SLDPRT
20.0 x 6.40 x 50.0 mm
