Dalcouffe1/Design-Build-Fly/cad/mesh/F02_M3x16_SHCS.STL

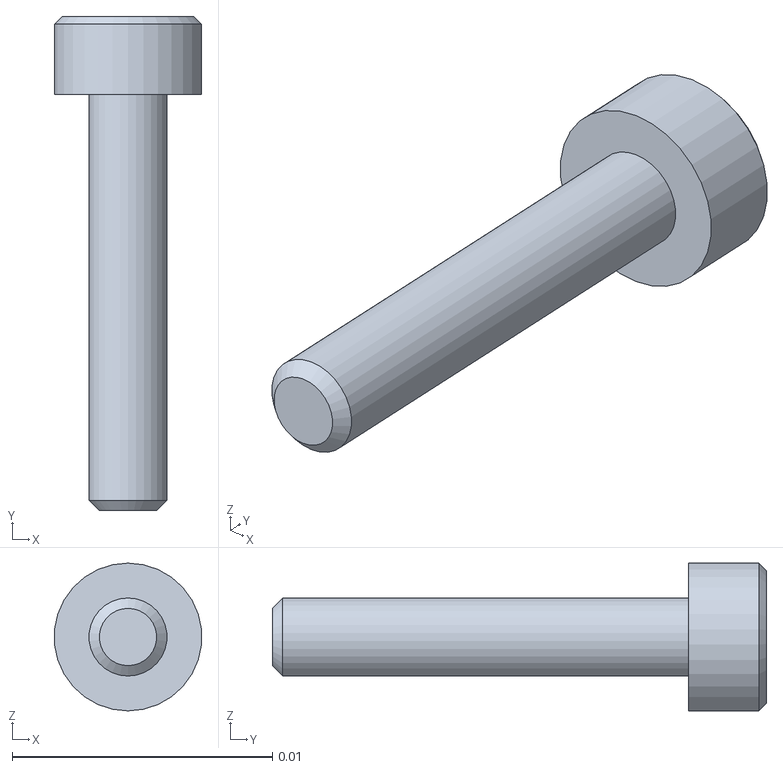
[picture p98: CAD file, 2026-10-22]
cad/mesh/F02_M3x16_SHCS.STL
0.00565 x 0.019 x 0.00568
