Dalcouffe1/Design-Build-Fly/cad/model/Landing_Leg.SLDPRT

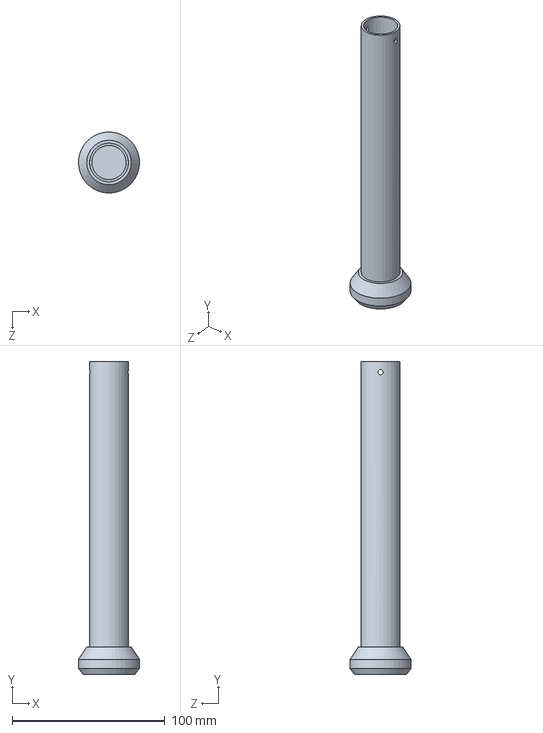
[picture p99: CAD file, 2026-10-25]
cad/model/Landing_Leg.SLDPRT
40.0 x 205.0 x 40.0 mm
