Dalcouffe1/Design-Build-Fly/cad/mesh/Boom_Rear_Stub.STL

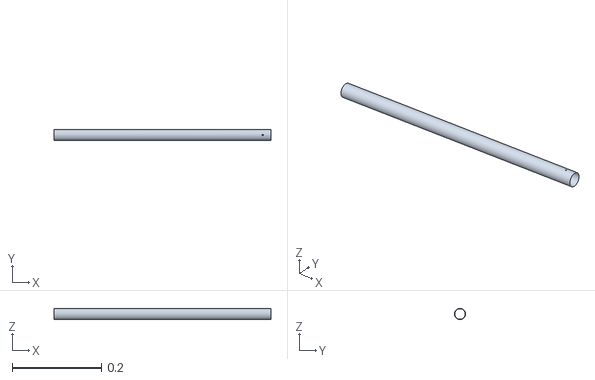
[picture p100: CAD file, 2026-10-22]
cad/mesh/Boom_Rear_Stub.STL
0.486 x 0.0253 x 0.0254
