Dalcouffe1/Design-Build-Fly/cad/mesh/N01_M3_Nylock.STL

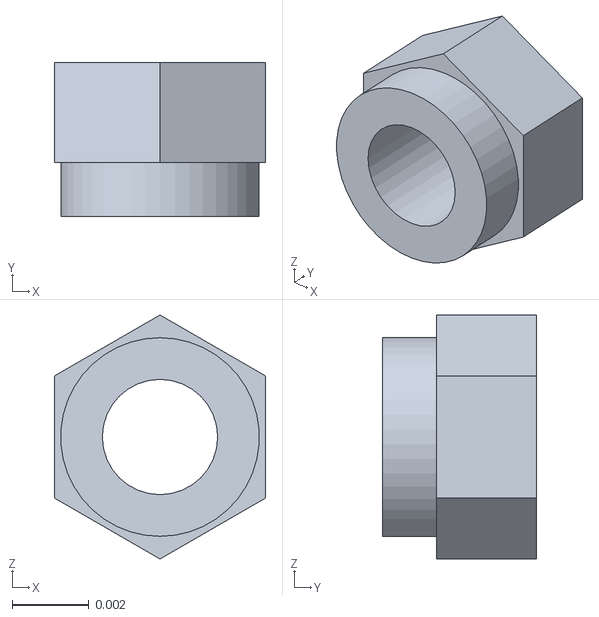
[picture p101: CAD file, 2026-10-22]
cad/mesh/N01_M3_Nylock.STL
0.0055 x 0.004 x 0.00635
