Dalcouffe1/Design-Build-Fly/cad/model/Control_Horn.SLDPRT

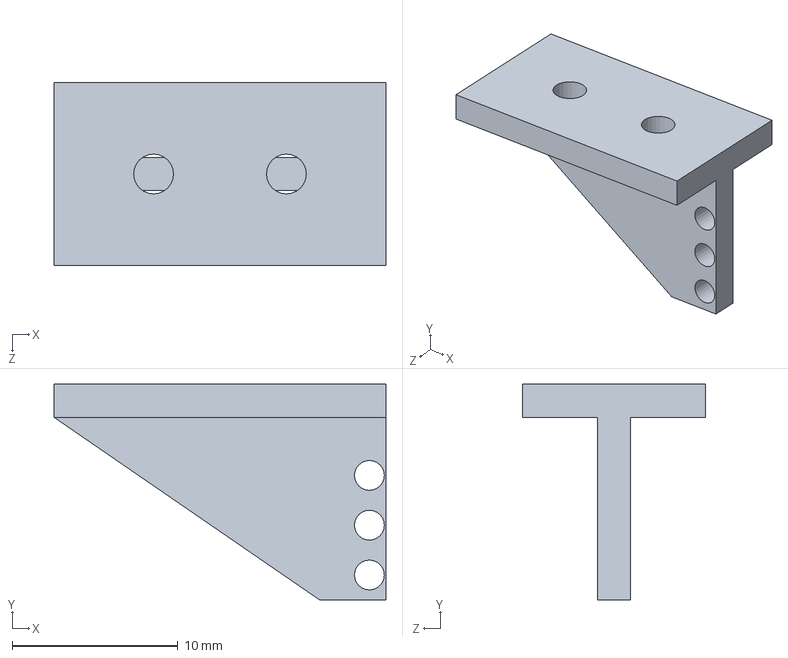
[picture p102: CAD file, 2026-10-25]
cad/model/Control_Horn.SLDPRT
20.0 x 13.0 x 11.0 mm
