Dalcouffe1/Design-Build-Fly/cad/mesh/Tail_Clamp_Cap.STL

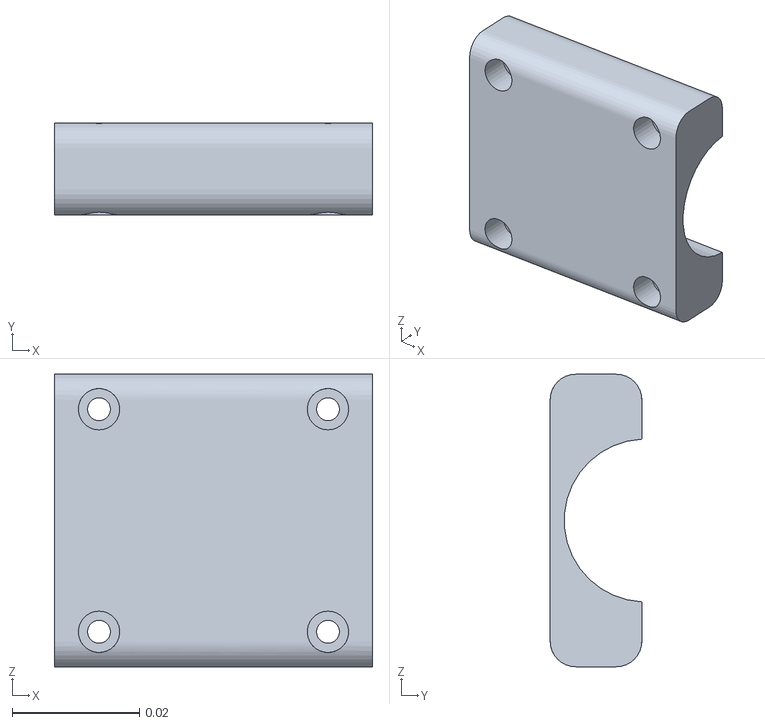
[picture p103: CAD file, 2026-10-22]
cad/mesh/Tail_Clamp_Cap.STL
0.05 x 0.0144 x 0.046
