Dalcouffe1/Design-Build-Fly/cad/model/Gear_Fairing.SLDPRT

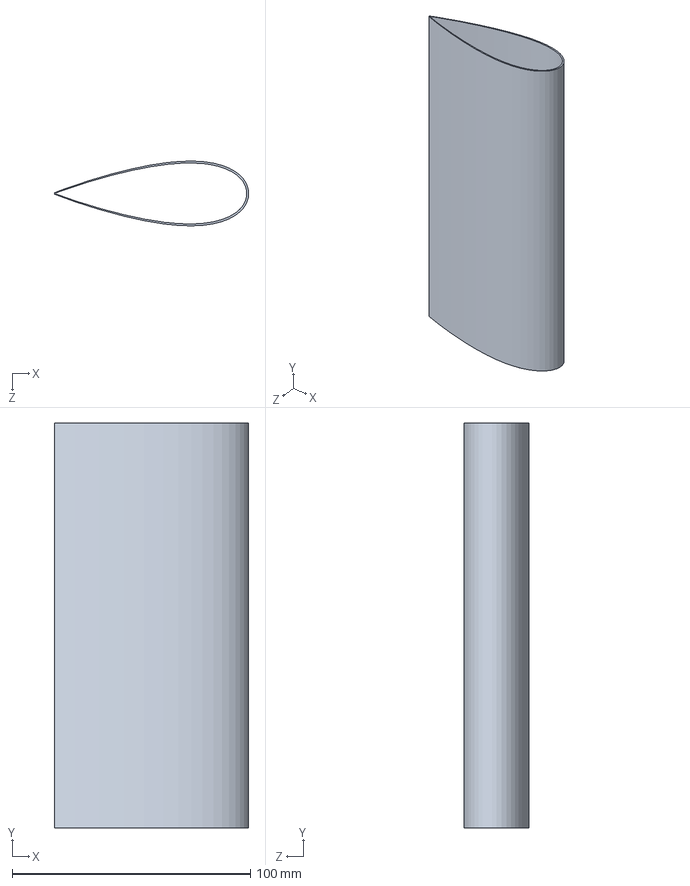
[picture p104: CAD file, 2026-10-25]
cad/model/Gear_Fairing.SLDPRT
81.6 x 170.0 x 27.2 mm
