Dalcouffe1/Design-Build-Fly/cad/model/F11_M2x14_PAN.SLDPRT

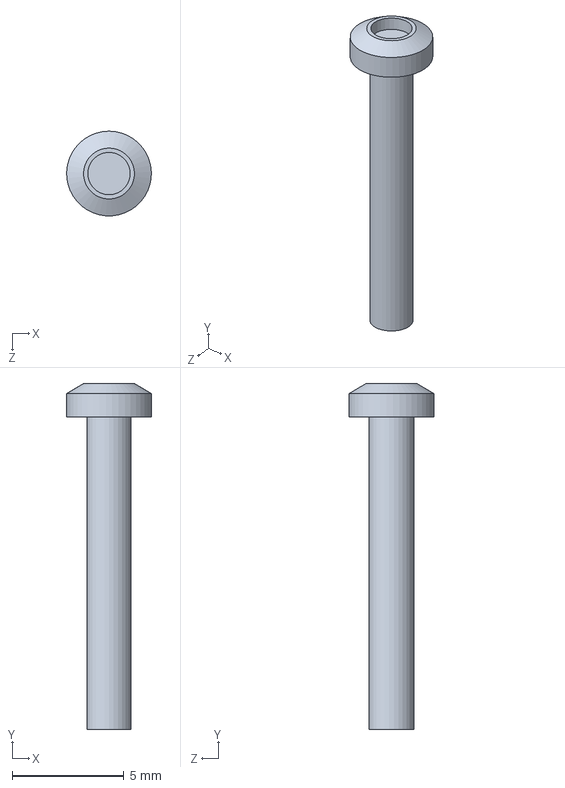
[picture p105: CAD file, 2026-10-25]
cad/model/F11_M2x14_PAN.SLDPRT
3.80 x 15.5 x 3.79 mm
