Dalcouffe1/Design-Build-Fly/cad/model/Flight_Controller.SLDPRT

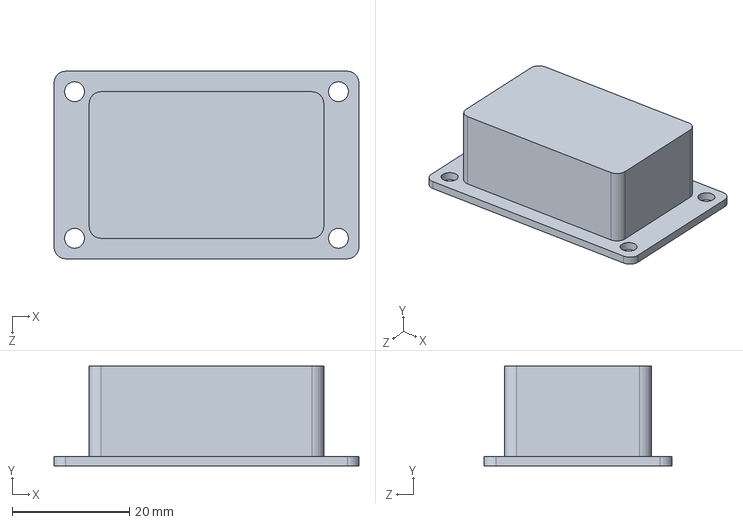
[picture p106: CAD file, 2026-10-25]
cad/model/Flight_Controller.SLDPRT
52.0 x 17.0 x 32.0 mm
