Dalcouffe1/Design-Build-Fly/cad/mesh/F06_M3x35_SHCS.STL

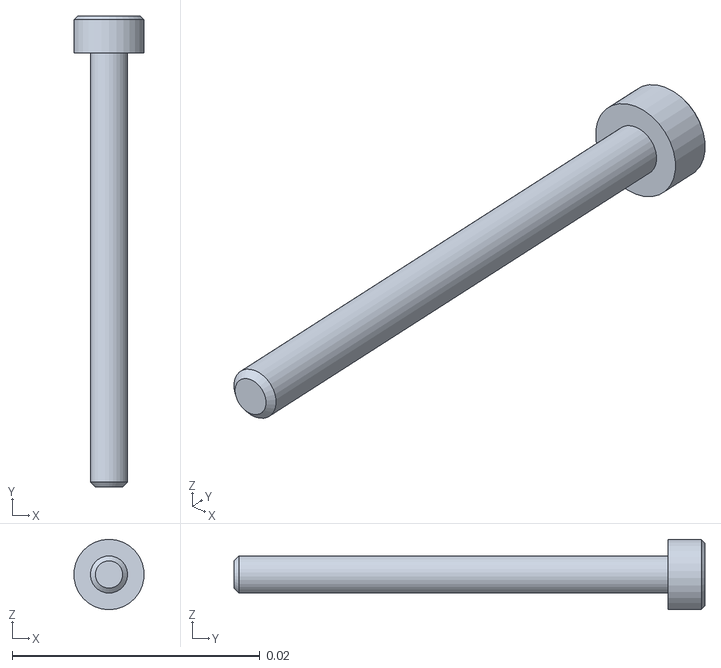
[picture p107: CAD file, 2026-10-22]
cad/mesh/F06_M3x35_SHCS.STL
0.00565 x 0.038 x 0.00568
