Dalcouffe1/Design-Build-Fly/cad/model/Pusher_Cup.SLDPRT

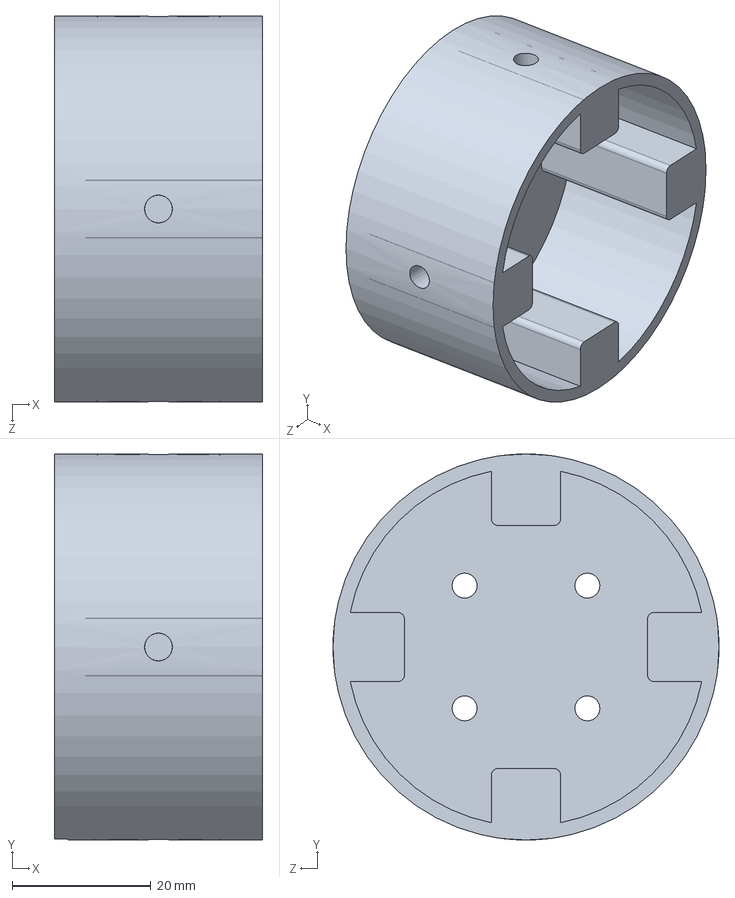
[picture p108: CAD file, 2026-10-25]
cad/model/Pusher_Cup.SLDPRT
30.0 x 55.6 x 55.6 mm
