Dalcouffe1/Design-Build-Fly/cad/mesh/Tail_Clamp_Upper.STL

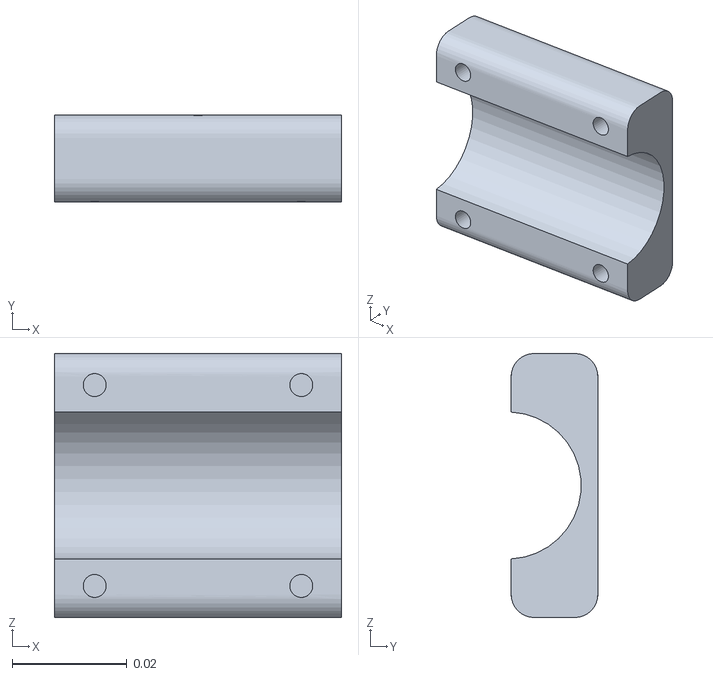
[picture p109: CAD file, 2026-10-22]
cad/mesh/Tail_Clamp_Upper.STL
0.05 x 0.0151 x 0.046
