Dalcouffe1/Design-Build-Fly/cad/mesh/Landing_Leg.STL

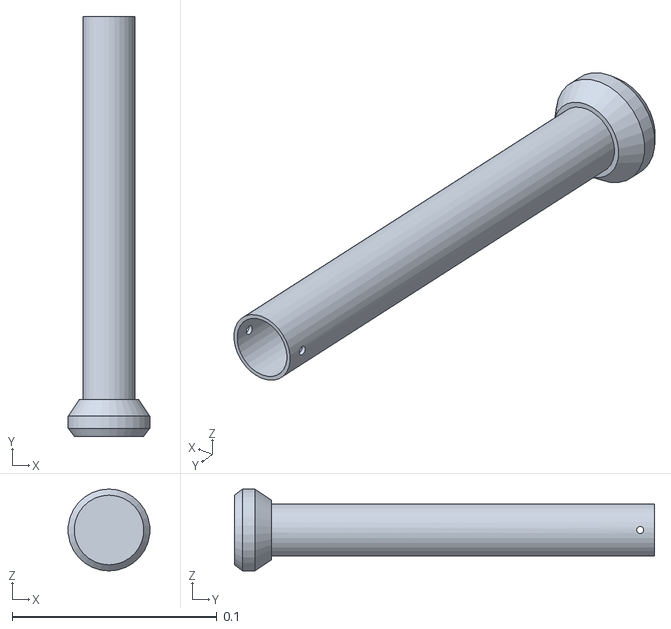
[picture p111: CAD file, 2026-10-22]
cad/mesh/Landing_Leg.STL
0.0398 x 0.205 x 0.04
