Dalcouffe1/Design-Build-Fly/cad/model/Pitot_Clamp.SLDPRT

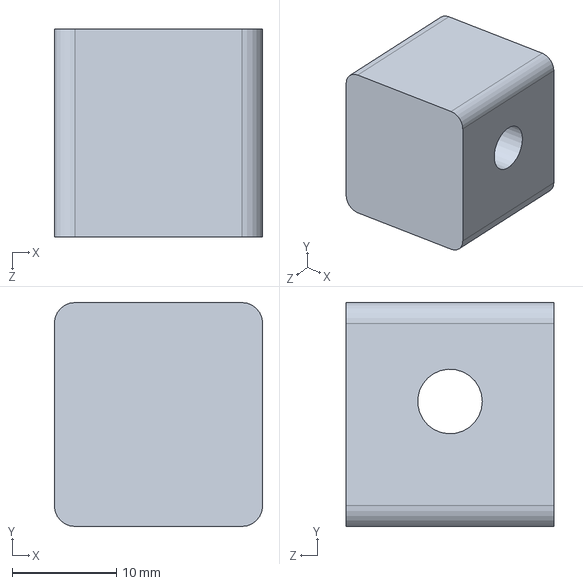
[picture p112: CAD file, 2026-10-25]
cad/model/Pitot_Clamp.SLDPRT
20.0 x 21.5 x 20.0 mm
