Dalcouffe1/Design-Build-Fly/cad/mesh/Lift_Prop.STL

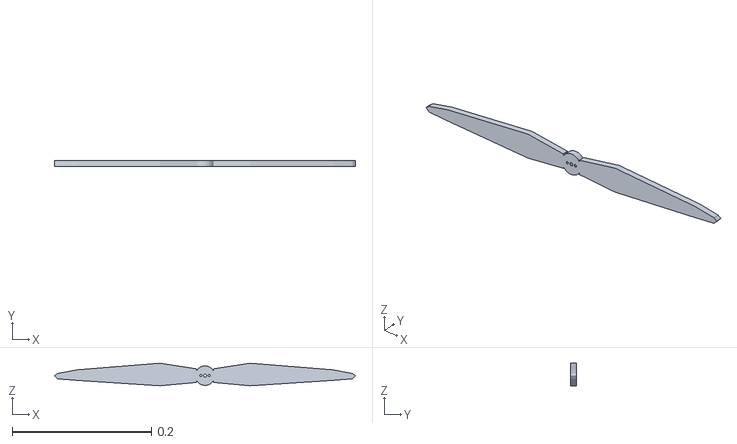
[picture p113: CAD file, 2026-10-22]
cad/mesh/Lift_Prop.STL
0.432 x 0.008 x 0.0324
