Dalcouffe1/Design-Build-Fly/cad/model/Pushrod_Elevator.SLDPRT

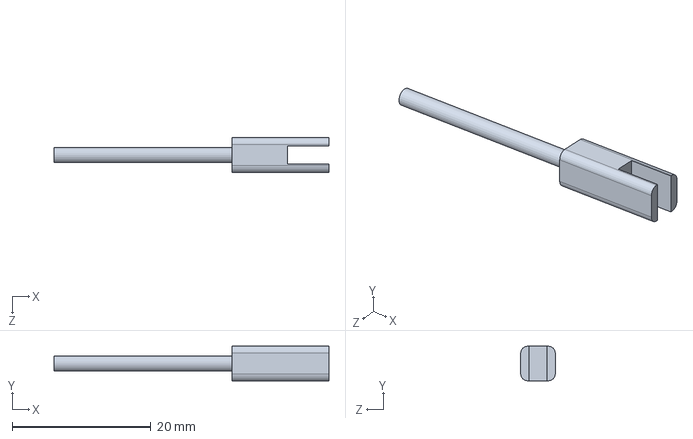
[picture p114: CAD file, 2026-10-25]
cad/model/Pushrod_Elevator.SLDPRT
39.6 x 5.00 x 5.00 mm
