Dalcouffe1/Design-Build-Fly/cad/mesh/Splice_Plug.STL

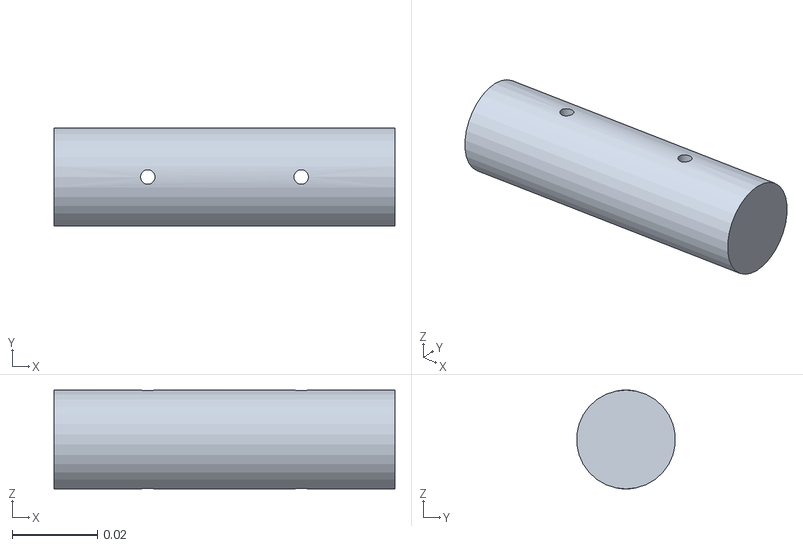
[picture p115: CAD file, 2026-10-22]
cad/mesh/Splice_Plug.STL
0.08 x 0.0231 x 0.0232
