Dalcouffe1/Design-Build-Fly/cad/model/F01_M3x8_SHCS.SLDPRT

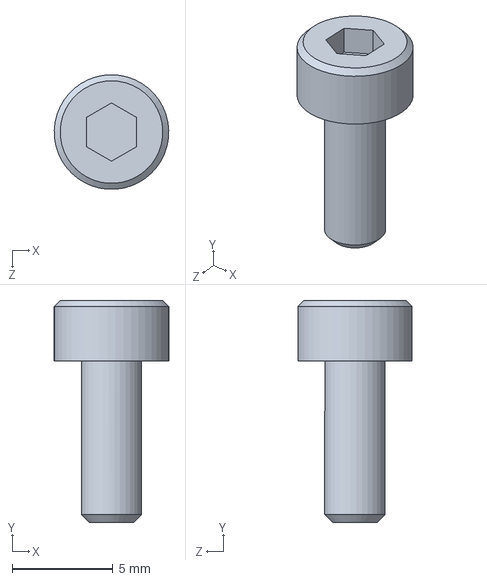
[picture p116: CAD file, 2026-10-25]
cad/model/F01_M3x8_SHCS.SLDPRT
5.68 x 11.0 x 5.67 mm
