Dalcouffe1/Design-Build-Fly/cad/mesh/Gear_Clamp_Lower.STL

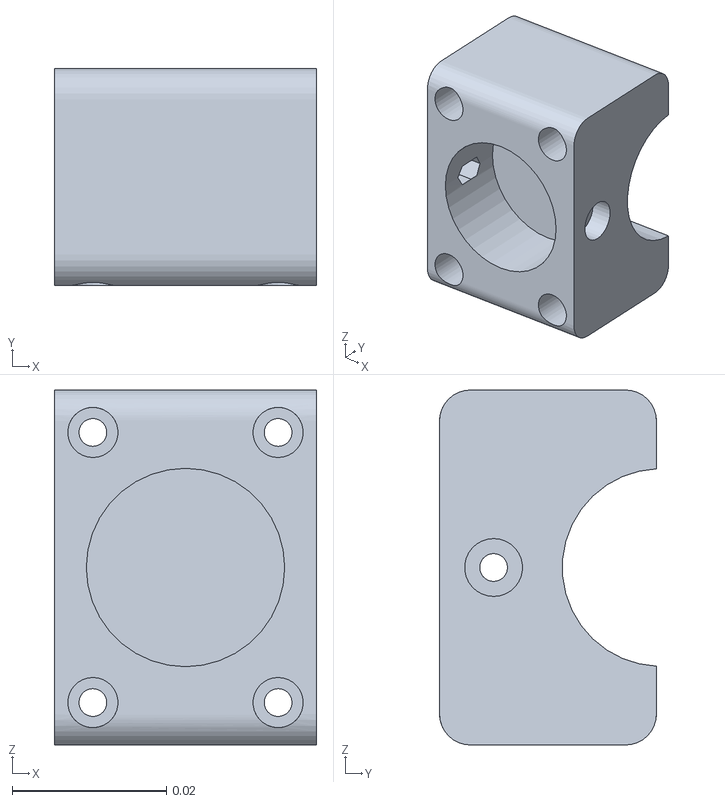
[picture p117: CAD file, 2026-10-22]
cad/mesh/Gear_Clamp_Lower.STL
0.034 x 0.0281 x 0.046
