Dalcouffe1/Design-Build-Fly/cad/model/Joiner_Stop.SLDPRT

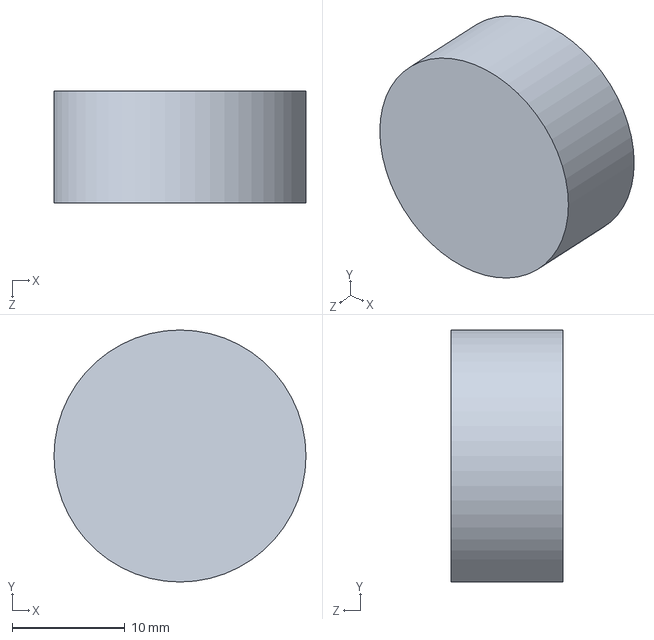
[picture p118: CAD file, 2026-10-25]
cad/model/Joiner_Stop.SLDPRT
22.4 x 22.4 x 10.0 mm
