Dalcouffe1/Design-Build-Fly/cad/mesh/FC_Tray.STL

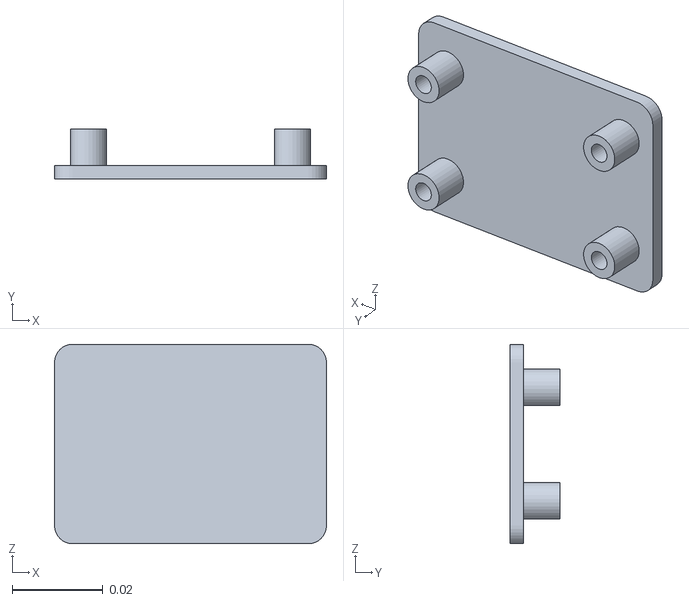
[picture p119: CAD file, 2026-10-22]
cad/mesh/FC_Tray.STL
0.06 x 0.011 x 0.044
