Dalcouffe1/Design-Build-Fly/cad/model/Pusher_Adapter.SLDPRT

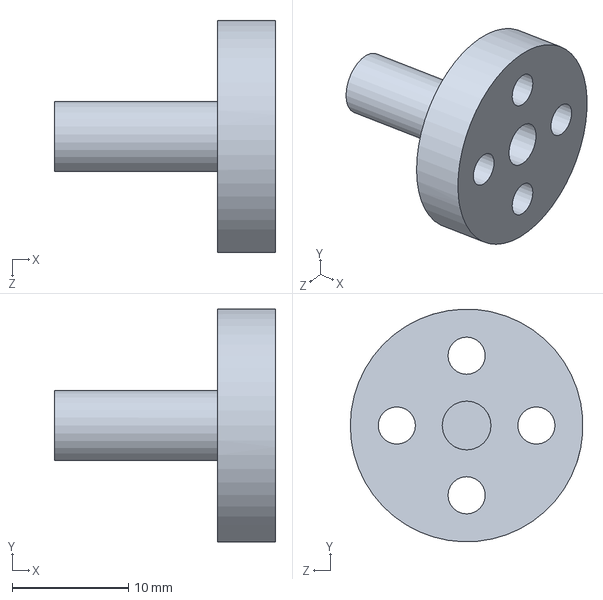
[picture p120: CAD file, 2026-10-25]
cad/model/Pusher_Adapter.SLDPRT
19.0 x 20.0 x 20.0 mm
