Dalcouffe1/Design-Build-Fly/cad/mesh/I01_M3_Insert.STL

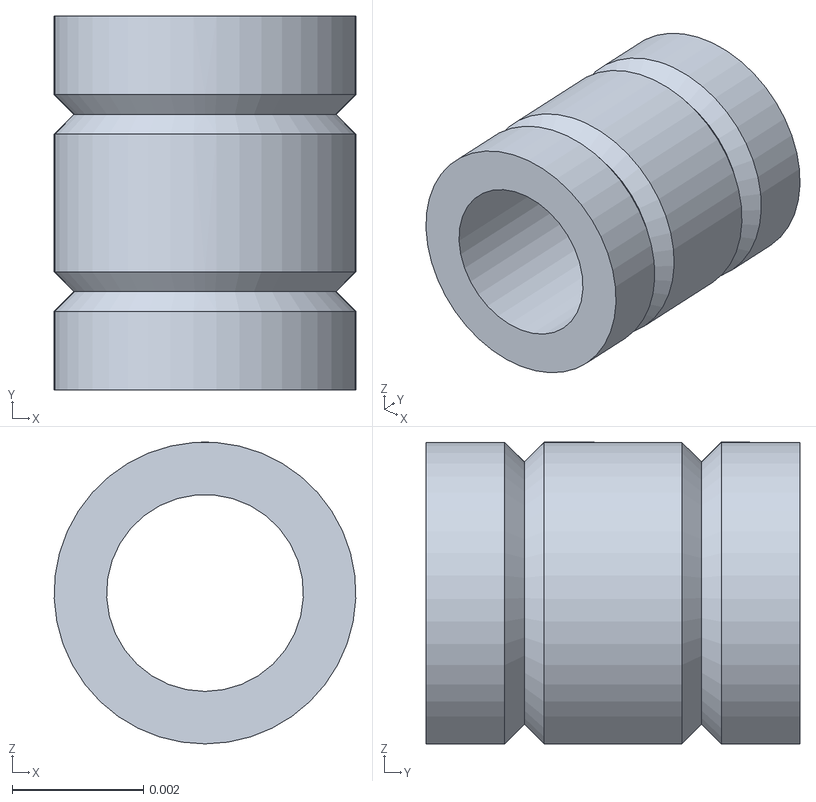
[picture p121: CAD file, 2026-10-22]
cad/mesh/I01_M3_Insert.STL
0.0046 x 0.0057 x 0.0046
