Dalcouffe1/Design-Build-Fly/cad/mesh/Horn_Hardpoint.STL

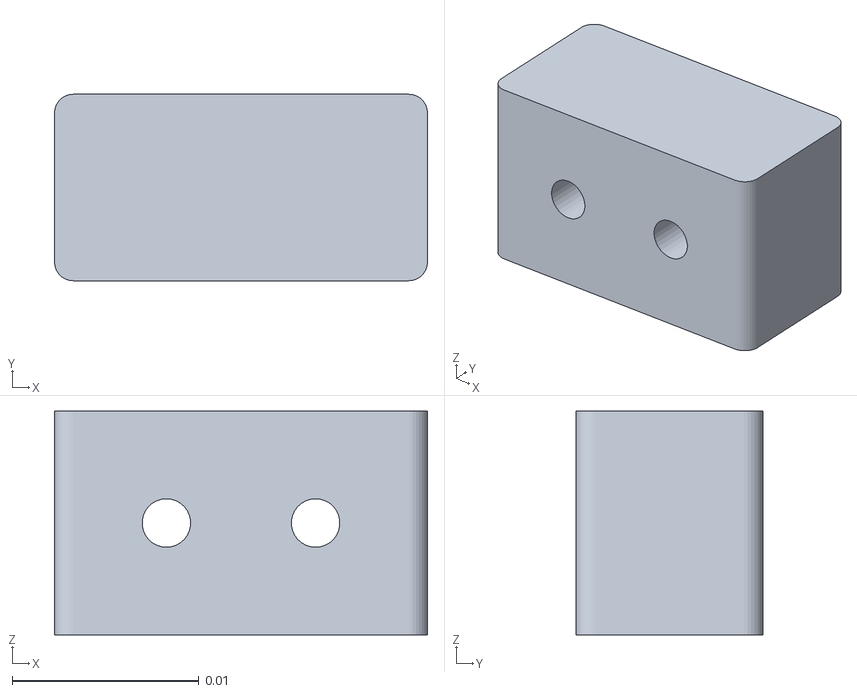
[picture p123: CAD file, 2026-10-22]
cad/mesh/Horn_Hardpoint.STL
0.02 x 0.01 x 0.012
