Dalcouffe1/Design-Build-Fly/cad/model/F06_M3x35_SHCS.SLDPRT

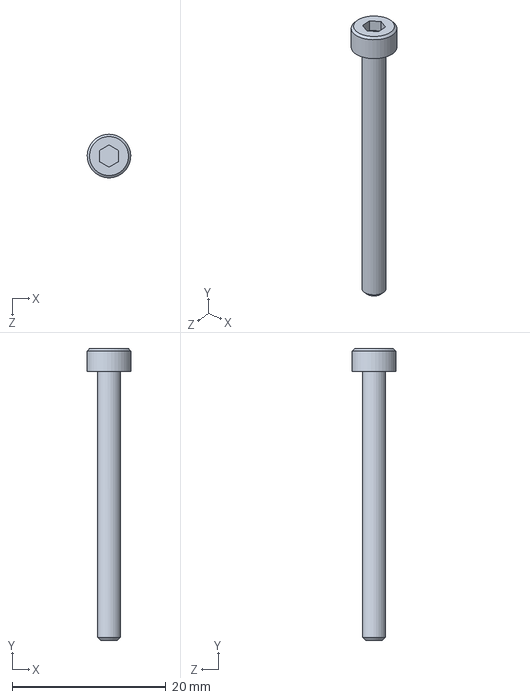
[picture p124: CAD file, 2026-10-25]
cad/model/F06_M3x35_SHCS.SLDPRT
5.67 x 38.0 x 5.67 mm
