Dalcouffe1/Design-Build-Fly/cad/mesh/Pitot_Clamp.STL

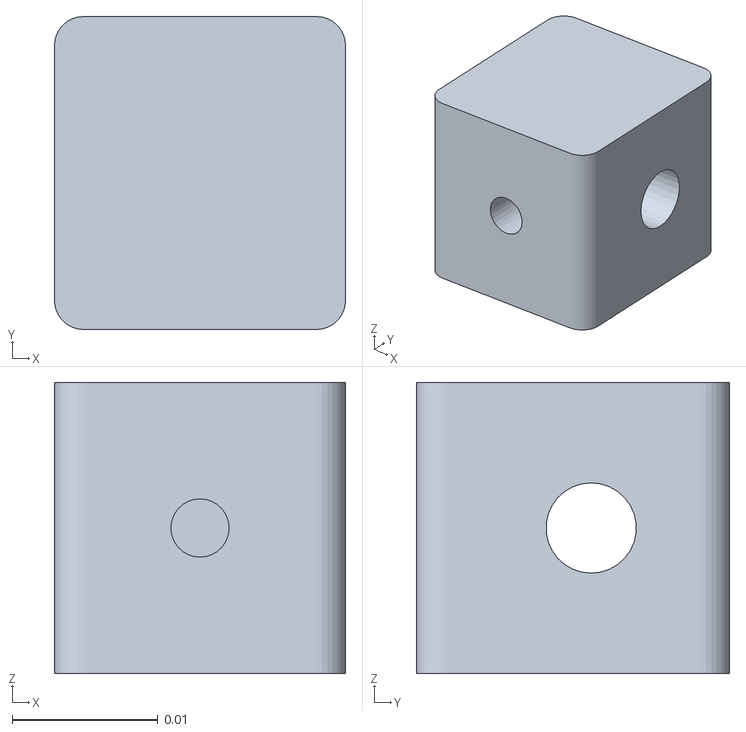
[picture p125: CAD file, 2026-10-22]
cad/mesh/Pitot_Clamp.STL
0.02 x 0.0215 x 0.02
