Dalcouffe1/Design-Build-Fly/cad/model/Pitot_Tube.SLDPRT

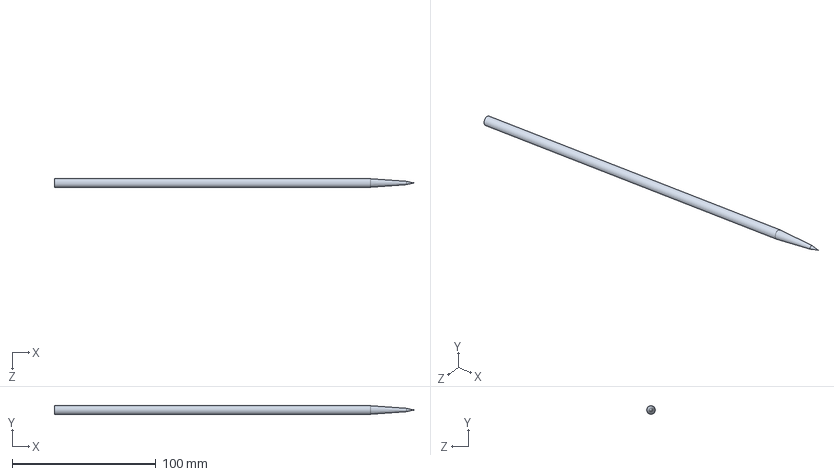
[picture p126: CAD file, 2026-10-25]
cad/model/Pitot_Tube.SLDPRT
250.0 x 5.99 x 5.98 mm
