Dalcouffe1/Design-Build-Fly/cad/mesh/F04_M3x40_SHCS.STL

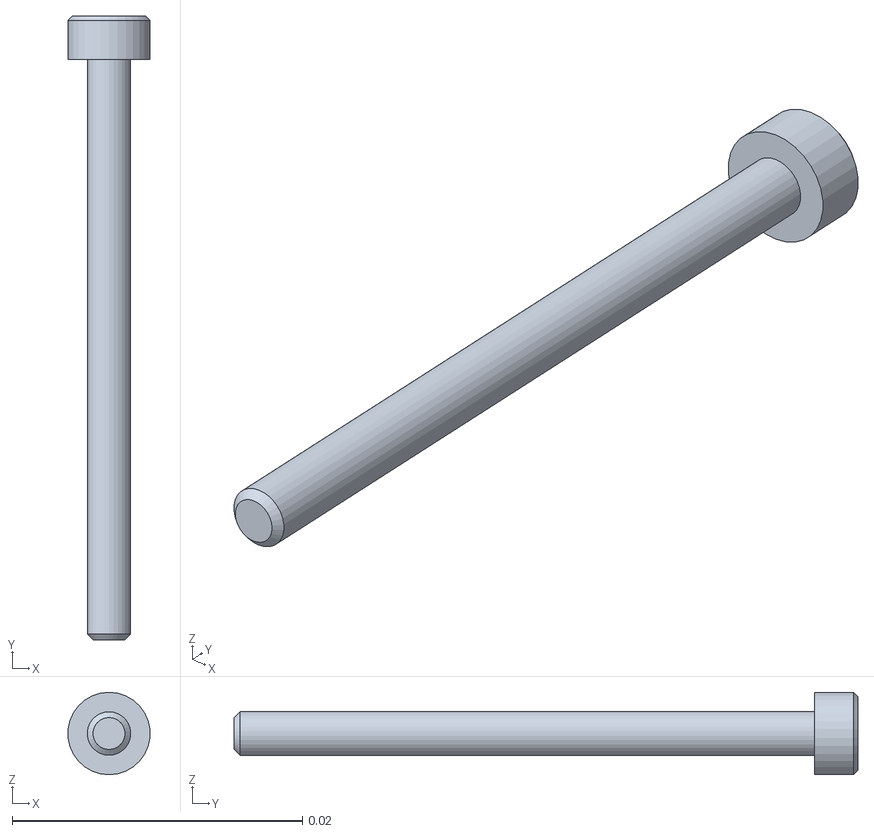
[picture p127: CAD file, 2026-10-22]
cad/mesh/F04_M3x40_SHCS.STL
0.00565 x 0.043 x 0.00568
