Dalcouffe1/Design-Build-Fly/cad/model/F04_M3x40_SHCS.SLDPRT

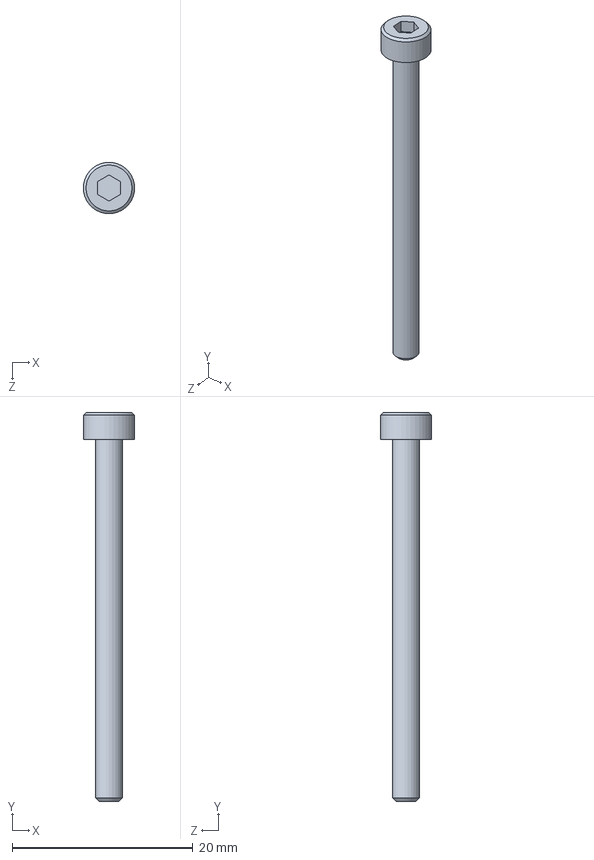
[picture p128: CAD file, 2026-10-25]
cad/model/F04_M3x40_SHCS.SLDPRT
5.68 x 43.0 x 5.68 mm
