Dalcouffe1/Design-Build-Fly/cad/mesh/F09_M5x20_BHCS.STL

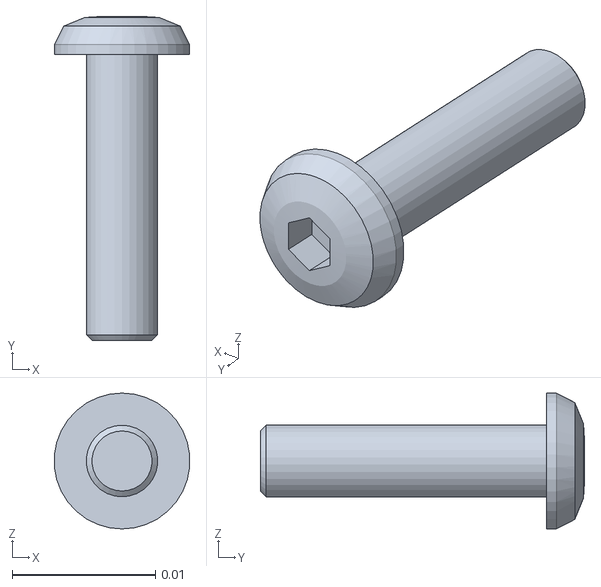
[picture p129: CAD file, 2026-10-22]
cad/mesh/F09_M5x20_BHCS.STL
0.00946 x 0.0227 x 0.0095
