Dalcouffe1/Design-Build-Fly/cad/mesh/Servo_Tray.STL

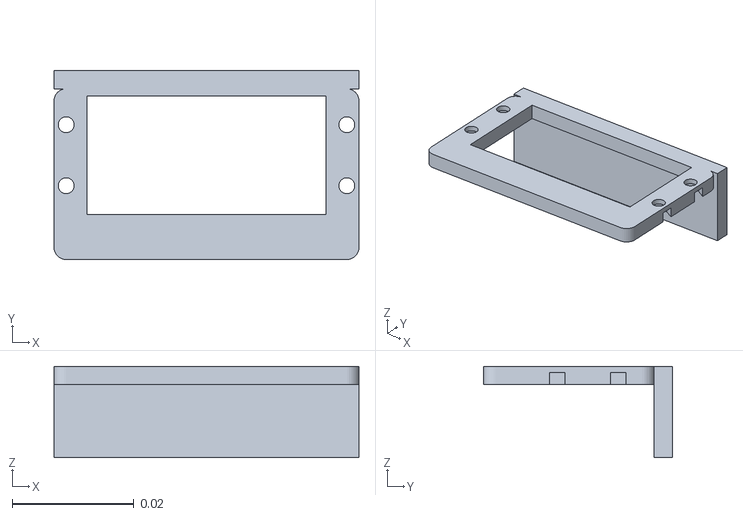
[picture p130: CAD file, 2026-10-22]
cad/mesh/Servo_Tray.STL
0.05 x 0.031 x 0.015
