Dalcouffe1/Design-Build-Fly/cad/model/F03_M3x20_SHCS.SLDPRT

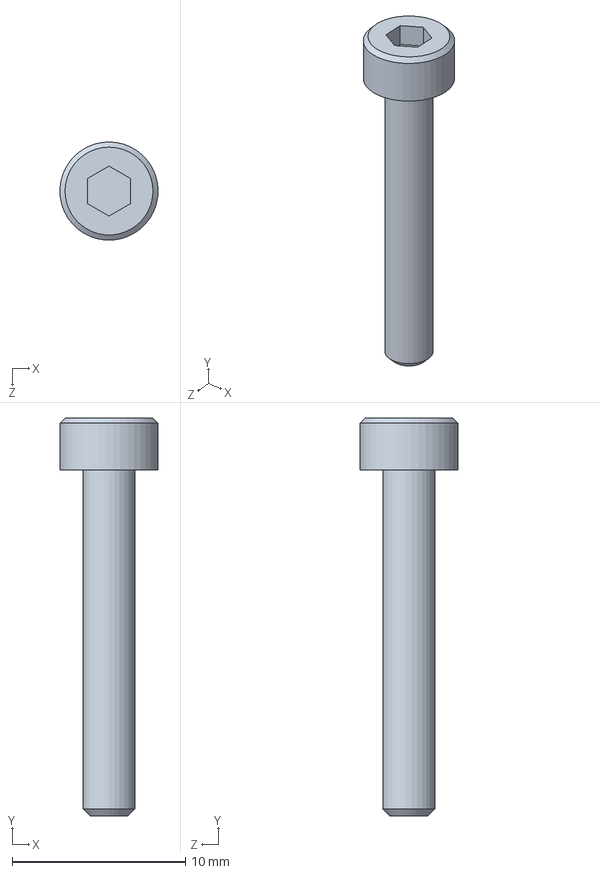
[picture p131: CAD file, 2026-10-25]
cad/model/F03_M3x20_SHCS.SLDPRT
5.68 x 23.0 x 5.67 mm
