Dalcouffe1/Design-Build-Fly/cad/mesh/Rear_Hardpoint.STL

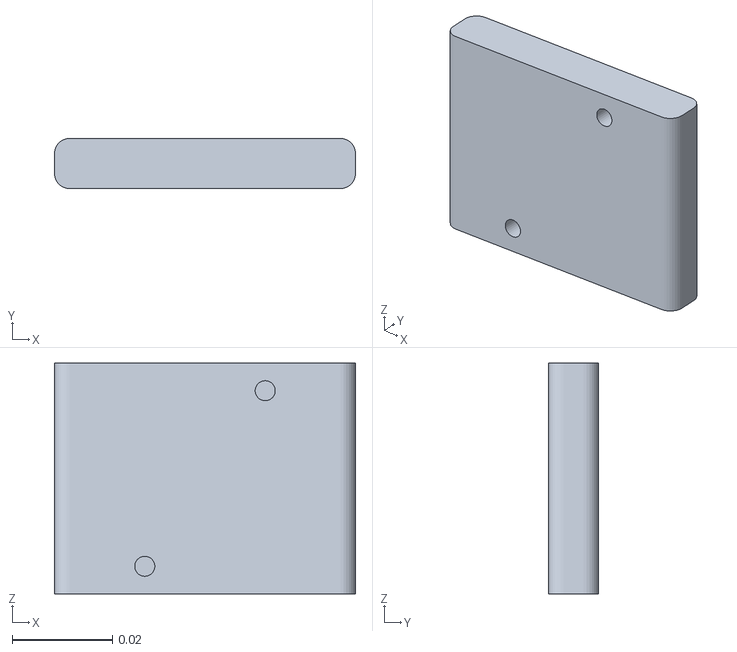
[picture p132: CAD file, 2026-10-22]
cad/mesh/Rear_Hardpoint.STL
0.06 x 0.01 x 0.046
