Dalcouffe1/Design-Build-Fly/cad/model/Fin.SLDPRT

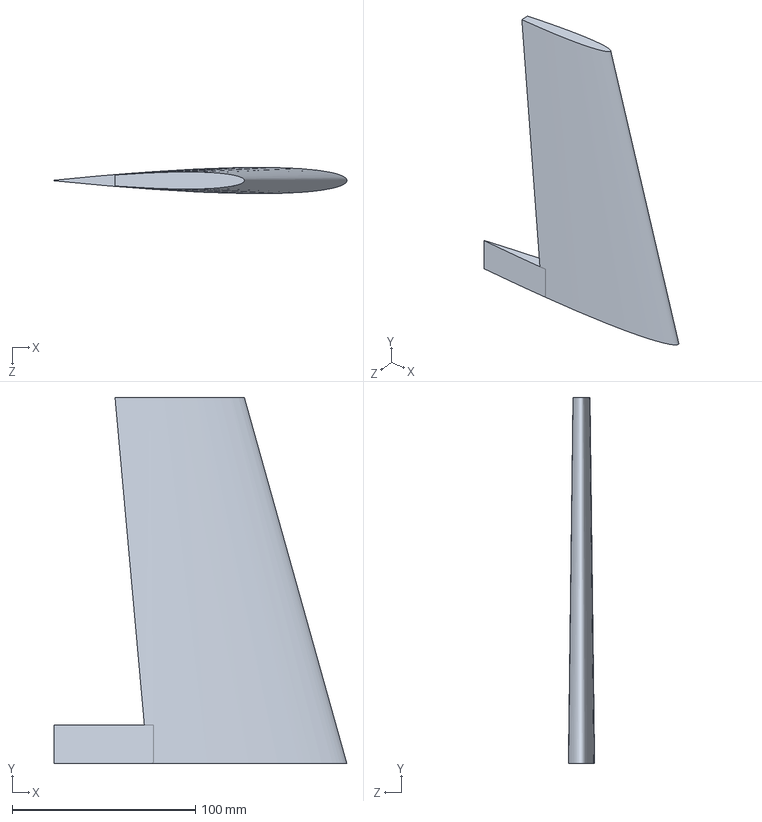
[picture p133: CAD file, 2026-10-25]
cad/model/Fin.SLDPRT
159.7 x 199.6 x 14.3 mm
