Dalcouffe1/Design-Build-Fly/cad/mesh/Motor_Mount_Upper.STL

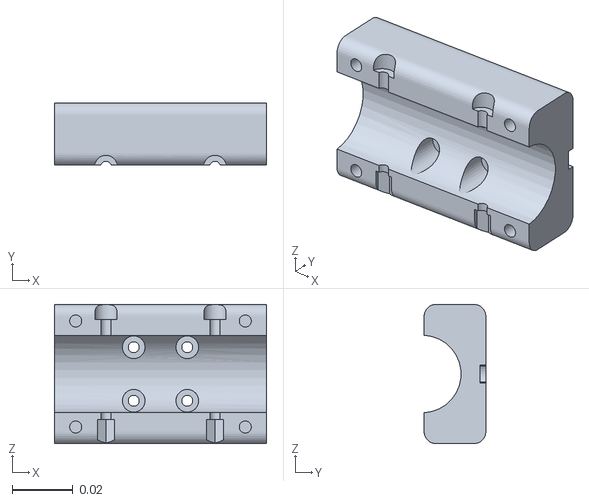
[picture p134: CAD file, 2026-10-22]
cad/mesh/Motor_Mount_Upper.STL
0.07 x 0.0204 x 0.046
