Dalcouffe1/Design-Build-Fly/cad/model/F10_M2x10_SHCS.SLDPRT

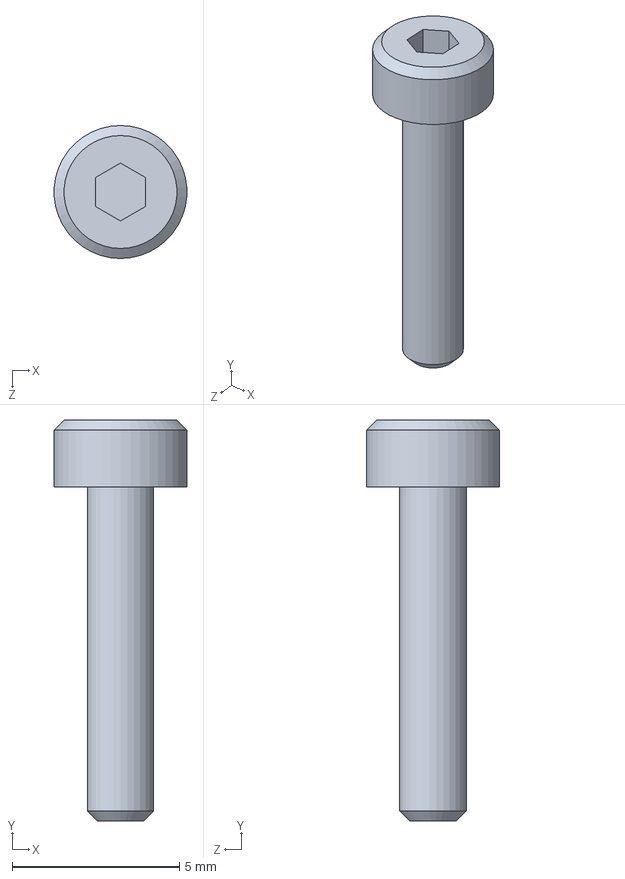
[picture p135: CAD file, 2026-10-25]
cad/model/F10_M2x10_SHCS.SLDPRT
3.97 x 12.0 x 3.98 mm
