Dalcouffe1/Design-Build-Fly/cad/mesh/Gear_Clamp_Upper.STL

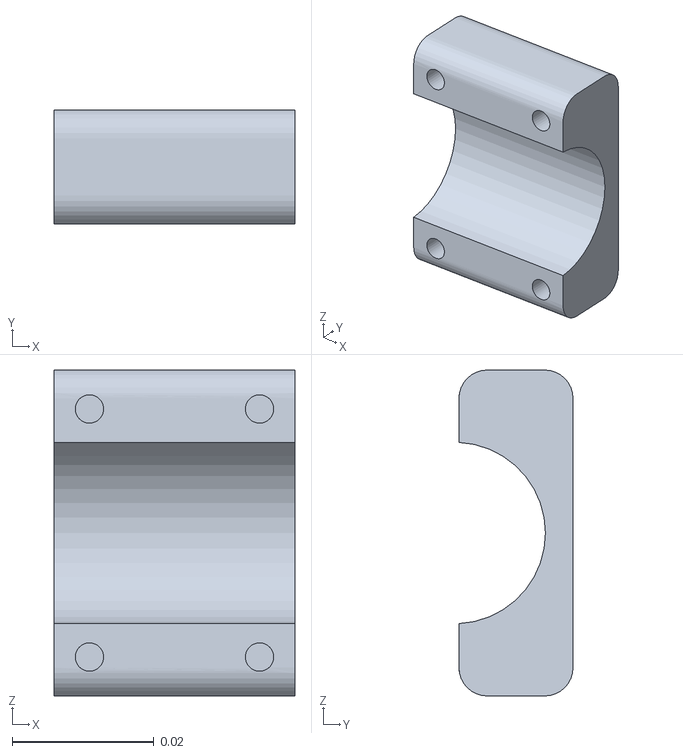
[picture p136: CAD file, 2026-10-22]
cad/mesh/Gear_Clamp_Upper.STL
0.034 x 0.0161 x 0.046
