Dalcouffe1/Design-Build-Fly/cad/model/F07_M3x8_BHCS.SLDPRT

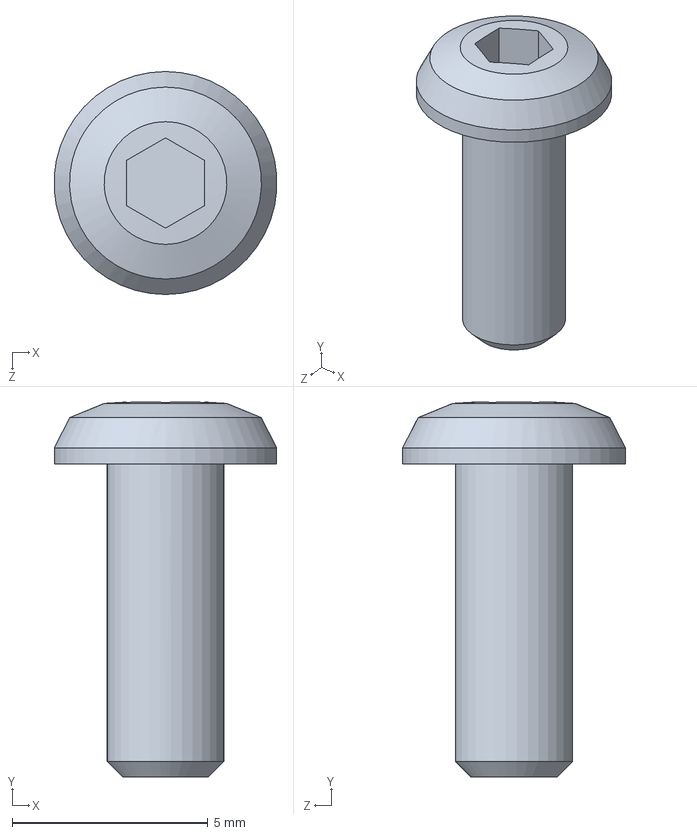
[picture p137: CAD file, 2026-10-25]
cad/model/F07_M3x8_BHCS.SLDPRT
5.69 x 9.59 x 5.70 mm
