Dalcouffe1/Design-Build-Fly/cad/mesh/F01_M3x8_SHCS.STL

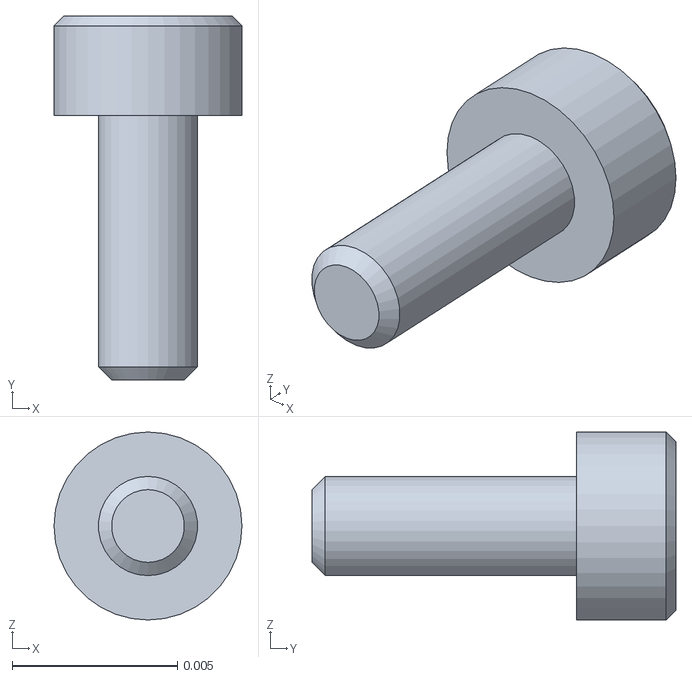
[picture p138: CAD file, 2026-10-22]
cad/mesh/F01_M3x8_SHCS.STL
0.00568 x 0.011 x 0.00568
