Dalcouffe1/Design-Build-Fly/cad/model/Boom_Clamp_F_Upper.SLDPRT

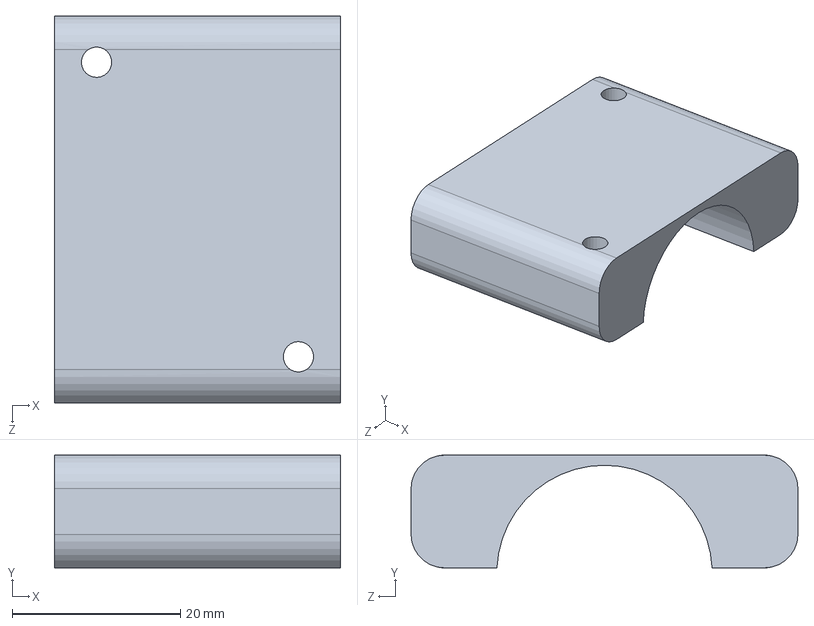
[picture p139: CAD file, 2026-10-25]
cad/model/Boom_Clamp_F_Upper.SLDPRT
34.0 x 13.4 x 46.0 mm
