Dalcouffe1/Design-Build-Fly/cad/mesh/F11_M2x14_PAN.STL

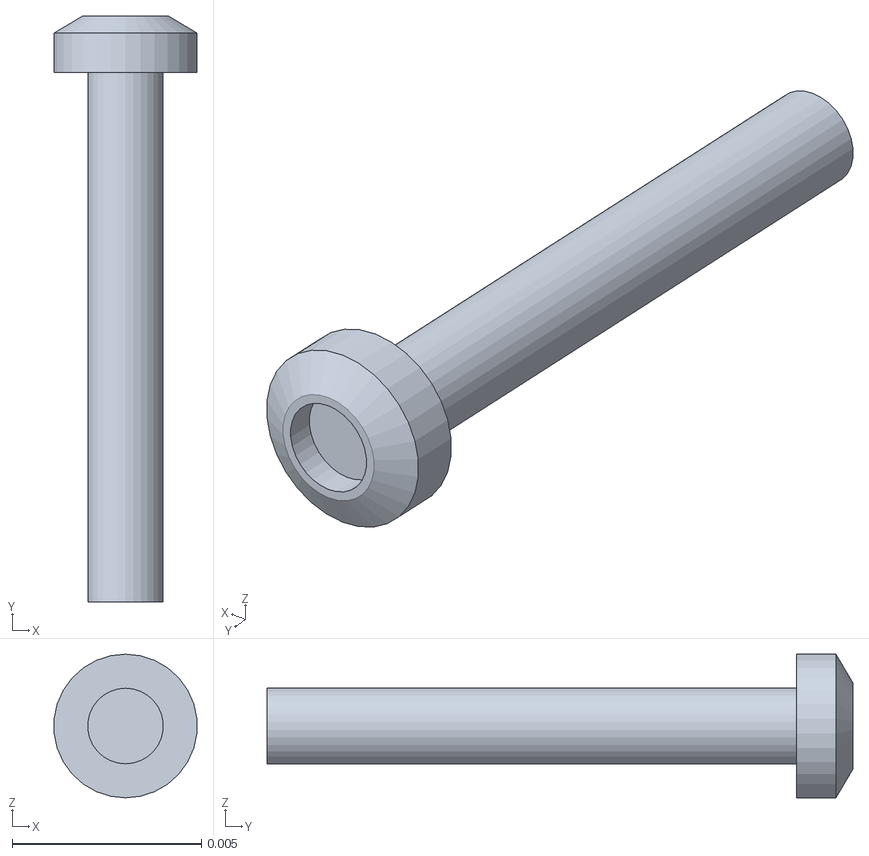
[picture p140: CAD file, 2026-10-22]
cad/mesh/F11_M2x14_PAN.STL
0.00378 x 0.0155 x 0.0038
