Dalcouffe1/Design-Build-Fly/cad/model/Canopy.SLDPRT

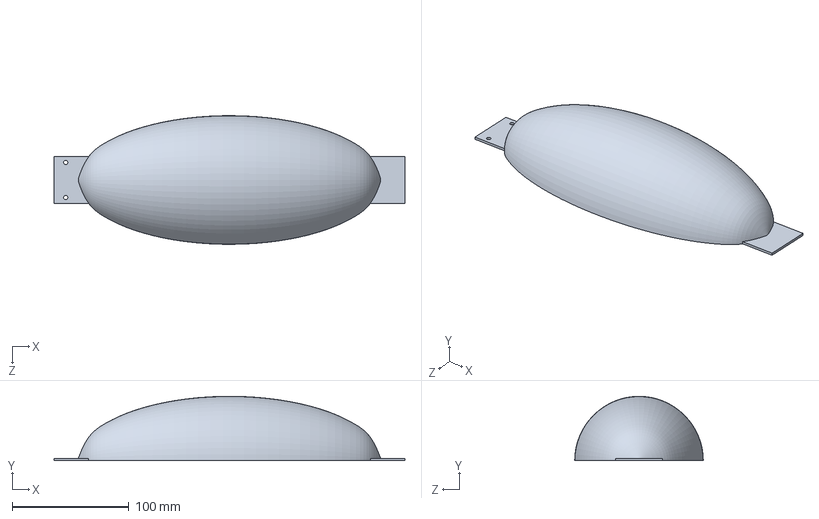
[picture p141: CAD file, 2026-10-25]
cad/model/Canopy.SLDPRT
300.0 x 55.0 x 110.0 mm
