Dalcouffe1/Design-Build-Fly/cad/mesh/Prop_Plate.STL

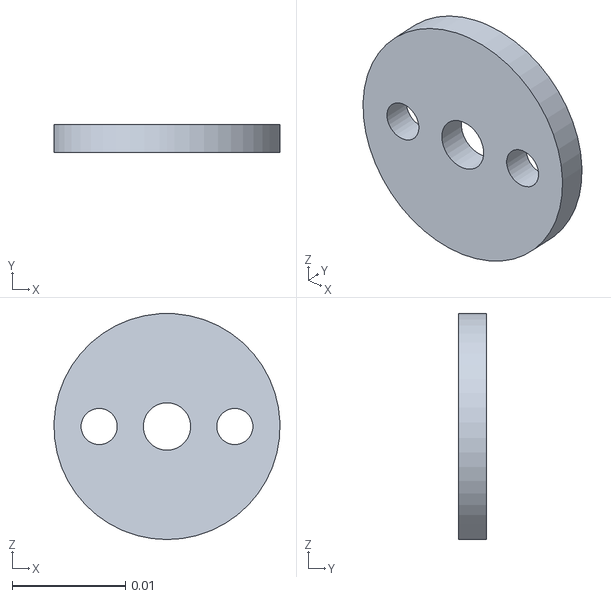
[picture p142: CAD file, 2026-10-22]
cad/mesh/Prop_Plate.STL
0.02 x 0.0025 x 0.02
