Dalcouffe1/Design-Build-Fly/cad/model/Pusher_Prop_14in.SLDPRT

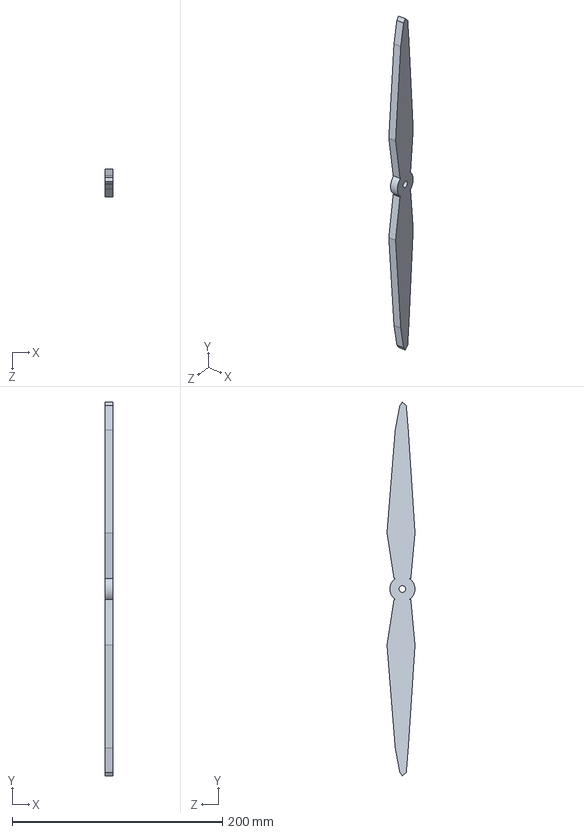
[picture p143: CAD file, 2026-10-25]
cad/model/Pusher_Prop_14in.SLDPRT
8.00 x 355.6 x 26.7 mm
