Dalcouffe1/Design-Build-Fly/cad/mesh/Horn_Backplate.STL

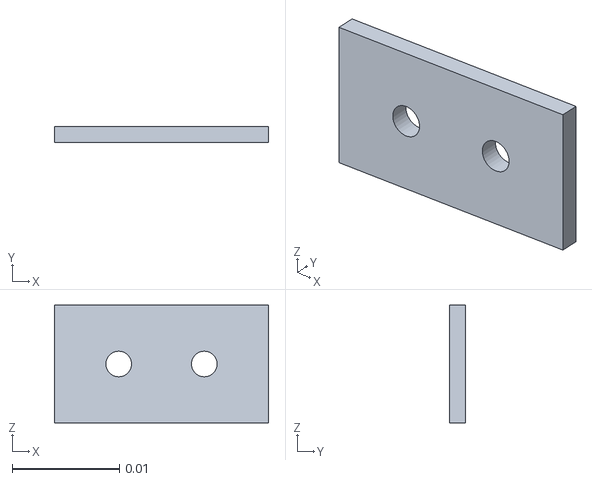
[picture p144: CAD file, 2026-10-22]
cad/mesh/Horn_Backplate.STL
0.02 x 0.0015 x 0.011
