Dalcouffe1/Design-Build-Fly/cad/model/Elevator.SLDPRT

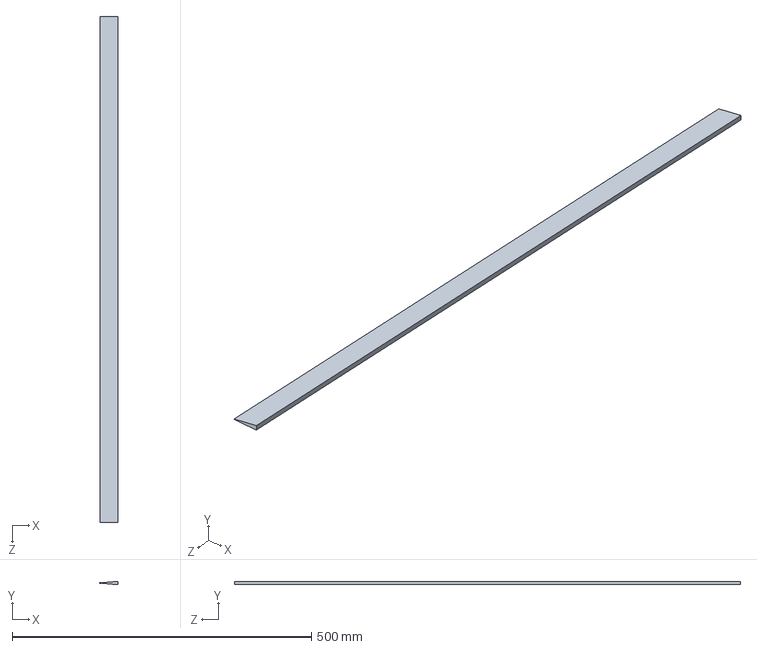
[picture p145: CAD file, 2026-10-25]
cad/model/Elevator.SLDPRT
30.5 x 5.58 x 845.8 mm
