Dalcouffe1/Design-Build-Fly/cad/model/Boom_Front.SLDPRT

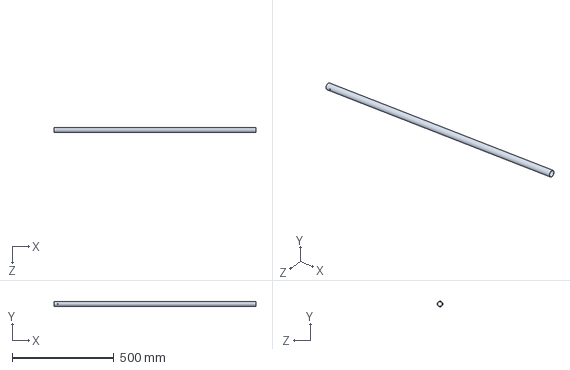
[picture p146: CAD file, 2026-10-25]
cad/model/Boom_Front.SLDPRT
991.0 x 25.3 x 25.4 mm
