Dalcouffe1/Design-Build-Fly/cad/mesh/F08_M3x12_SHCS.STL

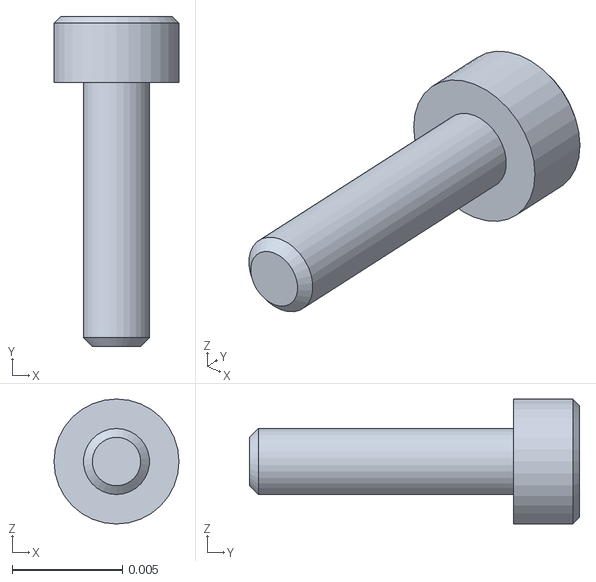
[picture p147: CAD file, 2026-10-22]
cad/mesh/F08_M3x12_SHCS.STL
0.00568 x 0.015 x 0.00568
