Dalcouffe1/Design-Build-Fly/cad/model/Fuselage_Pod.SLDPRT

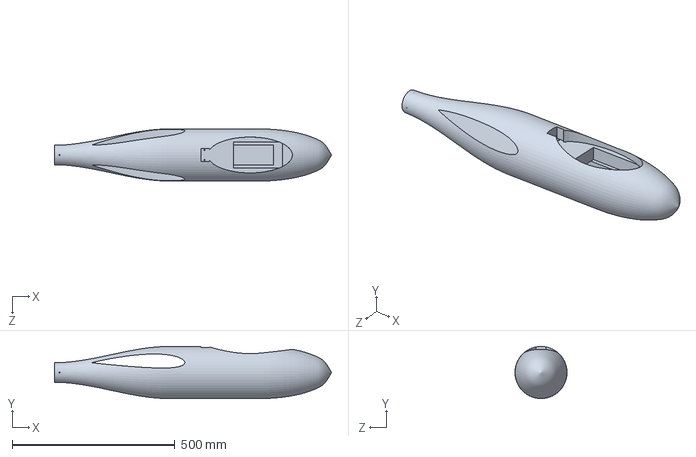
[picture p148: CAD file, 2026-10-25]
cad/model/Fuselage_Pod.SLDPRT
850.0 x 160.0 x 160.0 mm
