Dalcouffe1/Design-Build-Fly/cad/mesh/Control_Horn.STL

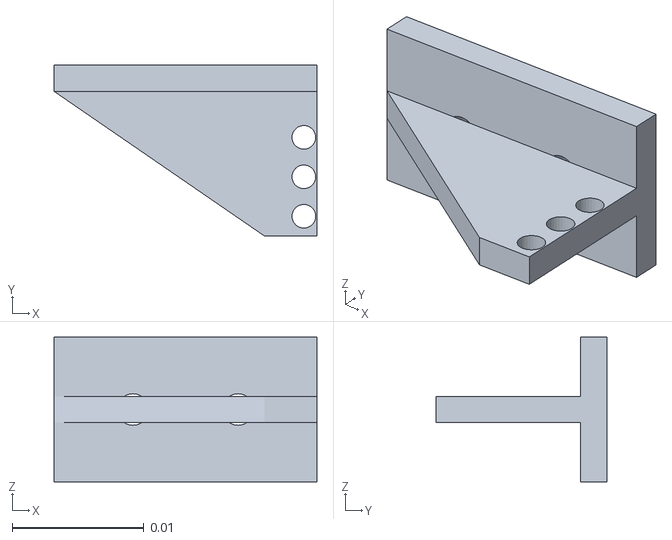
[picture p149: CAD file, 2026-10-22]
cad/mesh/Control_Horn.STL
0.02 x 0.013 x 0.011
