Dalcouffe1/Design-Build-Fly/cad/model/Prop_Plate.SLDPRT

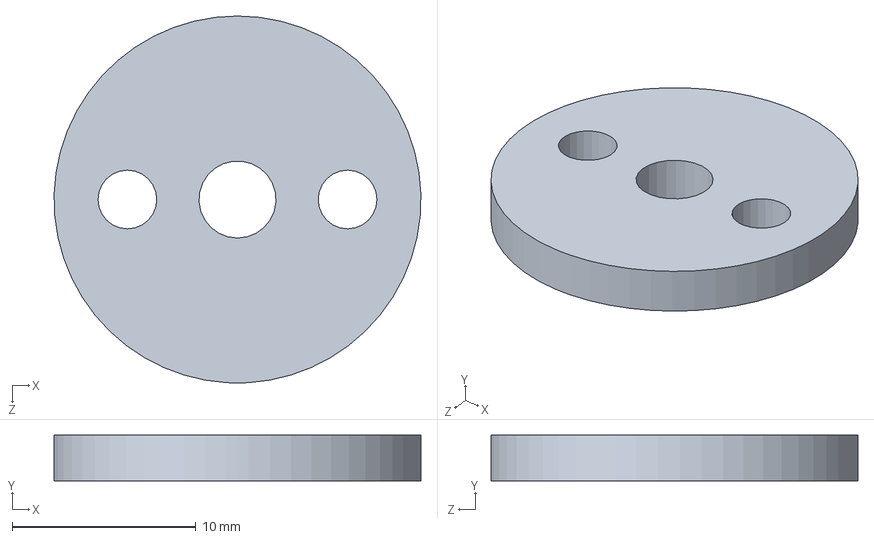
[picture p150: CAD file, 2026-10-25]
cad/model/Prop_Plate.SLDPRT
20.0 x 2.50 x 20.0 mm
