Dalcouffe1/Design-Build-Fly/cad/mesh/F05_M3x30_SHCS.STL

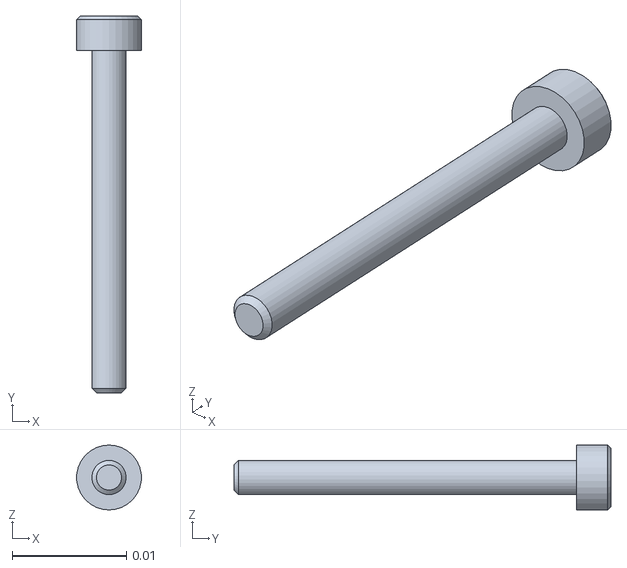
[picture p151: CAD file, 2026-10-22]
cad/mesh/F05_M3x30_SHCS.STL
0.00565 x 0.033 x 0.00568
