Dalcouffe1/Design-Build-Fly/cad/mesh/Root_Tongue.STL

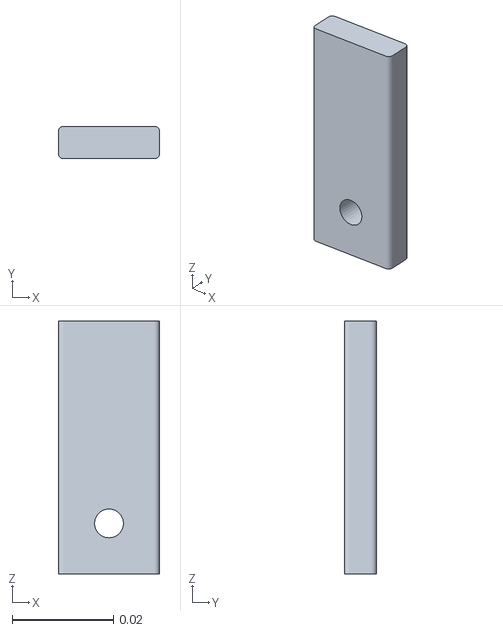
[picture p152: CAD file, 2026-10-22]
cad/mesh/Root_Tongue.STL
0.02 x 0.0064 x 0.05
