Dalcouffe1/Design-Build-Fly/cad/model/Spar_Tube.SLDPRT

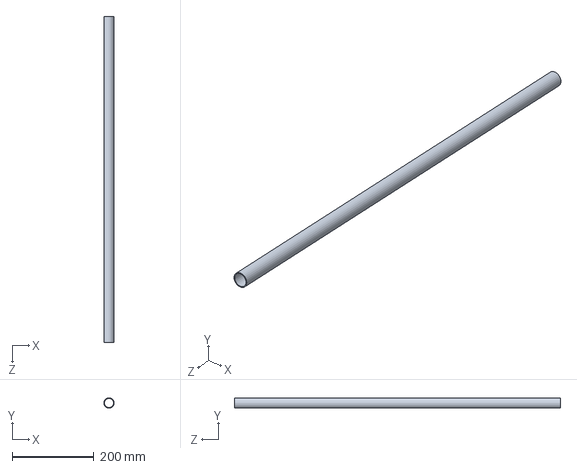
[picture p153: CAD file, 2026-10-25]
cad/model/Spar_Tube.SLDPRT
25.4 x 25.4 x 800.0 mm
