Dalcouffe1/Design-Build-Fly/cad/mesh/F03_M3x20_SHCS.STL

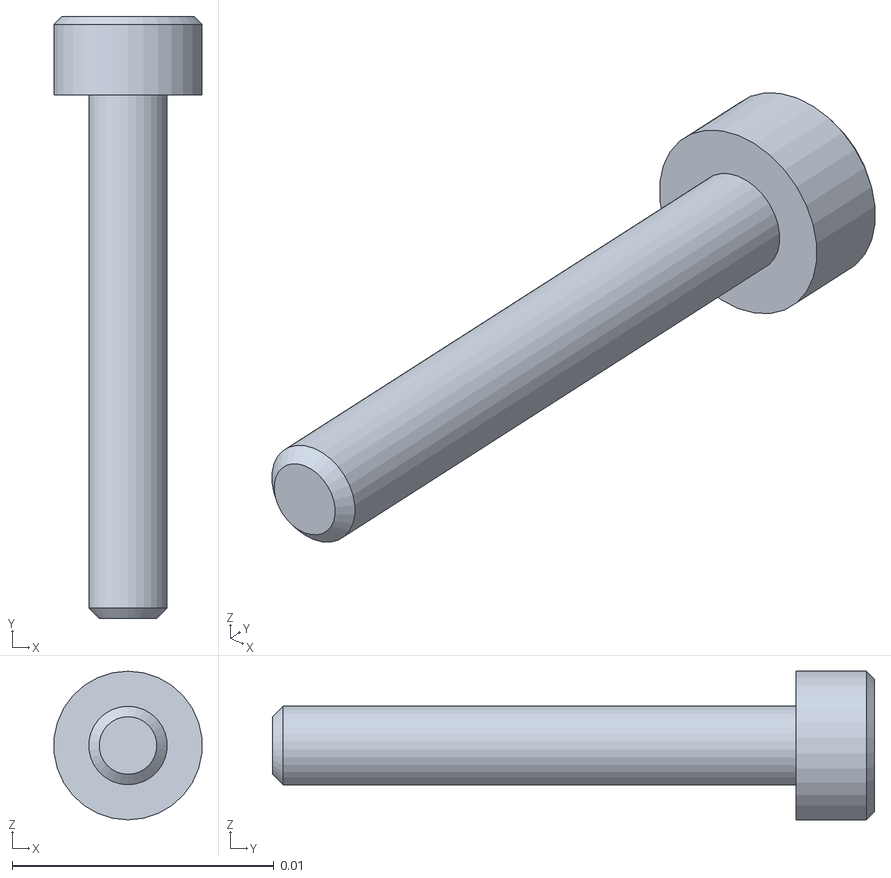
[picture p154: CAD file, 2026-10-22]
cad/mesh/F03_M3x20_SHCS.STL
0.00565 x 0.023 x 0.00568
