Dalcouffe1/Design-Build-Fly/cad/mesh/F07_M3x8_BHCS.STL

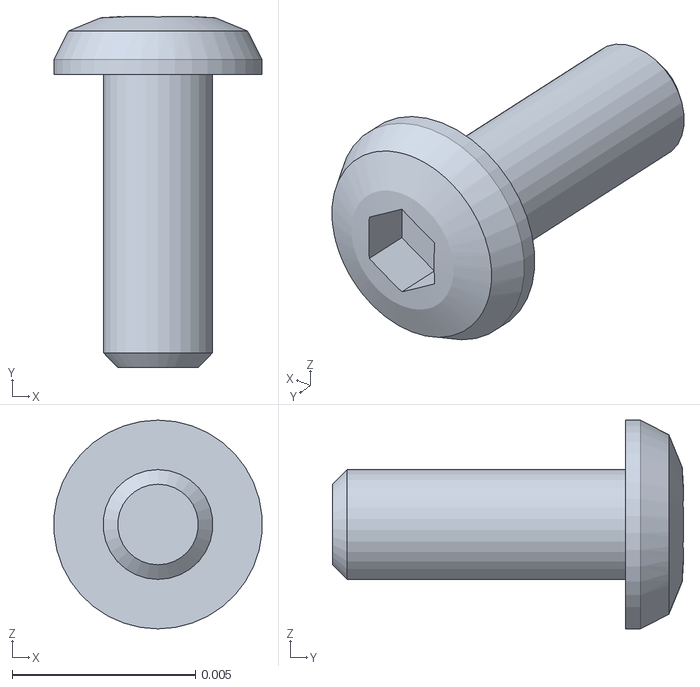
[picture p155: CAD file, 2026-10-22]
cad/mesh/F07_M3x8_BHCS.STL
0.00568 x 0.00959 x 0.0057
