Dalcouffe1/Design-Build-Fly/cad/model/Gear_Clamp_Lower.SLDPRT

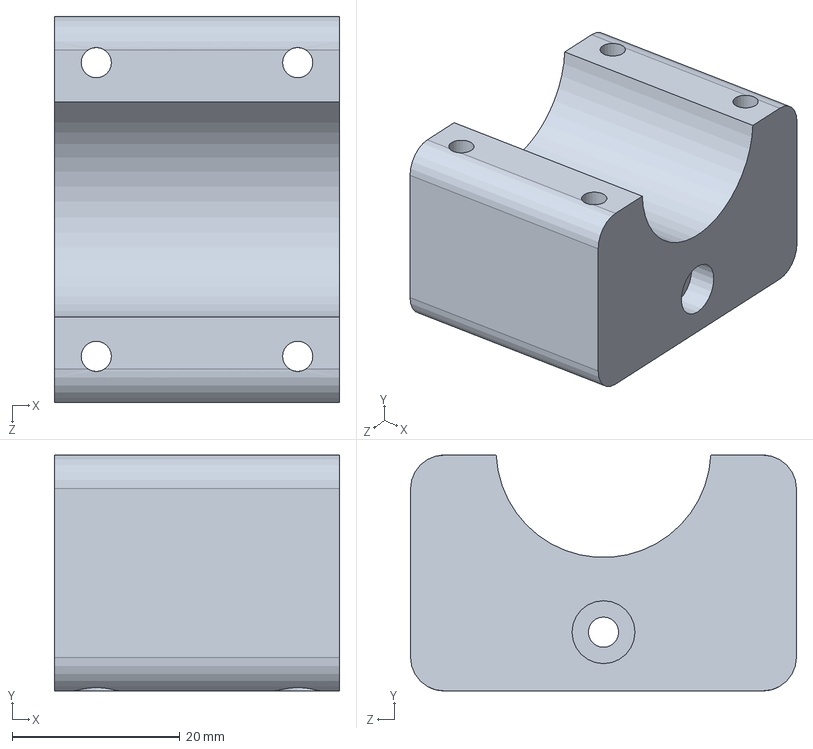
[picture p156: CAD file, 2026-10-25]
cad/model/Gear_Clamp_Lower.SLDPRT
34.0 x 28.1 x 46.0 mm
