Dalcouffe1/Design-Build-Fly/cad/mesh/Motor_Mount_Cap.STL

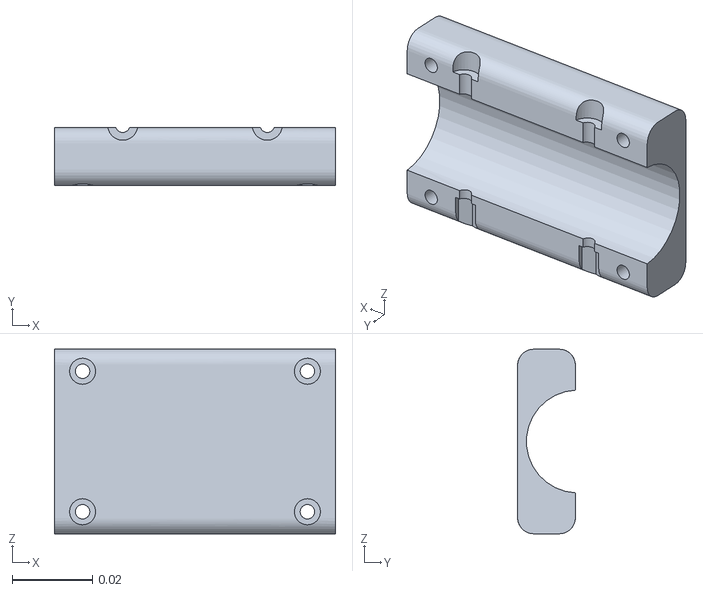
[picture p157: CAD file, 2026-10-22]
cad/mesh/Motor_Mount_Cap.STL
0.07 x 0.0144 x 0.046
