Dalcouffe1/Design-Build-Fly/cad/model/Horn_Hardpoint.SLDPRT

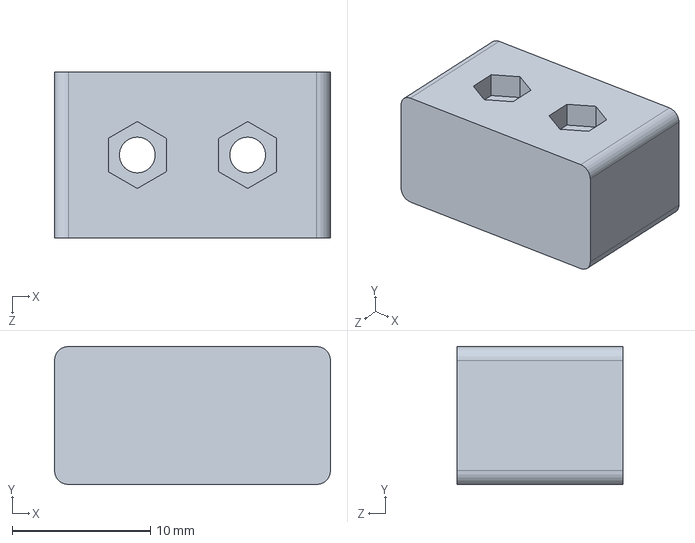
[picture p158: CAD file, 2026-10-25]
cad/model/Horn_Hardpoint.SLDPRT
20.0 x 10.0 x 12.0 mm
