Dalcouffe1/Design-Build-Fly/cad/model/Splice_Plug.SLDPRT

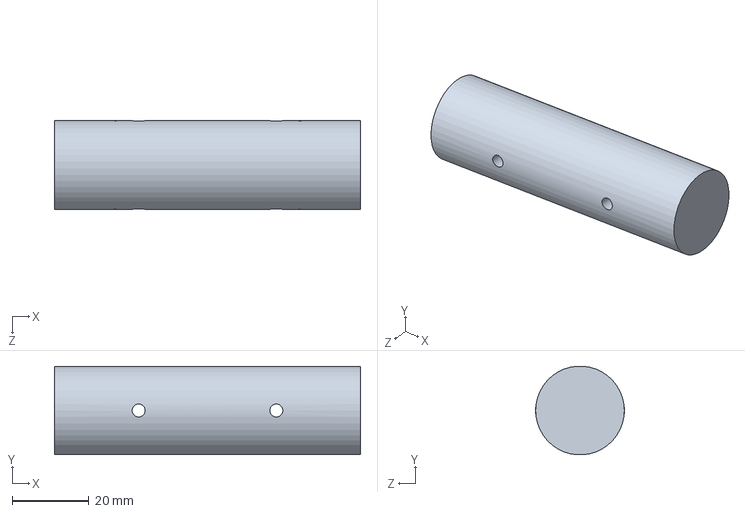
[picture p159: CAD file, 2026-10-25]
cad/model/Splice_Plug.SLDPRT
80.0 x 23.1 x 23.2 mm
