Dalcouffe1/Design-Build-Fly/cad/mesh/Servo.STL

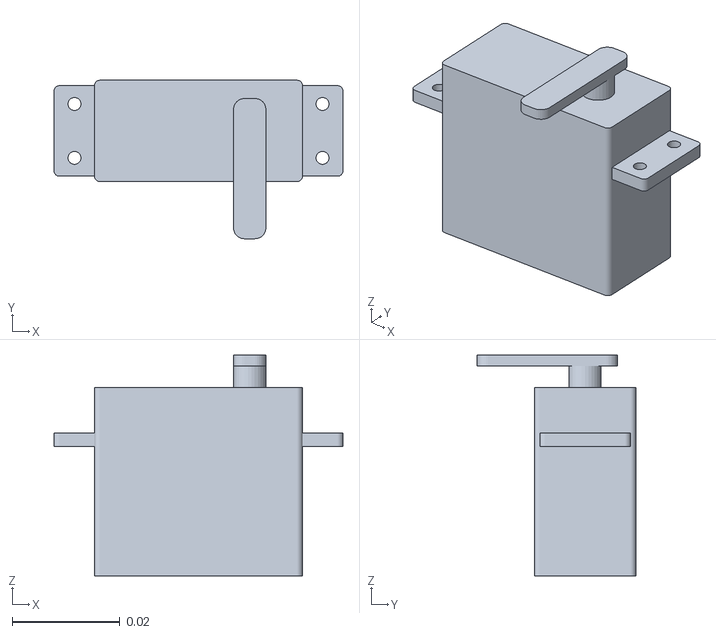
[picture p160: CAD file, 2026-10-22]
cad/mesh/Servo.STL
0.0536 x 0.0294 x 0.0409
