Dalcouffe1/Design-Build-Fly/cad/model/N02_M5_Nylock.SLDPRT

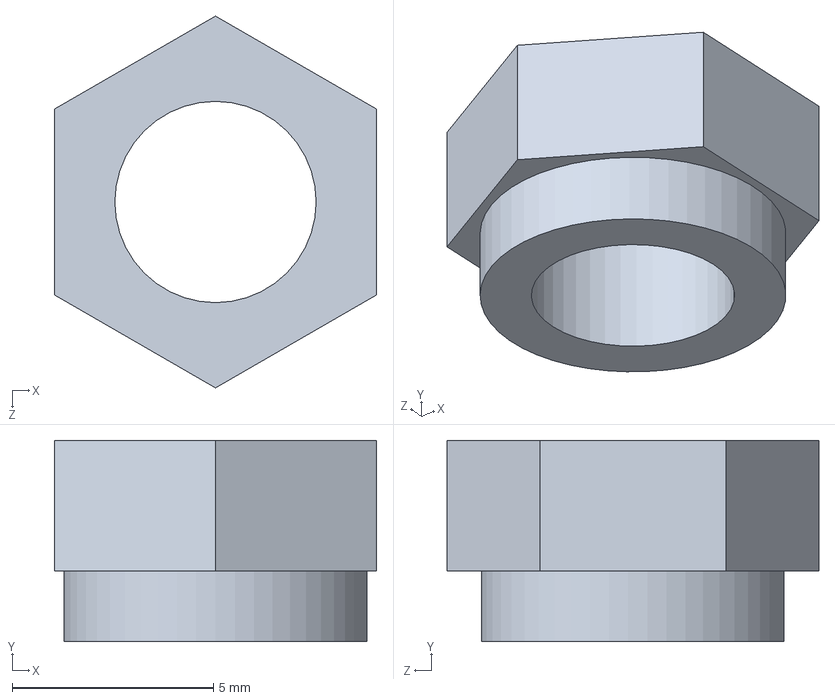
[picture p161: CAD file, 2026-10-25]
cad/model/N02_M5_Nylock.SLDPRT
8.00 x 5.00 x 9.24 mm
