Dalcouffe1/Design-Build-Fly/cad/mesh/Canopy.STL

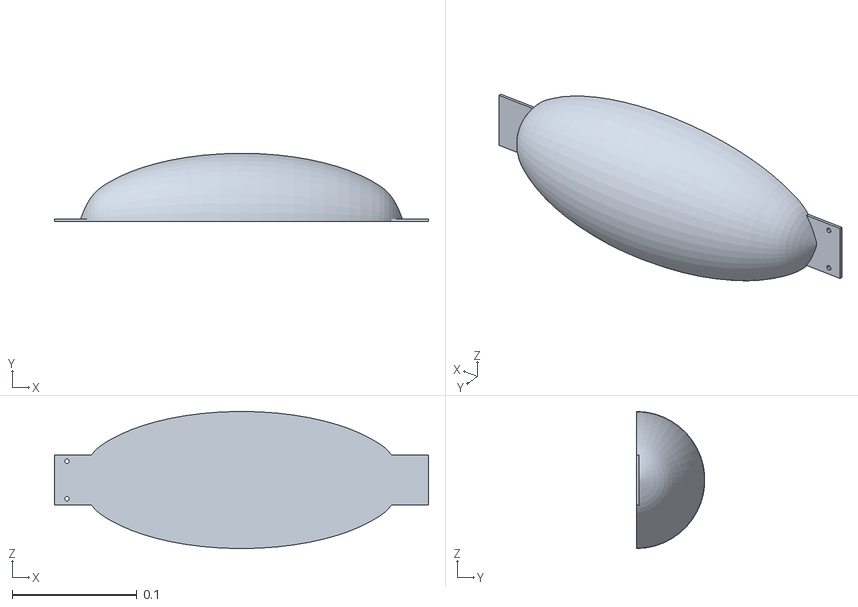
[picture p162: CAD file, 2026-10-22]
cad/mesh/Canopy.STL
0.3 x 0.0549 x 0.11
