Dalcouffe1/Design-Build-Fly/cad/model/H_Tail.SLDPRT

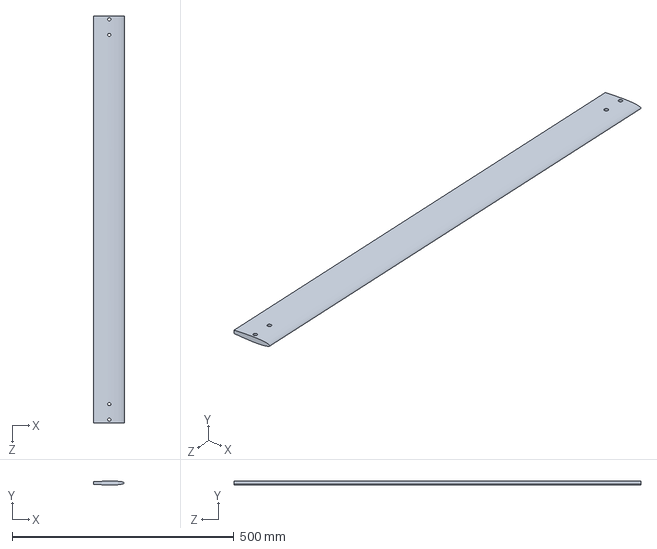
[picture p163: CAD file, 2026-10-25]
cad/model/H_Tail.SLDPRT
69.0 x 9.14 x 917.4 mm
