Dalcouffe1/Design-Build-Fly/cad/mesh/Boom_Clamp_R_Lower.STL

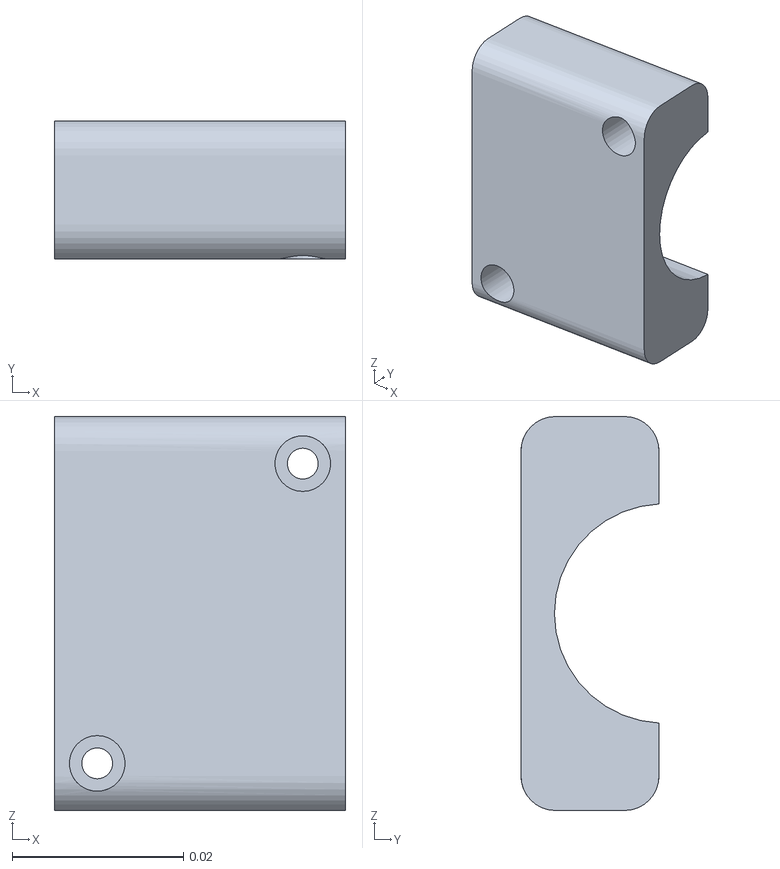
[picture p164: CAD file, 2026-10-22]
cad/mesh/Boom_Clamp_R_Lower.STL
0.034 x 0.0161 x 0.046
