Dalcouffe1/Design-Build-Fly/cad/mesh/Pusher_Cup.STL

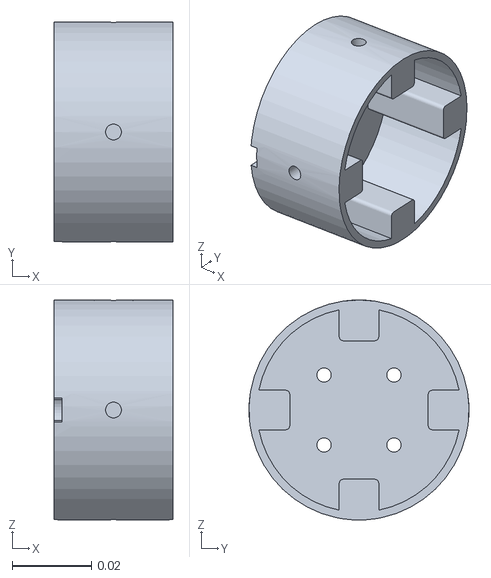
[picture p165: CAD file, 2026-10-22]
cad/mesh/Pusher_Cup.STL
0.03 x 0.0556 x 0.0556
