Dalcouffe1/Design-Build-Fly/cad/model/Servo.SLDPRT

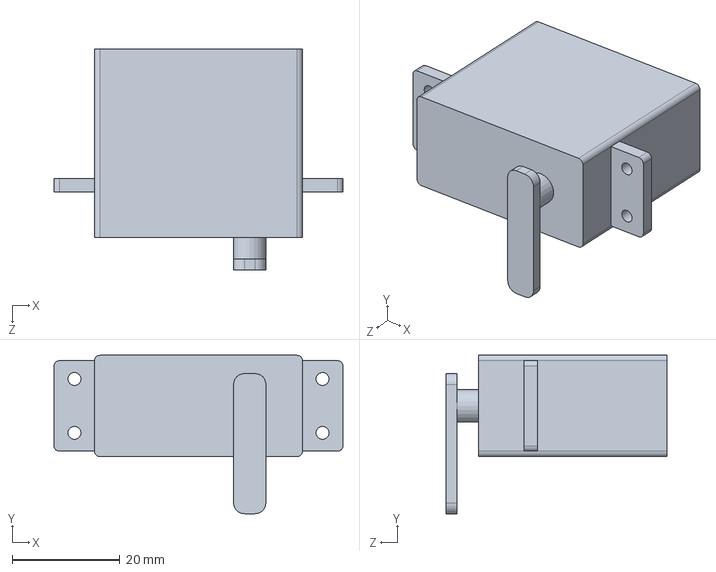
[picture p166: CAD file, 2026-10-25]
cad/model/Servo.SLDPRT
53.6 x 29.4 x 40.9 mm
