Dalcouffe1/Design-Build-Fly/cad/mesh/Joiner_Stop.STL

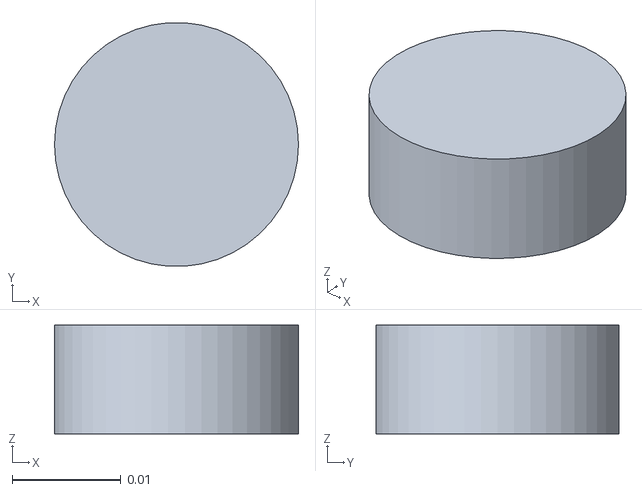
[picture p167: CAD file, 2026-10-22]
cad/mesh/Joiner_Stop.STL
0.0224 x 0.0223 x 0.01
