Dalcouffe1/Design-Build-Fly/cad/model/Spar_Collar.SLDPRT

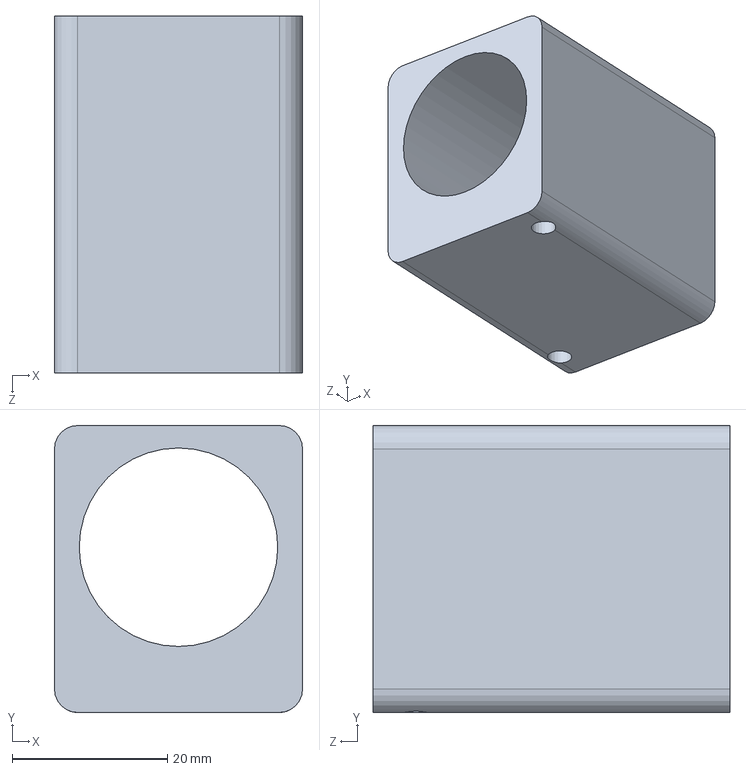
[picture p168: CAD file, 2026-10-25]
cad/model/Spar_Collar.SLDPRT
32.0 x 37.0 x 46.0 mm
