Dalcouffe1/Design-Build-Fly/cad/mesh/Pusher_Prop_14in.STL

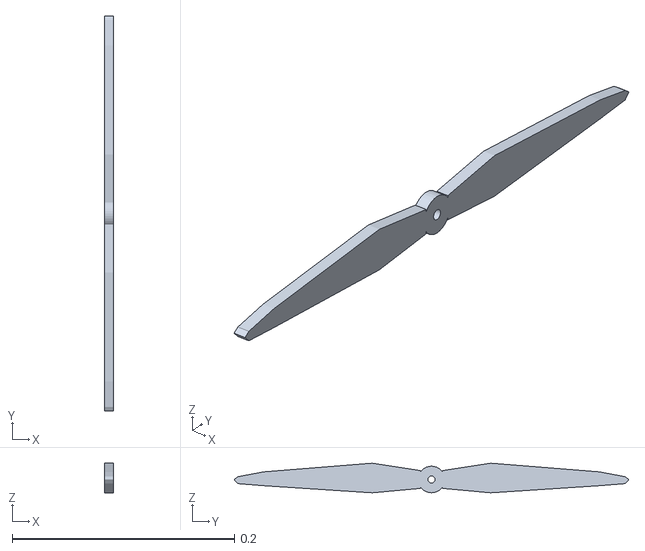
[picture p169: CAD file, 2026-10-22]
cad/mesh/Pusher_Prop_14in.STL
0.008 x 0.356 x 0.0267
