Dalcouffe1/Design-Build-Fly/cad/model/Boom_Clamp_R_Upper.SLDPRT

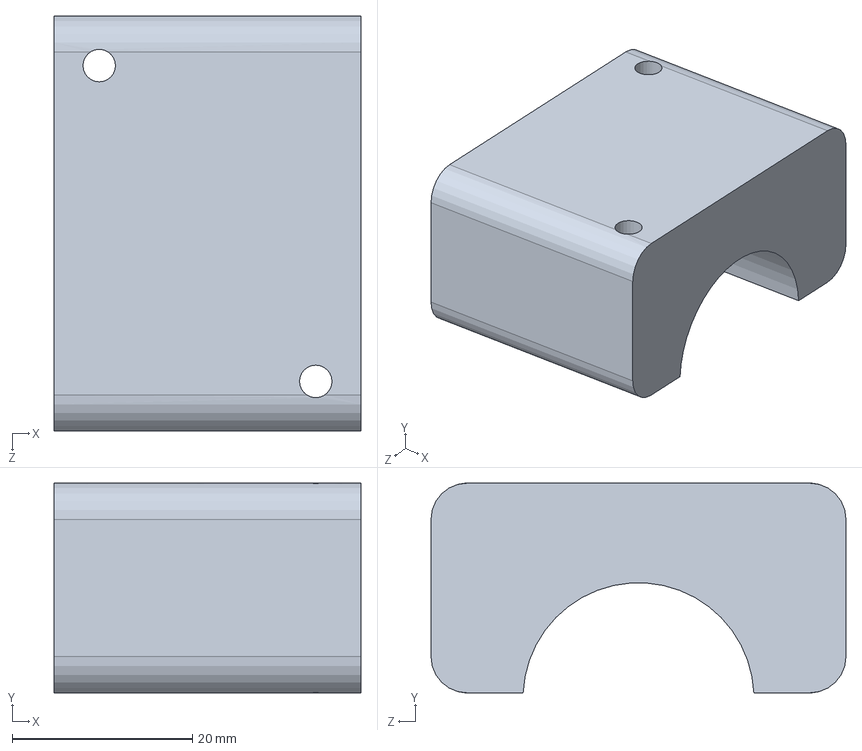
[picture p170: CAD file, 2026-10-25]
cad/model/Boom_Clamp_R_Upper.SLDPRT
34.0 x 23.2 x 46.0 mm
