Dalcouffe1/Design-Build-Fly/cad/mesh/Pusher_Adapter.STL

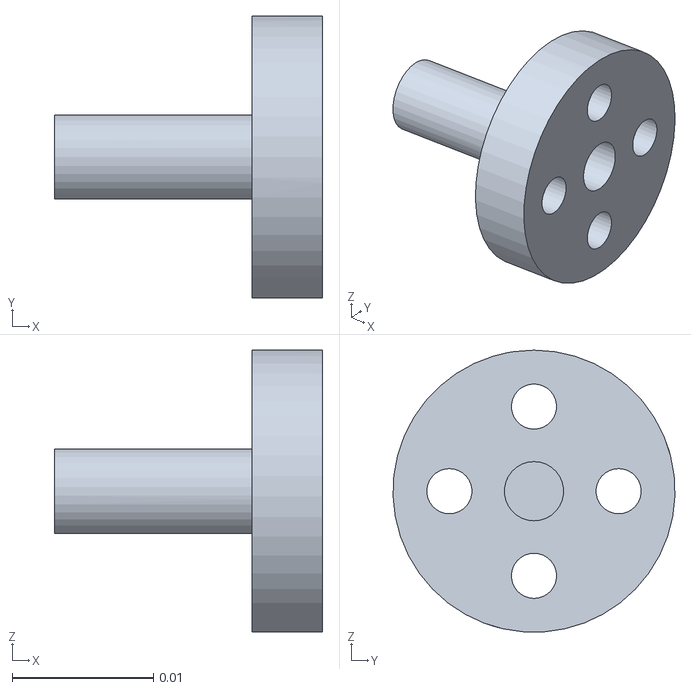
[picture p171: CAD file, 2026-10-22]
cad/mesh/Pusher_Adapter.STL
0.019 x 0.02 x 0.02
