Dalcouffe1/Design-Build-Fly/cad/model/F02_M3x16_SHCS.SLDPRT

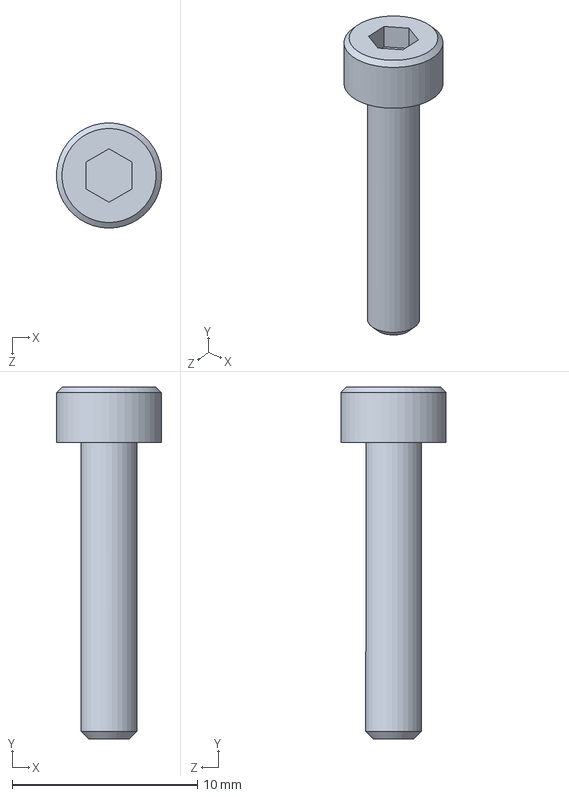
[picture p172: CAD file, 2026-10-25]
cad/model/F02_M3x16_SHCS.SLDPRT
5.66 x 19.0 x 5.68 mm
