Dalcouffe1/Design-Build-Fly/cad/mesh/F10_M2x10_SHCS.STL

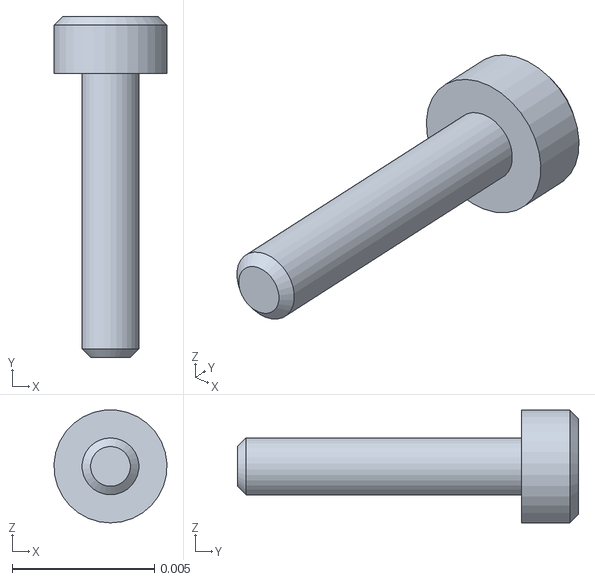
[picture p173: CAD file, 2026-10-22]
cad/mesh/F10_M2x10_SHCS.STL
0.00397 x 0.012 x 0.00397
