Dalcouffe1/Design-Build-Fly/cad/model/Wing_Saddle.SLDPRT

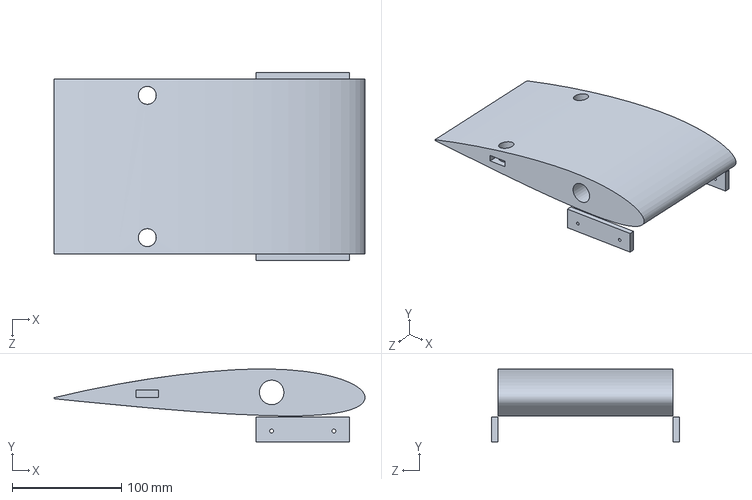
[picture p174: CAD file, 2026-10-25]
cad/model/Wing_Saddle.SLDPRT
284.2 x 66.7 x 172.0 mm
