Dalcouffe1/Design-Build-Fly/cad/mesh/Pitot_Tube.STL

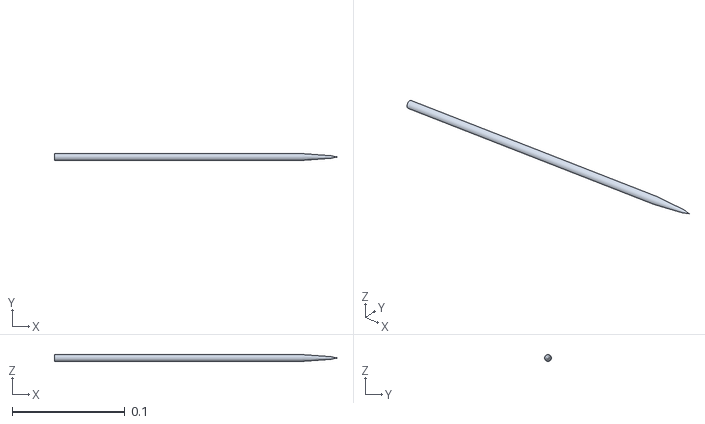
[picture p175: CAD file, 2026-10-14]
cad/mesh/Pitot_Tube.STL
0.25 x 0.00597 x 0.006
