Dalcouffe1/Design-Build-Fly/cad/mesh/Wing_Joiner.STL

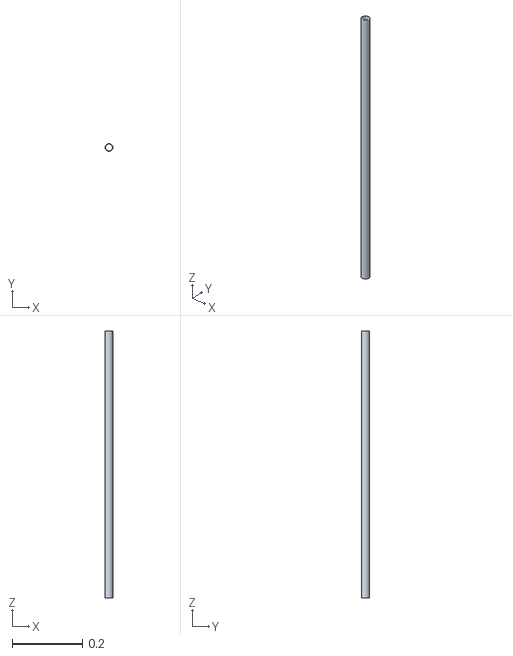
[picture p176: CAD file, 2026-10-14]
cad/mesh/Wing_Joiner.STL
0.0222 x 0.0221 x 0.76
