Dalcouffe1/Design-Build-Fly/cad/model/Rudder.SLDPRT

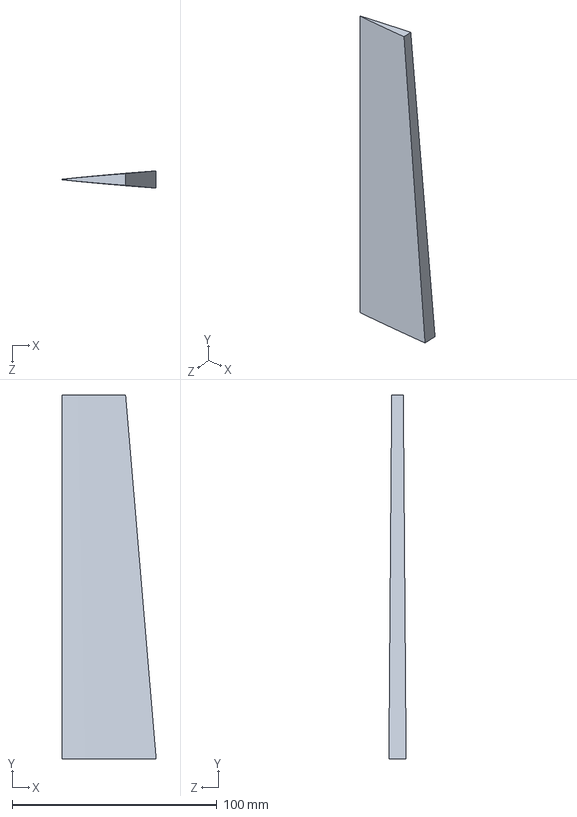
[picture p177: CAD file, 2026-10-25]
cad/model/Rudder.SLDPRT
46.1 x 177.6 x 8.43 mm
