Dalcouffe1/Design-Build-Fly/cad/mesh/Spar_Tube.STL

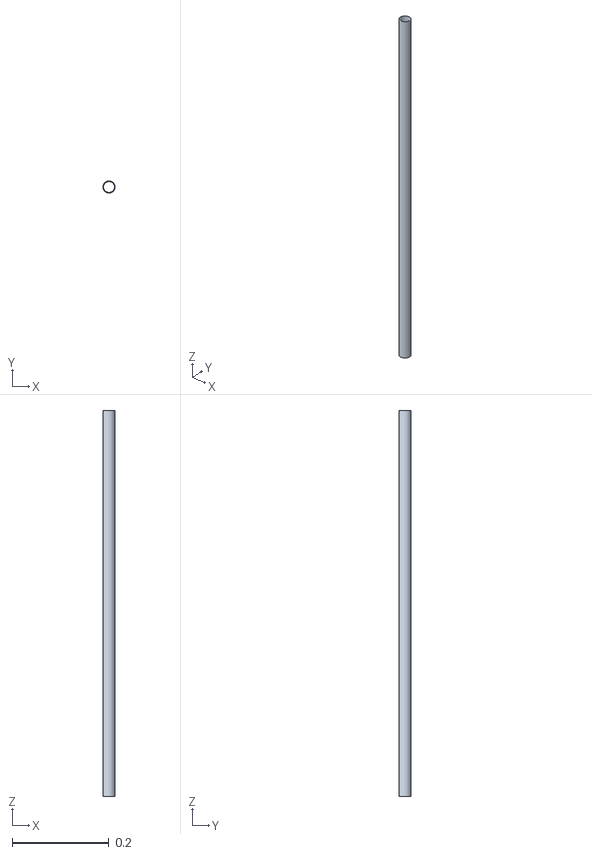
[picture p178: CAD file, 2026-10-14]
cad/mesh/Spar_Tube.STL
0.0254 x 0.0253 x 0.8
