Dalcouffe1/Design-Build-Fly/cad/model/Motor_Mount_Upper.SLDPRT

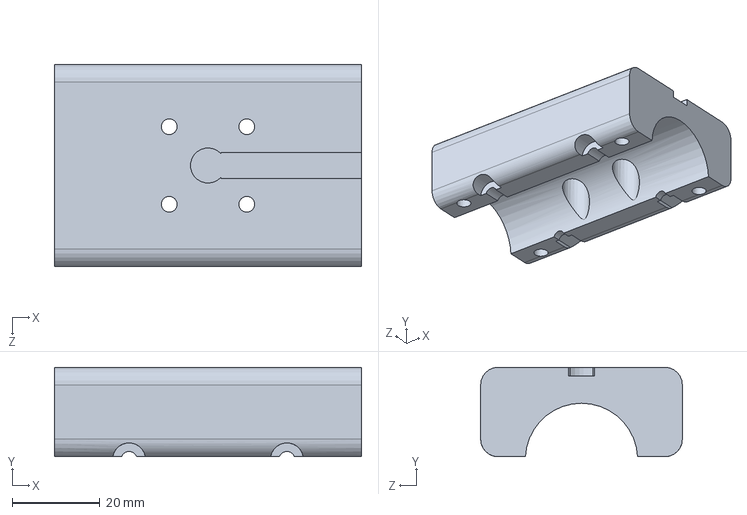
[picture p179: CAD file, 2026-10-25]
cad/model/Motor_Mount_Upper.SLDPRT
70.0 x 20.4 x 46.0 mm
