Dalcouffe1/Design-Build-Fly/cad/mesh/Battery_6S_LiPo.STL

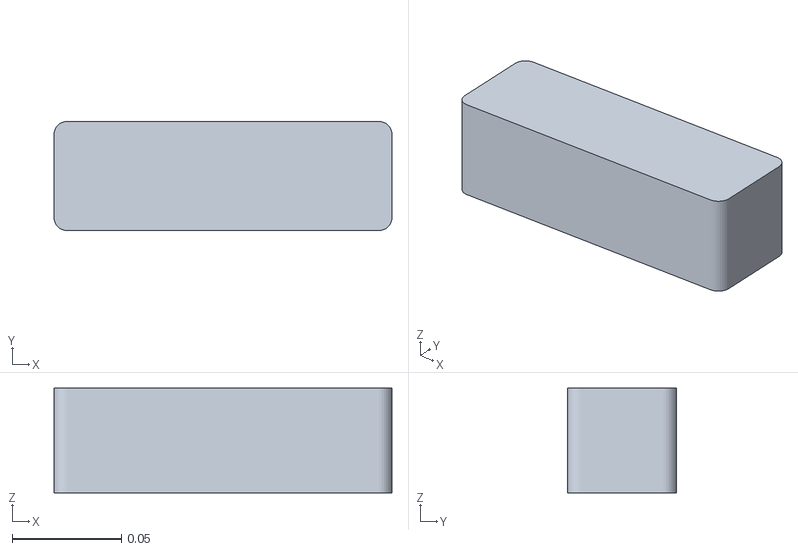
[picture p180: CAD file, 2026-10-14]
cad/mesh/Battery_6S_LiPo.STL
0.155 x 0.05 x 0.048
