Dalcouffe1/Design-Build-Fly/cad/model/Boom_Clamp_R_Lower.SLDPRT

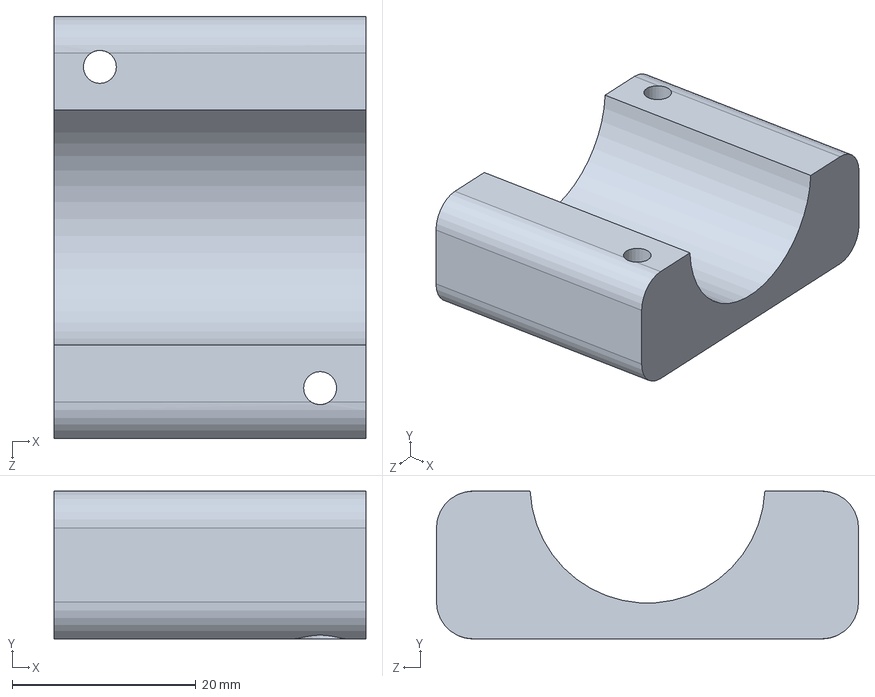
[picture p181: CAD file, 2026-10-25]
cad/model/Boom_Clamp_R_Lower.SLDPRT
34.0 x 16.1 x 46.0 mm
