Dalcouffe1/Design-Build-Fly/cad/model/F08_M3x12_SHCS.SLDPRT

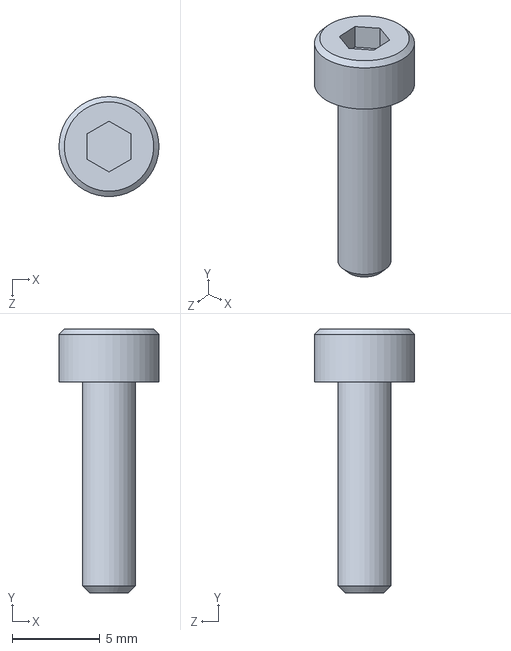
[picture p182: CAD file, 2026-10-25]
cad/model/F08_M3x12_SHCS.SLDPRT
5.68 x 15.0 x 5.67 mm
