Dalcouffe1/Design-Build-Fly/cad/model/VTOL_Exploded.SLDASM

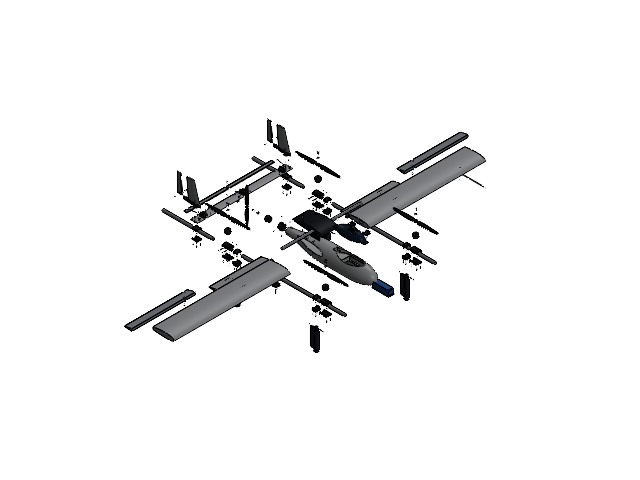
[picture p183: CAD file, 2026-10-25]
cad/model/VTOL_Exploded.SLDASM
Fuselage_Pod
Canopy
F07_M3x8_BHCS x 11
I01_M3_Insert x 67
Battery_Tray
Battery_6S_LiPo
FC_Tray
Flight_Controller
Wing_Panel_R
Wing_Panel_L
Aileron_R
Aileron_L
Spar_Tube x 2
Wing_Joiner
Joiner_Stop x 2
Wing_Saddle
Bolt_Pillar x 2
Root_Tongue x 2
F09_M5x20_BHCS x 2
N02_M5_Nylock x 2
F08_M3x12_SHCS x 4
Boom_Front x 2
Boom_Rear_Stub x 2
Splice_Plug x 2
F04_M3x40_SHCS x 8
W01_M3_Washer x 28
N01_M3_Nylock x 8
Motor_Mount_Upper x 4
Motor_Mount_Cap x 4
Lift_Motor x 4
Lift_Prop x 4
Prop_Plate x 4
F02_M3x16_SHCS x 36
F01_M3x8_SHCS x 20
Boom_Clamp_F_Upper x 2
Boom_Clamp_F_Lower x 2
Boom_Clamp_R_Upper x 2
Boom_Clamp_R_Lower x 2
Spar_Collar x 2
Rear_Hardpoint x 2
F06_M3x35_SHCS x 4
Gear_Clamp_Upper x 4
Gear_Clamp_Lower x 4
Landing_Leg x 4
Gear_Fairing x 4
F03_M3x20_SHCS x 16
F05_M3x30_SHCS x 4
Tail_Clamp_Upper x 2
Tail_Clamp_Cap x 2
Fin_Shoe x 2
Fin x 2
Rudder x 2
Crush_Sleeve x 4
Servo_Tray x 5
Servo x 5
F10_M2x10_SHCS x 20
N03_M2_Hex_Nut x 30
Control_Horn x 5
Horn_Backplate x 3
F11_M2x14_PAN x 10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
