Dalcouffe1/Design-Build-Fly/(list of files, cad)

Other CAD files:
cad/sim/thermal/THERM_Motor_Only.SLDPRT
cad/model/Lift_Motor.SLDPRT
cad/mesh/Wing_Panel_R.STL
cad/mesh/Pusher_Motor.STL
cad/mesh/Boom_Clamp_F_Lower.STL
cad/model/Gear_Clamp_Upper.SLDPRT
cad/model/Wing_Panel_L.SLDPRT
cad/model/Aileron_L.SLDPRT
cad/mesh/F13_M3x8_SHCS.STL
cad/model/F13_M3x8_SHCS.SLDPRT
cad/drawings/DBF-DRW-001.SLDDRW
cad/mesh/Bolt_Pillar.STL
cad/mesh/N03_M2_Hex_Nut.STL
cad/mesh/N04_M6_Bullet_Nut.STL
cad/mesh/Prop_Washer.STL
cad/mesh/W01_M3_Washer.STL
cad/model/Bolt_Pillar.SLDPRT
cad/model/N03_M2_Hex_Nut.SLDPRT
cad/model/N04_M6_Bullet_Nut.SLDPRT
cad/model/Prop_Washer.SLDPRT
cad/model/VTOL_Concept.SLDASM
cad/model/W01_M3_Washer.SLDPRT
