Dalcouffe1/Design-Build-Fly/docs/build/templates/section_coordinates.csv

section | chord_mm | surface | x_mm | y_mm
NACA2415_wing | 284.176 | upper | 0.000 | 0.000
NACA2415_wing | 284.176 | upper | -0.033 | 0.824
NACA2415_wing | 284.176 | upper | 0.032 | 1.649
NACA2415_wing | 284.176 | upper | 0.196 | 2.474
NACA2415_wing | 284.176 | upper | 0.458 | 3.299
NACA2415_wing | 284.176 | upper | 0.820 | 4.124
NACA2415_wing | 284.176 | upper | 1.279 | 4.947
NACA2415_wing | 284.176 | upper | 1.837 | 5.769
NACA2415_wing | 284.176 | upper | 2.494 | 6.589
NACA2415_wing | 284.176 | upper | 3.248 | 7.406
NACA2415_wing | 284.176 | upper | 4.100 | 8.219
NACA2415_wing | 284.176 | upper | 5.049 | 9.028
NACA2415_wing | 284.176 | upper | 6.095 | 9.832
NACA2415_wing | 284.176 | upper | 7.236 | 10.629
NACA2415_wing | 284.176 | upper | 8.473 | 11.420
NACA2415_wing | 284.176 | upper | 9.805 | 12.202
NACA2415_wing | 284.176 | upper | 11.230 | 12.976
NACA2415_wing | 284.176 | upper | 12.749 | 13.739
NACA2415_wing | 284.176 | upper | 14.360 | 14.490
NACA2415_wing | 284.176 | upper | 16.061 | 15.230
NACA2415_wing | 284.176 | upper | 17.853 | 15.955
NACA2415_wing | 284.176 | upper | 19.733 | 16.666
NACA2415_wing | 284.176 | upper | 21.701 | 17.362
NACA2415_wing | 284.176 | upper | 23.756 | 18.040
NACA2415_wing | 284.176 | upper | 25.895 | 18.700
NACA2415_wing | 284.176 | upper | 28.117 | 19.341
NACA2415_wing | 284.176 | upper | 30.421 | 19.961
NACA2415_wing | 284.176 | upper | 32.806 | 20.560
NACA2415_wing | 284.176 | upper | 35.269 | 21.137
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
NACA0009_fin_tip | 103.795 | lower | 103.510 | -0.031
NACA0009_fin_tip | 103.795 | lower | 103.635 | -0.017
NACA0009_fin_tip | 103.795 | lower | 103.723 | -0.008
NACA0009_fin_tip | 103.795 | lower | 103.777 | -0.002
NACA0009_fin_tip | 103.795 | lower | 103.795 | 0.000
