Dalcouffe1/Design-Build-Fly/docs/test/analysis/sample/thrust_sample.csv

throttle_pct | thrust_g | volt_V | curr_A
20 | 263 | 22.78 | 0.68
30 | 460 | 22.75 | 1.60
40 | 708 | 22.71 | 3.00
50 | 1002 | 22.65 | 4.93
60 | 1334 | 22.57 | 7.59
70 | 1697 | 22.47 | 11.07
80 | 2164 | 22.33 | 15.65
90 | 2592 | 22.18 | 20.82
100 | 3172 | 21.96 | 27.84
