Dalcouffe1/Design-Build-Fly/firmware/sitl/results/scenario_A_nominal_mission.csv

t | mode | armed | alt | aspd | gspd | thr | volt | curr | dist | wp
161.03 | QSTABILIZE | 0 | 0.04 | 0.54 | 0.03 | 0 | 25.2 | 0.0 | 0.0 | 0
162.03 | QLOITER | 0 | 0.1 | 0.84 | 0.03 | 0 | 25.2 | 0.0 | 0.0 | 0
163.03 | QLOITER | 0 | 0.11 | 0.72 | 0.03 | 0 | 25.2 | 0.0 | 0.0 | 0
164.03 | QLOITER | 0 | 0.12 | 0.74 | 0.03 | 0 | 25.2 | 0.0 | 0.0 | 0
165.04 | QLOITER | 0 | 0.14 | 0.39 | 0.03 | 0 | 25.2 | 0.0 | 0.0 | 0
166.03 | QLOITER | 0 | 0.04 | 0.65 | 0.03 | 0 | 25.2 | 0.0 | 0.0 | 0
167.04 | QLOITER | 1 | -0.01 | 0.25 | 0.03 | 0 | 25.2 | 0.0 | 0.0 | 0
168.04 | QLOITER | 1 | 0.08 | 0.89 | 0.03 | 0 | 25.2 | 0.0 | 0.0 | 0
169.04 | QLOITER | 1 | 1.64 | 0.86 | 0.02 | 19 | 24.91 | 28.8 | 0.1 | 0
170.04 | QLOITER | 1 | 3.35 | 0.09 | 0.16 | 13 | 24.96 | 23.1 | 0.2 | 0
171.04 | QLOITER | 1 | 4.97 | 0.54 | 0.13 | 14 | 24.96 | 22.7 | 0.3 | 0
172.04 | QLOITER | 1 | 6.66 | 0.14 | 0.02 | 14 | 24.95 | 23.2 | 0.3 | 0
173.04 | QLOITER | 1 | 8.35 | 0.78 | 0.06 | 14 | 24.95 | 23.2 | 0.2 | 0
174.04 | QLOITER | 1 | 10.06 | 0.35 | 0.08 | 14 | 24.94 | 23.3 | 0.2 | 0
175.04 | QLOITER | 1 | 11.76 | 0.44 | 0.1 | 14 | 24.93 | 23.2 | 0.1 | 0
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
