Dalcouffe1/Design-Build-Fly/firmware/sitl/results/scenario_B_rc_loss_cruise.csv

t | mode | armed | alt | aspd | gspd | thr | volt | curr | dist | wp
393.04 | QLOITER | 0 | -0.0 | 0.9 | 0.03 | 0 | 25.2 | 0.0 | 0.1 | 7
394.04 | QLOITER | 1 | -0.02 | 0.34 | 0.03 | 0 | 25.2 | 0.0 | 0.1 | 0
395.04 | QLOITER | 1 | 0.05 | 0.8 | 0.03 | 0 | 25.2 | 0.0 | 0.1 | 0
396.04 | QLOITER | 1 | 1.72 | 0.48 | 0.03 | 22 | 24.89 | 31.4 | 0.1 | 0
397.04 | QLOITER | 1 | 3.41 | 0.41 | 0.2 | 13 | 24.97 | 22.6 | 0.2 | 0
398.04 | QLOITER | 1 | 5.07 | 0.95 | 0.15 | 14 | 24.96 | 22.9 | 0.3 | 0
399.04 | QLOITER | 1 | 6.76 | 0.54 | 0.04 | 14 | 24.95 | 23.3 | 0.3 | 0
400.04 | QLOITER | 1 | 8.46 | 0.58 | 0.05 | 14 | 24.95 | 23.3 | 0.2 | 0
401.04 | QLOITER | 1 | 10.17 | 0.53 | 0.08 | 14 | 24.94 | 23.4 | 0.2 | 0
402.04 | QLOITER | 1 | 11.88 | 0.59 | 0.08 | 14 | 24.93 | 23.2 | 0.1 | 0
403.04 | QLOITER | 1 | 13.57 | 0.79 | 0.07 | 14 | 24.93 | 23.2 | 0.2 | 0
404.04 | QLOITER | 1 | 15.27 | 0.75 | 0.04 | 14 | 24.93 | 23.4 | 0.2 | 0
405.04 | QLOITER | 1 | 16.97 | 0.84 | 0.02 | 14 | 24.92 | 23.1 | 0.2 | 0
406.04 | QLOITER | 1 | 18.66 | 0.92 | 0.03 | 14 | 24.92 | 23.3 | 0.2 | 0
407.04 | QLOITER | 1 | 20.37 | 0.79 | 0.04 | 14 | 24.91 | 23.2 | 0.2 | 0
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
