Dalcouffe1/Design-Build-Fly/firmware/sitl/results/scenario_C_rc_loss_hover.csv

t | mode | armed | alt | aspd | gspd | thr | volt | curr | dist | wp
558.03 | QLOITER | 0 | 0.02 | 0.45 | 0.03 | 0 | 25.2 | 0.0 | 0.1 | 0
559.03 | QLOITER | 1 | -0.03 | 0.7 | 0.03 | 0 | 25.2 | 0.0 | 0.1 | 0
560.03 | QLOITER | 1 | 0.15 | 0.89 | 0.03 | 0 | 25.2 | 0.0 | 0.1 | 0
561.03 | QLOITER | 1 | 1.94 | 0.34 | 0.05 | 16 | 24.88 | 29.9 | 0.1 | 0
562.03 | QLOITER | 1 | 3.61 | 0.6 | 0.21 | 13 | 24.97 | 22.2 | 0.2 | 0
563.03 | QLOITER | 1 | 5.24 | 0.94 | 0.13 | 14 | 24.96 | 22.9 | 0.3 | 0
564.03 | QLOITER | 1 | 6.94 | 0.99 | 0.03 | 14 | 24.95 | 23.3 | 0.3 | 0
565.04 | QLOITER | 1 | 8.65 | 0.33 | 0.05 | 14 | 24.94 | 23.1 | 0.2 | 0
566.03 | QLOITER | 1 | 10.35 | 0.18 | 0.08 | 14 | 24.94 | 23.4 | 0.1 | 0
567.04 | QLOITER | 1 | 12.05 | 0.87 | 0.07 | 14 | 24.93 | 23.0 | 0.0 | 0
568.04 | QLOITER | 1 | 13.76 | 0.03 | 0.05 | 14 | 24.93 | 23.4 | 0.1 | 0
569.04 | QLOITER | 1 | 15.46 | 0.22 | 0.02 | 14 | 24.92 | 22.9 | 0.1 | 0
570.04 | QLOITER | 1 | 16.84 | 0.42 | 0.03 | 14 | 24.92 | 23.3 | 0.1 | 0
571.04 | QLOITER | 1 | 17.53 | 0.6 | 0.04 | 12 | 24.94 | 20.3 | 0.2 | 0
572.04 | QLOITER | 1 | 17.71 | 0.3 | 0.13 | 12 | 24.94 | 20.5 | 0.4 | 0
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
