Dalcouffe1/Design-Build-Fly/analysis/thermal/img/lift_unit_hover_history.png

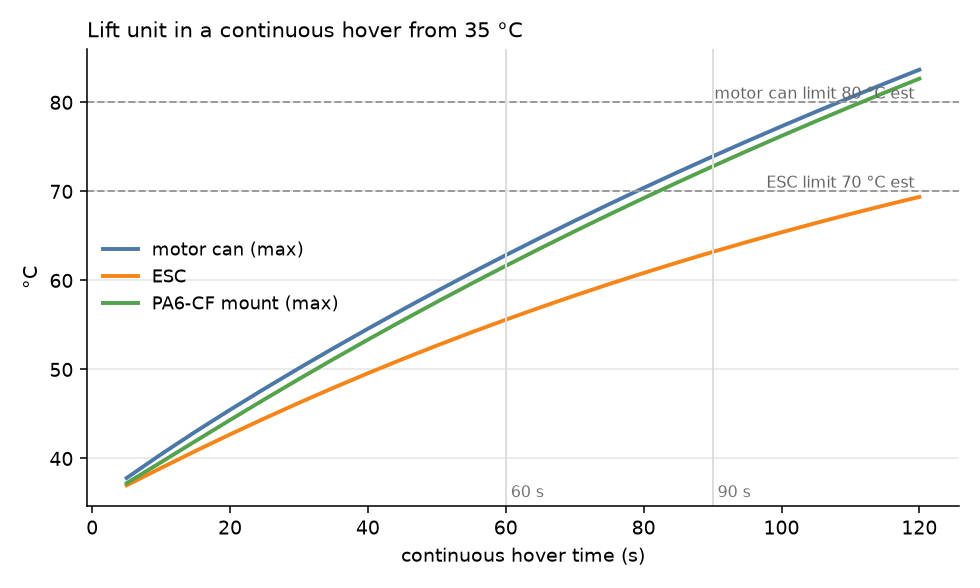
analysis/thermal/img/lift_unit_hover_history.png
