Dalcouffe1/Design-Build-Fly/analysis/thermal/img/thermal_mission_history.png

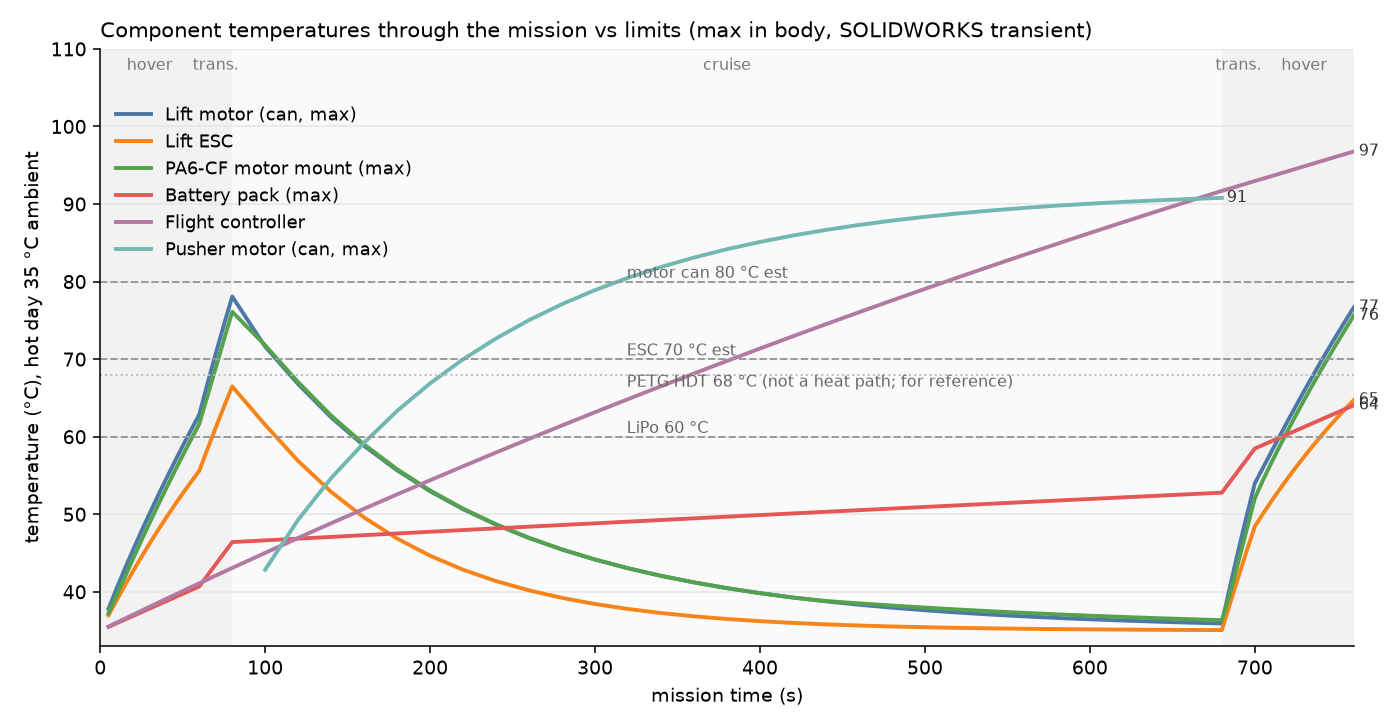
analysis/thermal/img/thermal_mission_history.png
