Dalcouffe1/Design-Build-Fly/cad/drawings/DBF-DRW-001.PDF

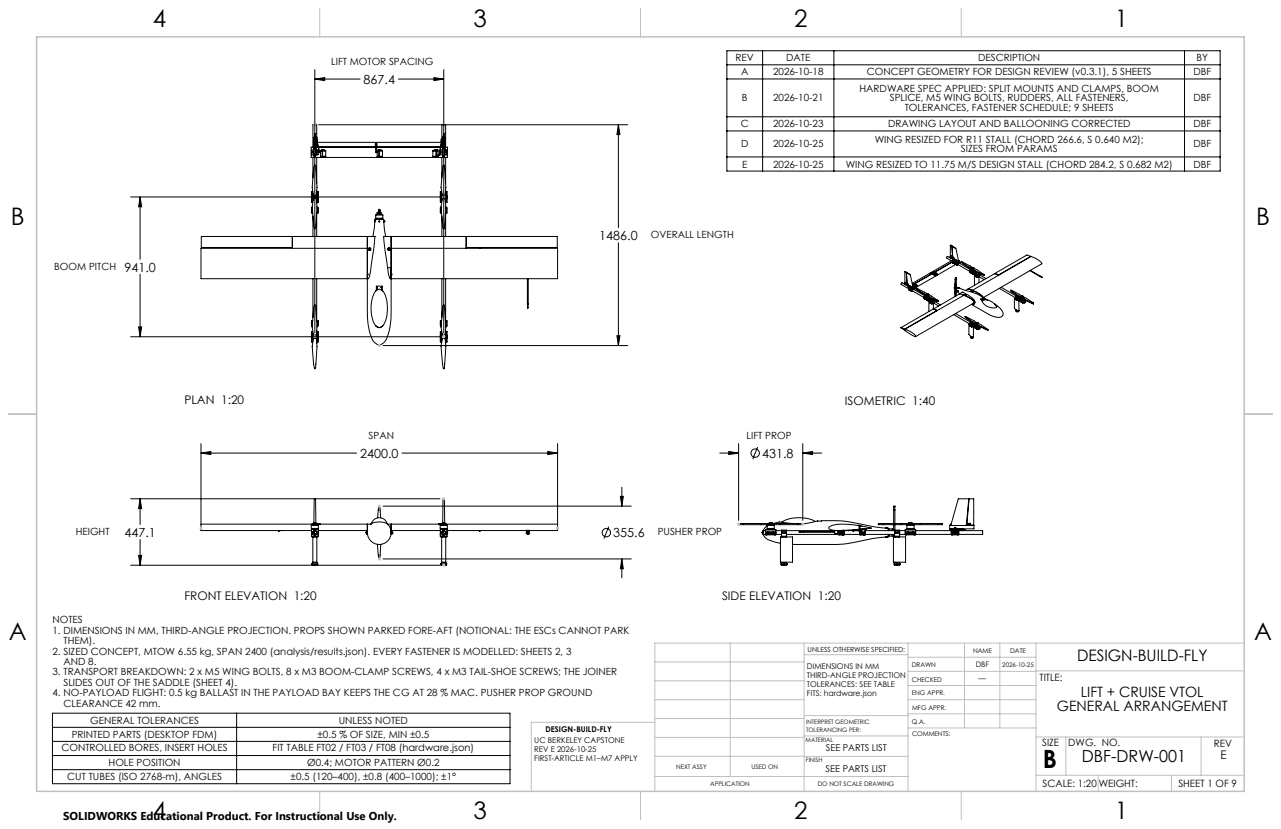
[picture p213: page 1]
HEIGHT; PUSHER PROP; OVERALL LENGTH; BOOM PITCH; LIFT PROP; FRONT ELEVATION 1:20; PLAN 1:20; SIDE ELEVATION 1:20; ISOMETRIC 1:40; GENERAL TOLERANCES; UNLESS NOTED; PRINTED PARTS (DESKTOP FDM); ±0.5 % OF SIZE, MIN ±0.5; HOLE POSITION; Ø0.4; MOTOR PATTERN Ø0.2; CUT TUBES (ISO 2768-m), ANGLES; SHEET 1 OF 9; SCALE: 1:20 WEIGHT:; INTERPRET GEOMETRIC TOLERANCING PER:; NEXT ASSY; USED ON

REV | DATE | DESCRIPTION | BY
A | 2026-10-18 | CONCEPT GEOMETRY FOR DESIGN REVIEW (v0.3.1), 5 SHEETS | DBF
B | 2026-10-21 | HARDWARE SPEC APPLIED: SPLIT MOUNTS AND CLAMPS, BOOM SPLICE, M5 WING BOLTS, RUDDERS, ALL FASTENERS, TOLERANCES, FASTENER SCHEDULE; 9 SHEETS | DBF

LIFT MOTOR SPACING

C | 2026-10-23 | DRAWING LAYOUT AND BALLOONING CORRECTED | DBF
D | 2026-10-25 | WING RESIZED FOR R11 STALL (CHORD 266.6, S 0.640 M2); SIZES FROM PARAMS | DBF
E | 2026-10-25 | WING RESIZED TO 11.75 M/S DESIGN STALL (CHORD 284.2, S 0.682 M2) | DBF

1. DIMENSIONS IN MM, THIRD-ANGLE PROJECTION. PROPS SHOWN PARKED FORE-AFT (NOTIONAL: THE ESCs CANNOT PARK
THEM).
2. SIZED CONCEPT, MTOW 6.55 kg, SPAN 2400 (analysis/results.json). EVERY FASTENER IS MODELLED: SHEETS 2, 3
AND 8.
3. TRANSPORT BREAKDOWN: 2 x M5 WING BOLTS, 8 x M3 BOOM-CLAMP SCREWS, 4 x M3 TAIL-SHOE SCREWS; THE JOINER
SLIDES OUT OF THE SADDLE (SHEET 4).
4. NO-PAYLOAD FLIGHT: 0.5 kg BALLAST IN THE PAYLOAD BAY KEEPS THE CG AT 28 % MAC. PUSHER PROP GROUND
CLEARANCE 42 mm.

UNLESS OTHERWISE SPECIFIED: | | | DATE | DESIGN-BUILD-FLY NAME
DIMENSIONS IN MM THIRD-ANGLE PROJECTION TOLERANCES: SEE TABLE FITS: hardware.json | DRAWN | DBF | 2026-10-25

CHECKED | — | | TITLE: LIFT + CRUISE VTOL GENERAL ARRANGEMENT

ENG APPR.
MFG APPR.

DESIGN-BUILD-FLY
UC BERKELEY CAPSTONE
REV E 2026-10-25
FIRST-ARTICLE M1–M7 APPLY

CONTROLLED BORES, INSERT HOLES | FIT TABLE FT02 / FT03 / FT08 (hardware.json)

MATERIAL SEE PARTS LIST | SIZE B | DWG. NO. DBF-DRW-001 | REV E

SEE PARTS LIST FINISH

SOLIDWORKS Educational Product. For Instructional Use Only.

DO NOT SCALE DRAWING

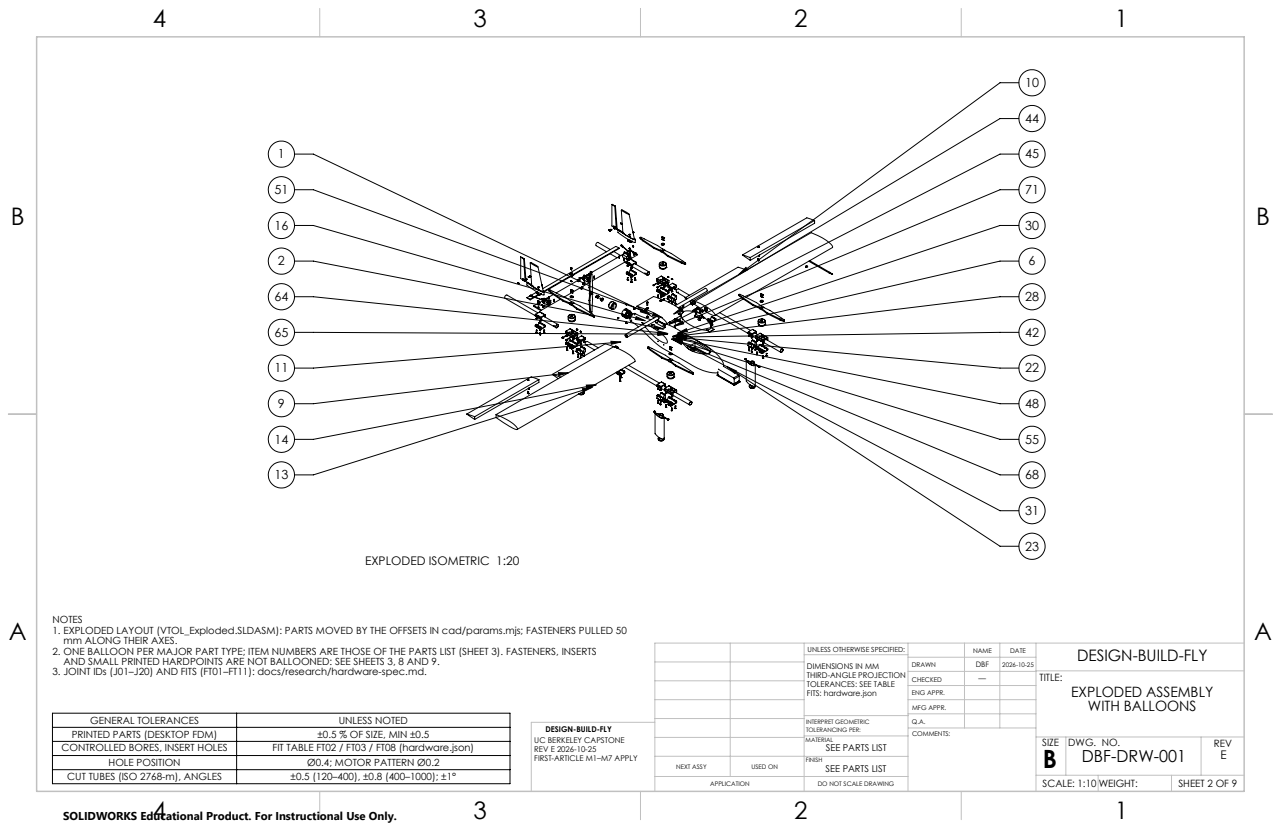
[picture p214: page 2]
EXPLODED ISOMETRIC 1:20; GENERAL TOLERANCES; UNLESS NOTED; PRINTED PARTS (DESKTOP FDM); ±0.5 % OF SIZE, MIN ±0.5; SCALE: 1:10 WEIGHT:; INTERPRET GEOMETRIC TOLERANCING PER:

1. EXPLODED LAYOUT (VTOL_Exploded.SLDASM): PARTS MOVED BY THE OFFSETS IN cad/params.mjs; FASTENERS PULLED 50
mm ALONG THEIR AXES.
2. ONE BALLOON PER MAJOR PART TYPE; ITEM NUMBERS ARE THOSE OF THE PARTS LIST (SHEET 3). FASTENERS, INSERTS
AND SMALL PRINTED HARDPOINTS ARE NOT BALLOONED: SEE SHEETS 3, 8 AND 9.
3. JOINT IDs (J01–J20) AND FITS (FT01–FT11): docs/research/hardware-spec.md.

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

CHECKED | — | | TITLE: EXPLODED ASSEMBLY WITH BALLOONS

ENG APPR.
MFG APPR.

DESIGN-BUILD-FLY
UC BERKELEY CAPSTONE
REV E 2026-10-25
FIRST-ARTICLE M1–M7 APPLY

CONTROLLED BORES, INSERT HOLES | FIT TABLE FT02 / FT03 / FT08 (hardware.json)

MATERIAL SEE PARTS LIST | SIZE B | DWG. NO. DBF-DRW-001 | REV E

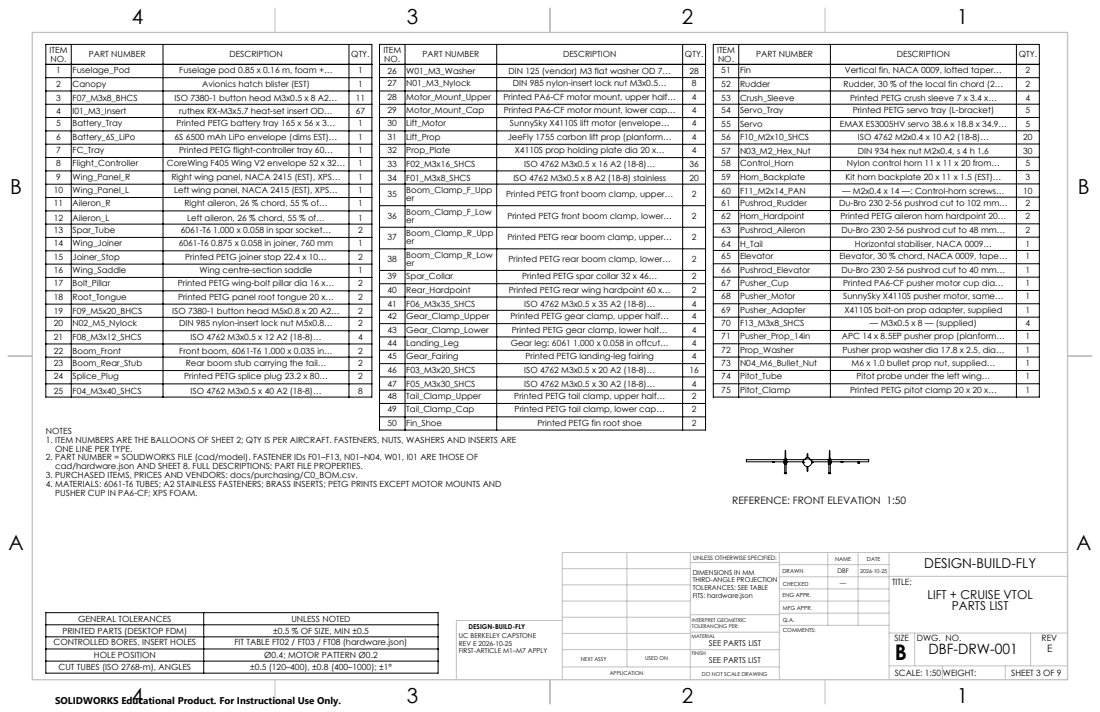
[picture p215: page 3]
PART NUMBER; DESCRIPTION; QTY.; 1 Fuselage_Pod; Fuselage pod 0.85 x 0.16 m, foam +…; 2 Canopy; Avionics hatch blister (EST); 3 F07_M3x8_BHCS; ISO 7380-1 button head M3x0.5 x 8 A2…; 4 I01_M3_Insert; ruthex RX-M3x5.7 heat-set insert OD…; 5 Battery_Tray; Printed PETG battery tray 165 x 56 x 3…; 6 Battery_6S_LiPo; 6S 6500 mAh LiPo envelope (dims EST)…; 7 FC_Tray; Printed PETG flight-controller tray 60…; 8 Flight_Controller; CoreWing F405 Wing V2 envelope 52 x 32… 1; 9 Wing_Panel_R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

NOTES
1. ITEM NUMBERS ARE THE BALLOONS OF SHEET 2; QTY IS PER AIRCRAFT. FASTENERS, NUTS, WASHERS AND INSERTS ARE
ONE LINE PER TYPE.
2. PART NUMBER = SOLIDWORKS FILE (cad/model). FASTENER IDs F01–F13, N01–N04, W01, I01 ARE THOSE OF
cad/hardware.json AND SHEET 8. FULL DESCRIPTIONS: PART FILE PROPERTIES.
3. PURCHASED ITEMS, PRICES AND VENDORS: docs/purchasing/C0_BOM.csv.
4. MATERIALS: 6061-T6 TUBES; A2 STAINLESS FASTENERS; BRASS INSERTS; PETG PRINTS EXCEPT MOTOR MOUNTS AND
PUSHER CUP IN PA6-CF; XPS FOAM.

REFERENCE: FRONT ELEVATION 1:50

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

CHECKED | — | | TITLE: LIFT + CRUISE VTOL PARTS LIST

ENG APPR.
MFG APPR.

DESIGN-BUILD-FLY
UC BERKELEY CAPSTONE
REV E 2026-10-25
FIRST-ARTICLE M1–M7 APPLY

CONTROLLED BORES, INSERT HOLES | FIT TABLE FT02 / FT03 / FT08 (hardware.json)

MATERIAL SEE PARTS LIST | SIZE B | DWG. NO. DBF-DRW-001 | REV E

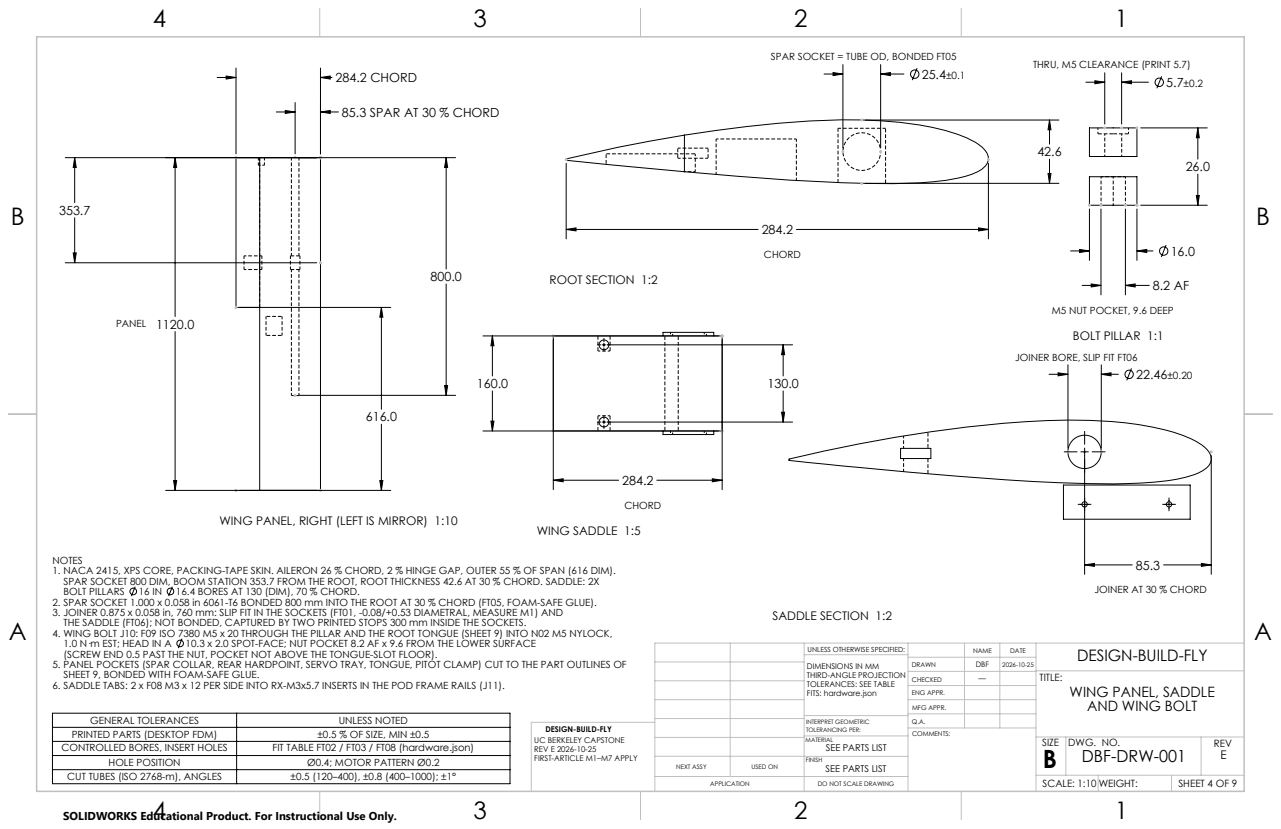
[picture p216: page 4]
284.2 CHORD; ROOT SECTION 1:2; WING SADDLE 1:5; SADDLE SECTION 1:2; GENERAL TOLERANCES; UNLESS NOTED; PRINTED PARTS (DESKTOP FDM); ±0.5 % OF SIZE, MIN ±0.5; SCALE: 1:10 WEIGHT:; INTERPRET GEOMETRIC TOLERANCING PER:

SPAR SOCKET = TUBE OD, BONDED FT05

THRU, M5 CLEARANCE (PRINT 5.7)

85.3 SPAR AT 30 % CHORD

M5 NUT POCKET, 9.6 DEEP
BOLT PILLAR 1:1

JOINER BORE, SLIP FIT FT06

WING PANEL, RIGHT (LEFT IS MIRROR) 1:10

NOTES
1. NACA 2415, XPS CORE, PACKING-TAPE SKIN. AILERON 26 % CHORD, 2 % HINGE GAP, OUTER 55 % OF SPAN (616 DIM).
SPAR SOCKET 800 DIM, BOOM STATION 353.7 FROM THE ROOT, ROOT THICKNESS 42.6 AT 30 % CHORD. SADDLE: 2X
BOLT PILLARS 16 IN 16.4 BORES AT 130 (DIM), 70 % CHORD.
2. SPAR SOCKET 1.000 x 0.058 in 6061-T6 BONDED 800 mm INTO THE ROOT AT 30 % CHORD (FT05, FOAM-SAFE GLUE).
3. JOINER 0.875 x 0.058 in, 760 mm: SLIP FIT IN THE SOCKETS (FT01, -0.08/+0.53 DIAMETRAL, MEASURE M1) AND

JOINER AT 30 % CHORD

THE SADDLE (FT06); NOT BONDED, CAPTURED BY TWO PRINTED STOPS 300 mm INSIDE THE SOCKETS.
4. WING BOLT J10: F09 ISO 7380 M5 x 20 THROUGH THE PILLAR AND THE ROOT TONGUE (SHEET 9) INTO N02 M5 NYLOCK,
1.0 N·m EST; HEAD IN A 10.3 x 2.0 SPOT-FACE; NUT POCKET 8.2 AF x 9.6 FROM THE LOWER SURFACE
(SCREW END 0.5 PAST THE NUT, POCKET NOT ABOVE THE TONGUE-SLOT FLOOR).
5. PANEL POCKETS (SPAR COLLAR, REAR HARDPOINT, SERVO TRAY, TONGUE, PITOT CLAMP) CUT TO THE PART OUTLINES OF
SHEET 9, BONDED WITH FOAM-SAFE GLUE.
6. SADDLE TABS: 2 x F08 M3 x 12 PER SIDE INTO RX-M3x5.7 INSERTS IN THE POD FRAME RAILS (J11).

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

CHECKED | — | | TITLE: WING PANEL, SADDLE AND WING BOLT

ENG APPR.
MFG APPR.

DESIGN-BUILD-FLY
UC BERKELEY CAPSTONE
REV E 2026-10-25
FIRST-ARTICLE M1–M7 APPLY

CONTROLLED BORES, INSERT HOLES | FIT TABLE FT02 / FT03 / FT08 (hardware.json)

MATERIAL SEE PARTS LIST | SIZE B | DWG. NO. DBF-DRW-001 | REV E

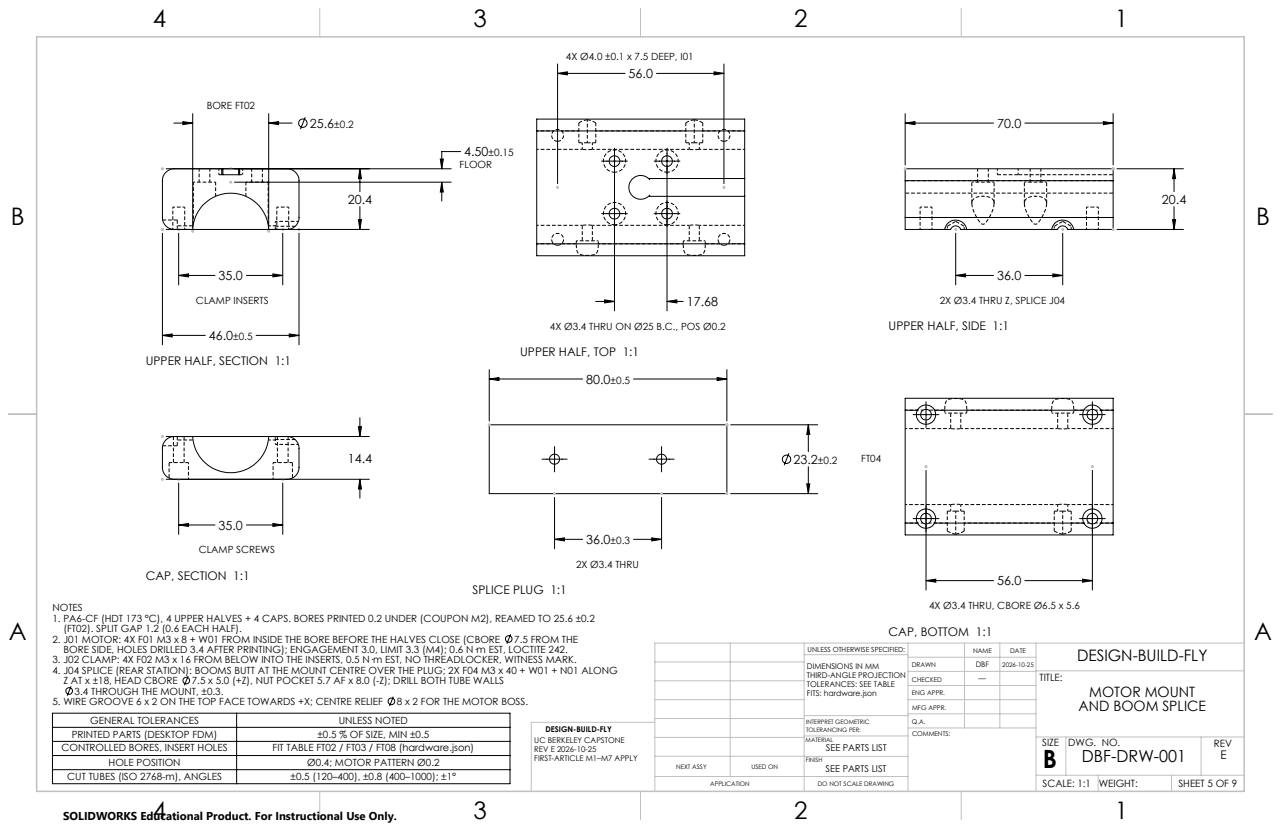
[picture p217: page 5]
CLAMP INSERTS; BORE FT02; 4X Ø4.0 ±0.1 x 7.5 DEEP, I01; 2X Ø3.4 THRU Z, SPLICE J04; CLAMP SCREWS; 4X Ø3.4 THRU, CBORE Ø6.5 x 5.6; 2X Ø3.4 THRU; UPPER HALF, SECTION 1:1; UPPER HALF, TOP 1:1; CAP, SECTION 1:1; CAP, BOTTOM 1:1; SPLICE PLUG 1:1; GENERAL TOLERANCES; UNLESS NOTED; PRINTED PARTS (DESKTOP FDM); ±0.5 % OF SIZE, MIN ±0.5; SCALE: 1:1; WEIGHT:; INTERPRET GEOMETRIC TOLERANCING PER:

4X Ø3.4 THRU ON Ø25 B.C., POS Ø0.2

UPPER HALF, SIDE 1:1

NOTES
1. PA6-CF (HDT 173 °C), 4 UPPER HALVES + 4 CAPS. BORES PRINTED 0.2 UNDER (COUPON M2), REAMED TO 25.6 ±0.2

(FT02). SPLIT GAP 1.2 (0.6 EACH HALF).
2. J01 MOTOR: 4X F01 M3 x 8 + W01 FROM INSIDE THE BORE BEFORE THE HALVES CLOSE (CBORE 7.5 FROM THE
BORE SIDE, HOLES DRILLED 3.4 AFTER PRINTING); ENGAGEMENT 3.0, LIMIT 3.3 (M4); 0.6 N·m EST, LOCTITE 242.
3. J02 CLAMP: 4X F02 M3 x 16 FROM BELOW INTO THE INSERTS, 0.5 N·m EST, NO THREADLOCKER, WITNESS MARK.
4. J04 SPLICE (REAR STATION): BOOMS BUTT AT THE MOUNT CENTRE OVER THE PLUG; 2X F04 M3 x 40 + W01 + N01 ALONG
Z AT x ±18, HEAD CBORE 7.5 x 5.0 (+Z), NUT POCKET 5.7 AF x 8.0 (-Z); DRILL BOTH TUBE WALLS
3.4 THROUGH THE MOUNT, ±0.3.
5. WIRE GROOVE 6 x 2 ON THE TOP FACE TOWARDS +X; CENTRE RELIEF 8 x 2 FOR THE MOTOR BOSS.

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

CHECKED | — | | TITLE: MOTOR MOUNT AND BOOM SPLICE

ENG APPR.
MFG APPR.

DESIGN-BUILD-FLY
UC BERKELEY CAPSTONE
REV E 2026-10-25
FIRST-ARTICLE M1–M7 APPLY

CONTROLLED BORES, INSERT HOLES | FIT TABLE FT02 / FT03 / FT08 (hardware.json)

MATERIAL SEE PARTS LIST | SIZE B | DWG. NO. DBF-DRW-001 | REV E

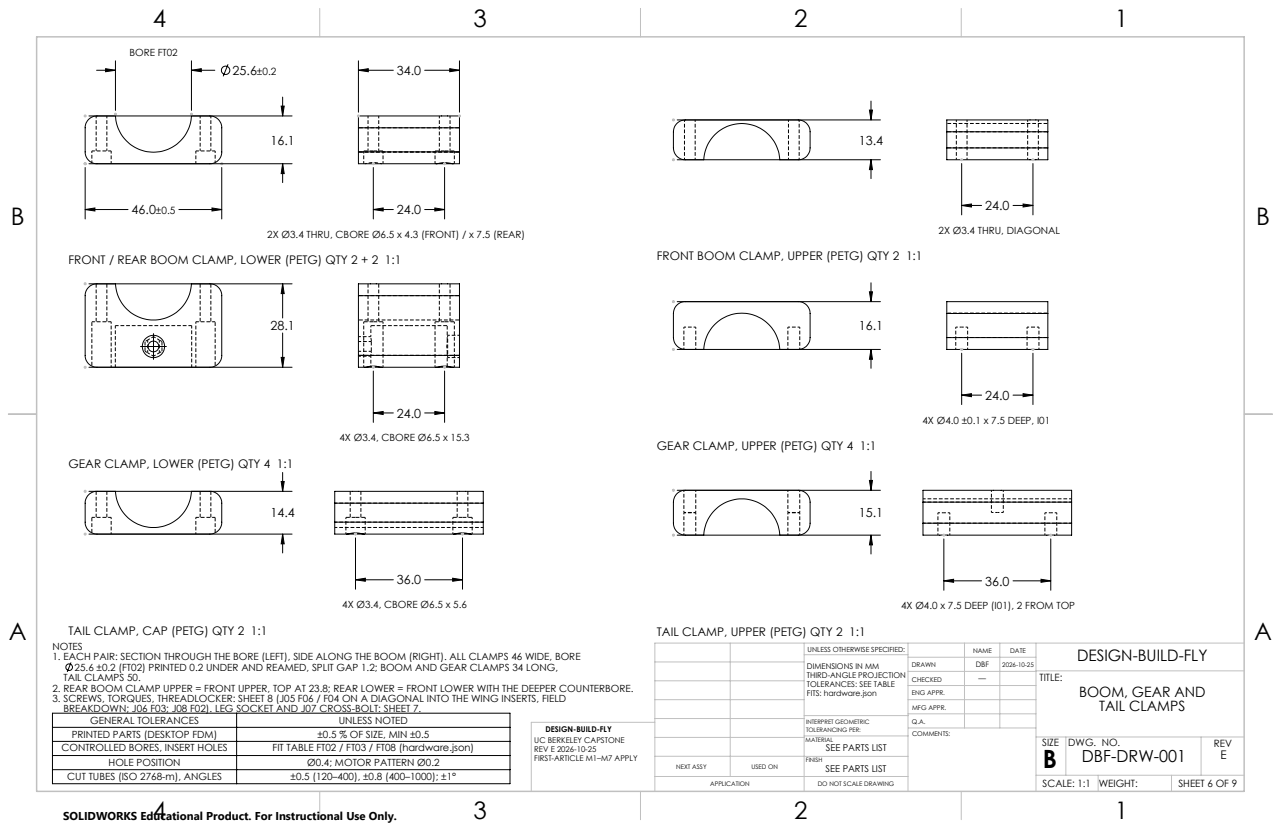
[picture p218: page 6]
BORE FT02; 2X Ø3.4 THRU, DIAGONAL; 4X Ø3.4, CBORE Ø6.5 x 15.3; 4X Ø4.0 ±0.1 x 7.5 DEEP, I01; 4X Ø3.4, CBORE Ø6.5 x 5.6; FRONT / REAR BOOM CLAMP, LOWER (PETG) QTY 2 + 2 1:1; FRONT BOOM CLAMP, UPPER (PETG) QTY 2 1:1; TAIL CLAMP, CAP (PETG) QTY 2 1:1; TAIL CLAMP, UPPER (PETG) QTY 2 1:1; GENERAL TOLERANCES; UNLESS NOTED; PRINTED PARTS (DESKTOP FDM); ±0.5 % OF SIZE, MIN ±0.5; INTERPRET GEOMETRIC TOLERANCING PER:

2X Ø3.4 THRU, CBORE Ø6.5 x 4.3 (FRONT) / x 7.5 (REAR)

GEAR CLAMP, UPPER (PETG) QTY 4 1:1

GEAR CLAMP, LOWER (PETG) QTY 4 1:1

4X Ø4.0 x 7.5 DEEP (I01), 2 FROM TOP

NOTES
1. EACH PAIR: SECTION THROUGH THE BORE (LEFT), SIDE ALONG THE BOOM (RIGHT). ALL CLAMPS 46 WIDE, BORE
25.6 ±0.2 (FT02) PRINTED 0.2 UNDER AND REAMED, SPLIT GAP 1.2; BOOM AND GEAR CLAMPS 34 LONG,
TAIL CLAMPS 50.
2. REAR BOOM CLAMP UPPER = FRONT UPPER, TOP AT 23.8; REAR LOWER = FRONT LOWER WITH THE DEEPER COUNTERBORE.
3. SCREWS, TORQUES, THREADLOCKER: SHEET 8 (J05 F06 / F04 ON A DIAGONAL INTO THE WING INSERTS, FIELD
BREAKDOWN; J06 F03; J08 F02). LEG SOCKET AND J07 CROSS-BOLT: SHEET 7.

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

CHECKED | — | | TITLE: BOOM, GEAR AND TAIL CLAMPS

ENG APPR.
MFG APPR.

DESIGN-BUILD-FLY
UC BERKELEY CAPSTONE
REV E 2026-10-25
FIRST-ARTICLE M1–M7 APPLY

CONTROLLED BORES, INSERT HOLES | FIT TABLE FT02 / FT03 / FT08 (hardware.json)

MATERIAL SEE PARTS LIST | SIZE B | DWG. NO. DBF-DRW-001 | REV E

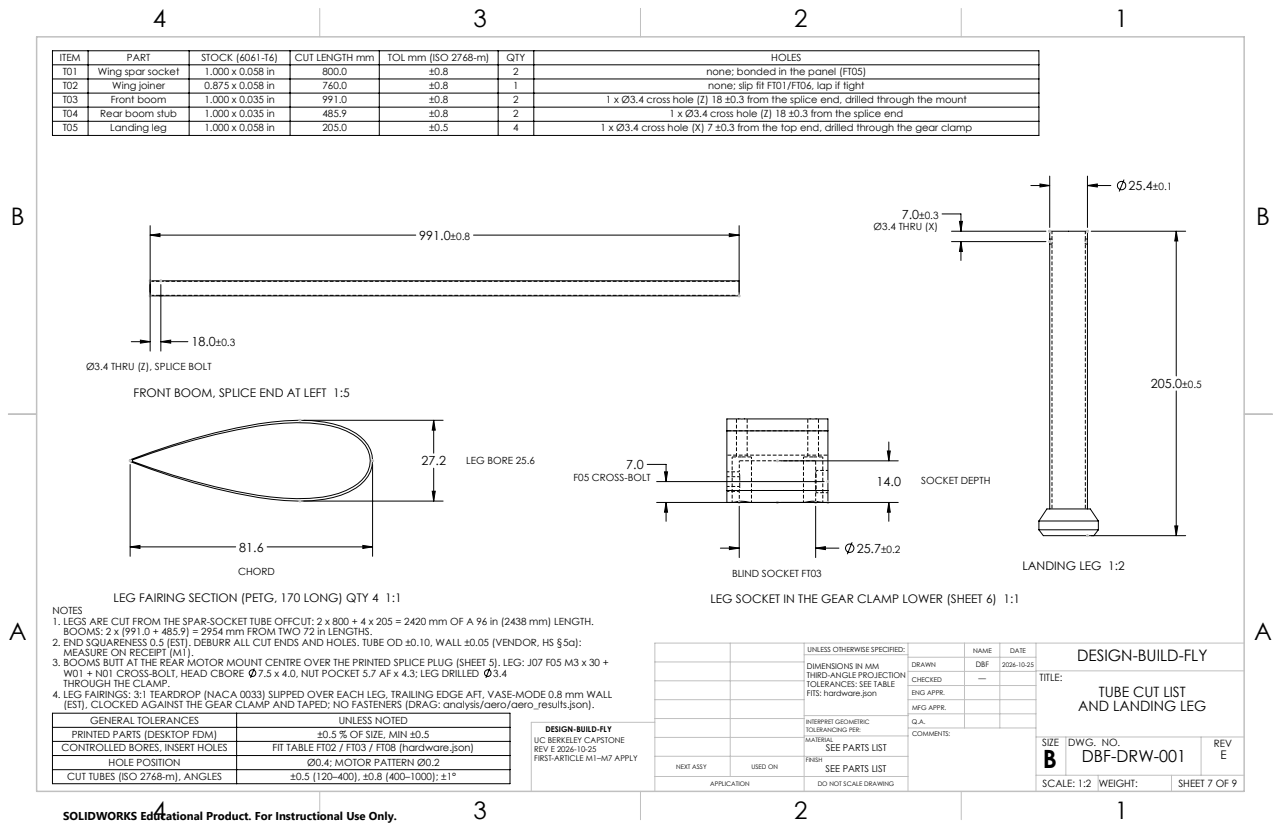
[picture p219: page 7]
Ø3.4 THRU (X) 991.0±0.8; LEG BORE 25.6; SOCKET DEPTH; BLIND SOCKET FT03; F05 CROSS-BOLT; LANDING LEG 1:2; LEG FAIRING SECTION (PETG, 170 LONG) QTY 4 1:1; LEG SOCKET IN THE GEAR CLAMP LOWER (SHEET 6) 1:1; GENERAL TOLERANCES; UNLESS NOTED; PRINTED PARTS (DESKTOP FDM); ±0.5 % OF SIZE, MIN ±0.5; SCALE: 1:2; WEIGHT:; INTERPRET GEOMETRIC TOLERANCING PER:

ITEM | PART | STOCK (6061-T6) | CUT LENGTH mm | TOL mm (ISO 2768-m) | QTY | HOLES
T01 | Wing spar socket | 1.000 x 0.058 in | 800.0 | ±0.8 | 2 | none; bonded in the panel (FT05)
T02 | Wing joiner | 0.875 x 0.058 in | 760.0 | ±0.8 | 1 | none; slip fit FT01/FT06, lap if tight
T03 | Front boom | 1.000 x 0.035 in | 991.0 | ±0.8 | 2 | 1 x Ø3.4 cross hole (Z) 18 ±0.3 from the splice end, drilled through the mount
T04 | Rear boom stub | 1.000 x 0.035 in | 485.9 | ±0.8 | 2 | 1 x Ø3.4 cross hole (Z) 18 ±0.3 from the splice end
T05 | Landing leg | 1.000 x 0.058 in | 205.0 | ±0.5 | 4 | 1 x Ø3.4 cross hole (X) 7 ±0.3 from the top end, drilled through the gear clamp

Ø3.4 THRU (Z), SPLICE BOLT
FRONT BOOM, SPLICE END AT LEFT 1:5

1. LEGS ARE CUT FROM THE SPAR-SOCKET TUBE OFFCUT: 2 x 800 + 4 x 205 = 2420 mm OF A 96 in (2438 mm) LENGTH.
BOOMS: 2 x (991.0 + 485.9) = 2954 mm FROM TWO 72 in LENGTHS.
2. END SQUARENESS 0.5 (EST). DEBURR ALL CUT ENDS AND HOLES. TUBE OD ±0.10, WALL ±0.05 (VENDOR, HS §5a):
MEASURE ON RECEIPT (M1).
3. BOOMS BUTT AT THE REAR MOTOR MOUNT CENTRE OVER THE PRINTED SPLICE PLUG (SHEET 5). LEG: J07 F05 M3 x 30 +
W01 + N01 CROSS-BOLT, HEAD CBORE 7.5 x 4.0, NUT POCKET 5.7 AF x 4.3; LEG DRILLED 3.4
THROUGH THE CLAMP.
4. LEG FAIRINGS: 3:1 TEARDROP (NACA 0033) SLIPPED OVER EACH LEG, TRAILING EDGE AFT, VASE-MODE 0.8 mm WALL
(EST), CLOCKED AGAINST THE GEAR CLAMP AND TAPED; NO FASTENERS (DRAG: analysis/aero/aero_results.json).

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

CHECKED | — | | TITLE: TUBE CUT LIST AND LANDING LEG

ENG APPR.
MFG APPR.

DESIGN-BUILD-FLY
UC BERKELEY CAPSTONE
REV E 2026-10-25
FIRST-ARTICLE M1–M7 APPLY

CONTROLLED BORES, INSERT HOLES | FIT TABLE FT02 / FT03 / FT08 (hardware.json)

MATERIAL SEE PARTS LIST | SIZE B | DWG. NO. DBF-DRW-001 | REV E

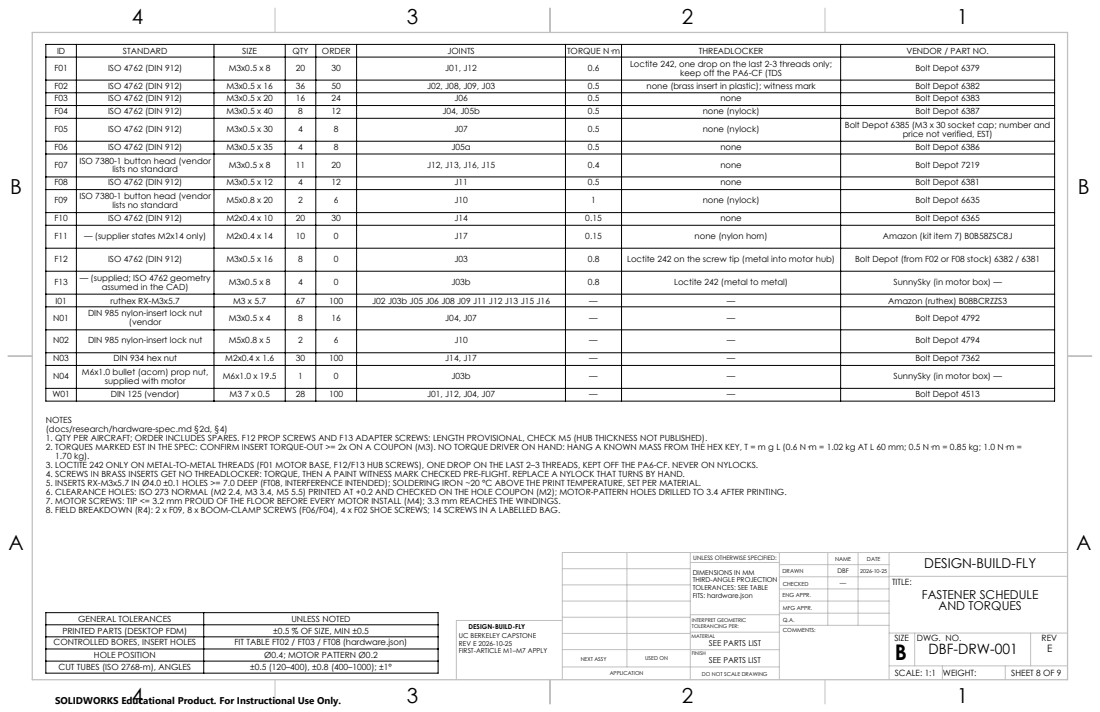
[picture p220: page 8]

F07 ISO 7380-1 button head (vendor

price not verified, EST)

F09 ISO 7380-1 button head (vendor

N04 M6x1.0 bullet (acorn) prop nut,

NOTES
(docs/research/hardware-spec.md §2d, §4)
1. QTY PER AIRCRAFT; ORDER INCLUDES SPARES. F12 PROP SCREWS AND F13 ADAPTER SCREWS: LENGTH PROVISIONAL, CHECK M5 (HUB THICKNESS NOT PUBLISHED).
2. TORQUES MARKED EST IN THE SPEC: CONFIRM INSERT TORQUE-OUT >= 2x ON A COUPON (M3). NO TORQUE DRIVER ON HAND: HANG A KNOWN MASS FROM THE HEX KEY, T = m g L (0.6 N·m = 1.02 kg AT L 60 mm; 0.5 N·m = 0.85 kg; 1.0 N·m =
3. LOCTITE 242 ONLY ON METAL-TO-METAL THREADS (F01 MOTOR BASE, F12/F13 HUB SCREWS), ONE DROP ON THE LAST 2–3 THREADS, KEPT OFF THE PA6-CF. NEVER ON NYLOCKS.
4. SCREWS IN BRASS INSERTS GET NO THREADLOCKER: TORQUE, THEN A PAINT WITNESS MARK CHECKED PRE-FLIGHT. REPLACE A NYLOCK THAT TURNS BY HAND.
5. INSERTS RX-M3x5.7 IN Ø4.0 ±0.1 HOLES >= 7.0 DEEP (FT08, INTERFERENCE INTENDED); SOLDERING IRON ~20 °C ABOVE THE PRINT TEMPERATURE, SET PER MATERIAL.
6. CLEARANCE HOLES: ISO 273 NORMAL (M2 2.4, M3 3.4, M5 5.5) PRINTED AT +0.2 AND CHECKED ON THE HOLE COUPON (M2); MOTOR-PATTERN HOLES DRILLED TO 3.4 AFTER PRINTING.
7. MOTOR SCREWS: TIP <= 3.2 mm PROUD OF THE FLOOR BEFORE EVERY MOTOR INSTALL (M4); 3.3 mm REACHES THE WINDINGS.
8. FIELD BREAKDOWN (R4): 2 x F09, 8 x BOOM-CLAMP SCREWS (F06/F04), 4 x F02 SHOE SCREWS; 14 SCREWS IN A LABELLED BAG.

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

CHECKED | — | | TITLE: FASTENER SCHEDULE AND TORQUES

ENG APPR.
MFG APPR.

INTERPRET GEOMETRIC TOLERANCING PER: | Q.A.

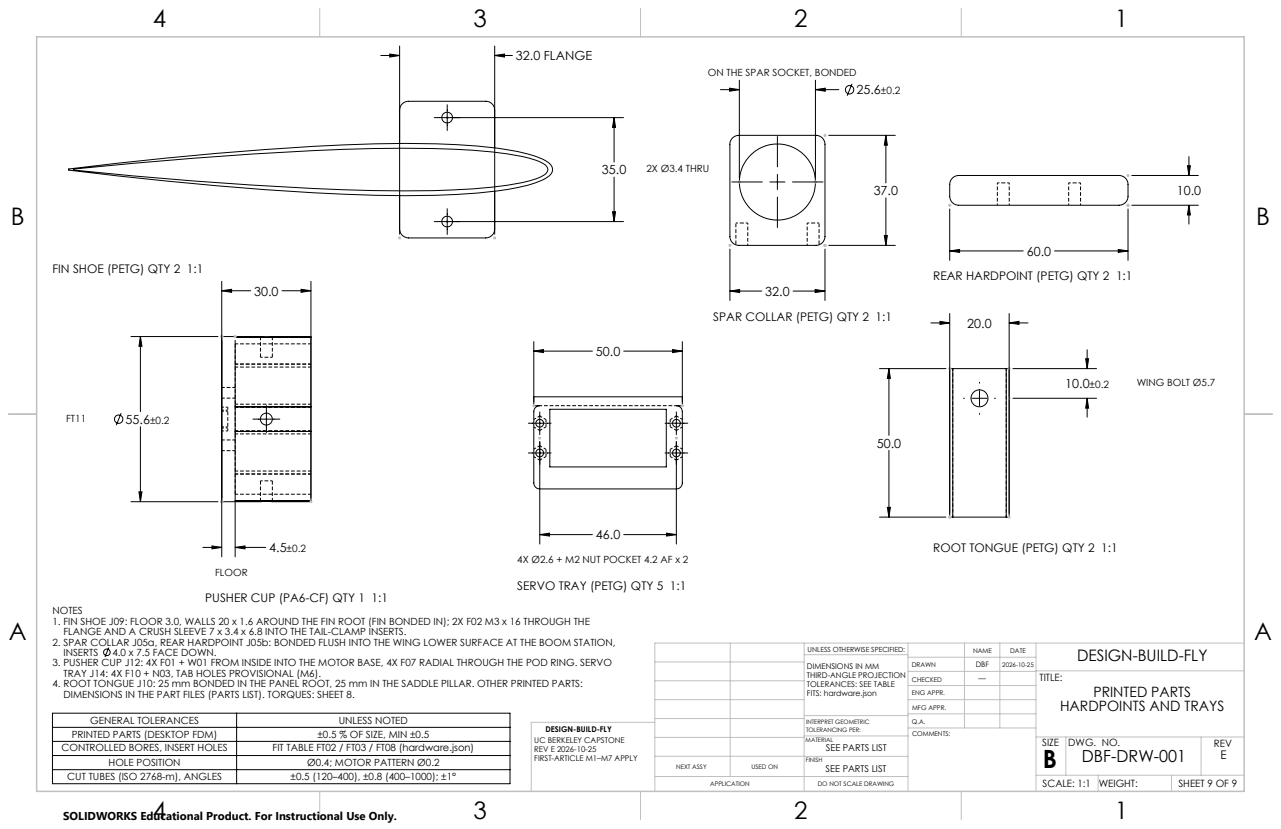
[picture p221: page 9]
32.0 FLANGE; 35.0 2X Ø3.4 THRU; WING BOLT Ø5.7; GENERAL TOLERANCES; UNLESS NOTED; PRINTED PARTS (DESKTOP FDM); ±0.5 % OF SIZE, MIN ±0.5; INTERPRET GEOMETRIC TOLERANCING PER:

ON THE SPAR SOCKET, BONDED

FIN SHOE (PETG) QTY 2 1:1

REAR HARDPOINT (PETG) QTY 2 1:1

SPAR COLLAR (PETG) QTY 2 1:1

ROOT TONGUE (PETG) QTY 2 1:1

4X Ø2.6 + M2 NUT POCKET 4.2 AF x 2
SERVO TRAY (PETG) QTY 5 1:1

FLOOR
PUSHER CUP (PA6-CF) QTY 1 1:1

1. FIN SHOE J09: FLOOR 3.0, WALLS 20 x 1.6 AROUND THE FIN ROOT (FIN BONDED IN); 2X F02 M3 x 16 THROUGH THE
FLANGE AND A CRUSH SLEEVE 7 x 3.4 x 6.8 INTO THE TAIL-CLAMP INSERTS.
2. SPAR COLLAR J05a, REAR HARDPOINT J05b: BONDED FLUSH INTO THE WING LOWER SURFACE AT THE BOOM STATION,
INSERTS 4.0 x 7.5 FACE DOWN.
3. PUSHER CUP J12: 4X F01 + W01 FROM INSIDE INTO THE MOTOR BASE, 4X F07 RADIAL THROUGH THE POD RING. SERVO
TRAY J14: 4X F10 + N03, TAB HOLES PROVISIONAL (M6).
4. ROOT TONGUE J10: 25 mm BONDED IN THE PANEL ROOT, 25 mm IN THE SADDLE PILLAR. OTHER PRINTED PARTS:
DIMENSIONS IN THE PART FILES (PARTS LIST). TORQUES: SHEET 8.

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

CHECKED | — | | TITLE: PRINTED PARTS HARDPOINTS AND TRAYS

ENG APPR.
MFG APPR.

DESIGN-BUILD-FLY
UC BERKELEY CAPSTONE
REV E 2026-10-25
FIRST-ARTICLE M1–M7 APPLY

CONTROLLED BORES, INSERT HOLES | FIT TABLE FT02 / FT03 / FT08 (hardware.json)

MATERIAL SEE PARTS LIST | SIZE B | DWG. NO. DBF-DRW-001 | REV E
