Dalcouffe1/Design-Build-Fly/firmware/vtol_c0.param

SERVO1_FUNCTION,4         # S1 aileron, left wing  (group 1, PWM) [PD values: 4 Aileron]
SERVO2_FUNCTION,4         # S2 aileron, right wing (group 1, PWM); set SERVO2_REVERSED after the direction check
SERVO3_FUNCTION,19        # S3 elevator (group 2, PWM) [PD: 19 Elevator]
SERVO4_FUNCTION,21        # S4 rudder, left boom (group 2, PWM) [PD: 21 Rudder]
SERVO5_FUNCTION,33        # S5 Motor1 front-right, CCW (group 3, DShot) [FR quad X order]
SERVO6_FUNCTION,34        # S6 Motor2 rear-left,  CCW (group 3, DShot) [FR]
SERVO7_FUNCTION,35        # S7 Motor3 front-left, CW  (group 3, DShot) [FR]
SERVO8_FUNCTION,36        # S8 Motor4 rear-right, CW  (group 4, DShot) [FR]
SERVO9_FUNCTION,70        # S9 pusher throttle (group 4, DShot via SERVO_BLH_MASK/OTYPE) [PD: 70 Throttle; DS]
SERVO9_MIN,1000           # (default 1100) ignored under DShot, which always uses 1000-2000 [DS]; set to match in case S9 falls back to PWM
SERVO9_MAX,2000           # (default 1900) as above [DS]
SERVO9_TRIM,1000          # (default 1500) idle = zero thrust; DShot uses 1000 for a normal output [DS]
Q_M_PWM_TYPE,4            # DShot150 for the lift motors: "recommended for larger aircraft with long signal lead runs" [DS]. No ESC calibration needed. Reboot.
Q_M_PWM_MIN,1000          # (default) DShot scaling floor [PD]
Q_M_PWM_MAX,2000          # (default) DShot scaling ceiling [PD]
Q_M_SPIN_ARM,0.10         # (default) set from the motor test: lowest output that spins all 4 motors cleanly [TP step 4]
Q_M_SPIN_MIN,0.15         # (default) set from the motor test: lowest output that gives a little thrust [TP step 4]
Q_M_SPIN_MAX,0.95         # (default) [TP step 2]
Q_M_THST_EXPO,0.72        # 17x5.5 prop: interpolated between 0.65 (10 in) and 0.75 (20 in): 0.65+0.10*(17-10)/10 [TP step 1]. Replace with thrust-stand fit (test T2).
Q_M_THST_HOVER,0.25       # first-flight value per [TP step 4] ("0.25, or lower than expected"). Expected learned value ~0.52 (est.) = 1637.9 g / 3130 g per motor [RJ C0.sized.Tunit_g; C0.params.Tmax_g]
Q_M_HOVER_LEARN,2         # (default) learn and save hover throttle [TP step 7]
Q_M_BAT_VOLT_MAX,25.2     # thrust voltage compensation, 4.2 V x 6S [PD recommendation]
Q_M_BAT_VOLT_MIN,19.8     # 3.3 V x 6S [PD recommendation]
Q_M_BAT_CURR_MAX,85       # total-current cap that throttles the LIFT motors only. 85 A sits under the FC sensor/PDB 90 A cont [BP] and above hover 41.2 A and transition 75.7 A (est., v0.4) [RJ I_hover, I_trans]. See [FM] D7.
Q_A_THR_MIX_MAN,0.1       # (default) first-flight value [TP step 4]
INS_GYRO_FILTER,26        # 40 Hz (10 in) to 20 Hz (20 in), interpolated for 17 in: 40-20*0.7 [TP step 3]
Q_A_ACC_P_MAX,680         # 1100 (10 in) to 500 (20 in) deg/s/s, interpolated: 1100-600*0.7 [TP step 3]
Q_A_ACC_R_MAX,680         # same as pitch [TP step 3]
Q_A_ACC_Y_MAX,50          # 67.5 (10 in) to 45 (20 in), interpolated 51.75, rounded to the 10 deg/s/s increment [TP step 3; PD]
Q_A_RAT_YAW_P,0.56        # 0.5 x Q_A_ACC_Y_MAX / 45 = 0.5*50/45 [TP step 3]
Q_A_RAT_YAW_I,0.06        # ~P/10 (0.056, rounded to the 0.01 increment), same I/P ratio as the firmware default 0.18/0.018 (est.)
Q_A_RAT_PIT_FLTD,13       # INS_GYRO_FILTER / 2 [TP step 3]
Q_A_RAT_PIT_FLTT,13       # INS_GYRO_FILTER / 2 [TP step 3]
Q_A_RAT_RLL_FLTD,13       # INS_GYRO_FILTER / 2 [TP step 3]
Q_A_RAT_RLL_FLTT,13       # INS_GYRO_FILTER / 2 [TP step 3]
Q_A_RAT_YAW_FLTE,2.5      # (default) 2.5 for non-vectored-yaw QuadPlanes [TP step 3]
Q_A_RAT_YAW_FLTT,13       # INS_GYRO_FILTER / 2 [TP step 3]
INS_HNTCH_ENABLE,0        # (default) notch stays off until the hover FFT log exists; then throttle-based notch per firmware/README.md 9.4 [TP]
SERIAL6_PROTOCOL,23       # RCIN (CRSF/ELRS) on TX6/RX6 - board default [HW; BP]
FLTMODE_CH,6              # CH6 = 6-position mode channel (two switches mixed in EdgeTX) [PD]
FLTMODE1,17               # QSTABILIZE - first lift-offs [TP step 5]
FLTMODE2,18               # QHOVER [RV]
FLTMODE3,19               # QLOITER [RV]
FLTMODE4,5                # FBWA - pilot-commanded forward transition target [TR]
FLTMODE5,7                # CRUISE [PD]
FLTMODE6,20               # QLAND [RV]
BATT_MONITOR,4            # analog V + I (board default) [HW; BP]
BATT_VOLT_PIN,10          # board default [BP]
BATT_CURR_PIN,11          # board default [BP]
BATT_VOLT_MULT,11.05      # board default; calibrate against a multimeter [BP]
BATT_AMP_PERVLT,64        # Wing V2 default; calibrate against the watt meter [BP; BOM watt meter]
BATT_CAPACITY,6500        # Ovonic 6S 6500 mAh [BOM; RJ packs]
BATT_ARM_VOLT,23.4        # refuse to arm below 3.9 V/cell, i.e. a pack that is not charged (est.)
BATT_LOW_VOLT,21.0        # 3.5 V/cell sag-compensated (est.); 21.0 V is the review's loaded-pack voltage [RV section 5]
BATT_CRT_VOLT,19.8        # 3.3 V/cell sag-compensated (est.)
BATT_LOW_MAH,1950         # 30 % left: planned mission lands near 29 % (1 - 97.85/0.95/144.3) [RJ C0.sized.E_Wh, base.etaBatt, pick.Wh]
BATT_CRT_MAH,1300         # 20 % = R10 landing reserve [DB R10]
BATT_FS_VOLTSRC,1         # use sag-compensated voltage, so hover/transition sag does not trip it [PD]
BATT_LOW_TIMER,10         # (default) s below threshold before acting [PD]
BATT_FS_LOW_ACT,1         # low: RTL (ends in QRTL vertical landing at home). Review said QLAND; see [FM] D9
BATT_FS_CRT_ACT,4         # critical: QLAND where it is [PD values; RV]
SERIAL5_PROTOCOL,5        # GPS on UART5 (HGLRC M100-5883) - board default [HW; BOM]
SERIAL1_PROTOCOL,2        # MAVLink2 to the CoreWing BLE/WiFi module (bench GCS link) - board default [HW; BP]
SERIAL4_PROTOCOL,2        # MAVLink2 on TELEM2/4, reserved for a SiK radio if one is added - board default [HW]
SERIAL3_PROTOCOL,-1       # none; no VTX on this aircraft [HW]
