Dalcouffe1/Design-Build-Fly/(commit log)

2026-10-13 Lift + cruise VTOL capstone: design review v0.3.1, sizing, CAD and simulation
    - Design review (VTOL-Review.html, 13 sections): budget redesign that fits the
    fixed $2,000 cap ($1,897.92 committed, $102.08 reserve), concepts, mass and
    power, propulsion, structures, BOM, test plan, CG, controls, schedule,
    simulation and flight-test operations.
    - Sizing model (analysis/model.js, sizing.mjs) with independent checks
    (verify.py), vortex-lattice aero check (vlm.mjs) and purchasing CSV.
    - SOLIDWORKS concept model generated from the sizing (cad/BuildVtol.cs):
    25 parts, 46-component assembly, STEP and eDrawings exports.
    - SOLIDWORKS Simulation runs (cad/Sim.cs): boom static + modal, spar/join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
    [Aileron_L.SLDPRT, Aileron_R.SLDPRT, Battery_6S_LiPo.SLDPRT, Boom_Clamp_Front.SLDPRT, Boom_Clamp_Rear.SLDPRT, Boom_Front.SLDPRT, Boom_Rear_Stub.SLDPRT, C0_BOM.csv]
2026-10-14 CAD: add wing centre-section saddle and root screws so the wing reads as attached through the pod
    The panels butted onto the round, tapering pod at its maximum radius, leaving a visible
    gap (about 6 mm at the leading edge, growing toward the trailing edge). The saddle carries
    the root aerofoil across the pod over the joiner; one M5 screw per side from the budgeted
    hardware kit holds it down. No BOM or sizing change.
    [Aileron_L.SLDPRT, Aileron_R.SLDPRT, Battery_6S_LiPo.SLDPRT, Boom_Clamp_Front.SLDPRT, Boom_Clamp_Rear.SLDPRT, Boom_Front.SLDPRT, Boom_Rear_Stub.SLDPRT, Canopy.SLDPRT]
2026-10-14 Review: interactive SOLIDWORKS model viewer
    cad/ExportMesh.cs exports each part as a binary STL with its display colour and description;
    review/mesh.mjs welds and packs them (27 parts, 11,642 triangles) with the assembly placements
    from cad/params.txt. The CAD section renders them with three.js r128: orbit, pan, zoom,
    standard views, X-ray (foam and skin faded to show the structure), explode, and part names on
    hover or tap. Also corrects stale part descriptions (NACA 2413, 0.6 m joiner) in BuildVtol.cs.
    [Aileron_L.SLDPRT, Aileron_L.STL, Aileron_R.SLDPRT, Aileron_R.STL, Battery_6S_LiPo.SLDPRT, Battery_6S_LiPo.STL, Boom_Clamp_Front.SLDPRT, Boom_Clamp_Front.STL]
2026-10-19 Add PRODUCT.md (Impeccable init) and live-mode config
    Records the product truth for the design review: external client/sponsor as the primary
    reader, approval of the design and $2,000 spend as the goal, shared-link delivery, the
    Design-Build-Fly name, and the traceability principles.
2026-10-19 Add DESIGN.md and design.json sidecar (Impeccable document); enable design hook
    DESIGN.md records the incumbent report system as 'The Drawing Title Block': ink on vellum,
    International Orange for position only, verdict colours, Barlow Semi Condensed / Source Sans 3 /
    Red Hat Mono, ruled blocks, flat, 2px corners. The sidecar carries tonal ramps, motion,
    breakpoints and eight component snippets. The CAD viewer now jumps camera moves and explode
    instantly under prefers-reduced-motion.
2026-10-19 Review: fix all Impeccable detector findings (351 -> 0)
    - Type scale consolidated to 12/13/14/16/18/20/24/30/32/42 px; labels, chips, table headers
    and title-block fields raised from 10.6-10.9 px to 12 px, citations from 11.8 to 13 px.
    - No kickers: the cover eyebrow became a Project / Design-Build-Fly cell in the title block,
    section numbers moved into the h2, decision status became an inline chip.
    - Concepts 'Considered and dropped' is now an h3 (no skipped heading level).
    - Decision and banner frames use tokens instead of color-mix; chips and EST tags have explicit
    border colours; table rules sit on the table; segmented controls are an inset tray.
    - DESIGN.md and the sidecar record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
2026-10-19 Review: fix all audit findings (optimize, harden, adapt, clarify, polish)
    Optimize: three.js and OrbitControls load only when the CAD section opens, so a slow CDN can no
    longer hold up the page; renders are embedded as JPEG via review/tojpeg.ps1 (1.29 MB PNG ->
    416 KB), page 2.2 MB -> 1.04 MB.
    Harden: focus moves to the new section heading on navigation, aria-current on the active links,
    pointercancel/lostpointercapture reset the concept viewer drag, keyboard parts list highlights
    parts in the 3D viewer.
    Adapt: touch screens get a tap-to-rotate gate so swipes over the canvases scroll the page; phone
    charts render text at 12 px; the five data charts carry their values in their accessible name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
2026-10-19 Review: fix re-audit findings
    - Schedule (gantt) and flight-mode diagrams carry their milestones and transitions as text.
    - Concept-card titles are h3 (no h2 -> h4 skip), styled as before.
    - Decorative chain arrows are aria-hidden.
    - Polish: chart shapes use the 2px corner; 'speed ~ 0' label no longer sits under the QLAND box.
2026-10-19 Review: fix third-audit findings
    - Adapt: 3D canvases capped by screen height (clamp 260 px to 540 px against 100svh - 140 px),
    so landscape phones show the model and its controls; phone tables scroll with the page.
    - Harden: skip-to-content link (focuses the current section heading); sliders carry units in
    aria-valuetext; MTOW, power and T/W announced in a polite live region after slider changes.
    - Optimize: the CAD viewer renders on demand and stops its frame loop when idle or hidden.
2026-10-19 Review: fix fourth-audit findings
    - Harden: when three.js cannot load, the CAD viewer hides its control bar and parts list and
    shows only the fallback note with a 'Try again' button that reloads the library and rebuilds
    the viewer; the parts list stays hidden until the viewer is ready.
    - Clarify: section cross-reference links (e.g. '§11') carry the section title in their
    accessible name.
    - DESIGN.md records the offline state.
2026-10-19 Review: fix fifth-audit findings
    - Harden: the CAD part and component counts (overview status table and section 2) come from the
    exported meshes instead of hand-typed text, fixing the stale '23 parts'; sortable headers hold
    full-cell buttons with aria-sort on the th (44 px on phones).
    - Clarify: design-basis citations take their version from docs/DESIGN-BASIS.md at build time
    (all now v0.3.1).
    - Adapt: print stylesheet drops interactive-only parts and keeps blocks unbroken across pages.
    - DESIGN.md records sortable headers and print.
2026-10-19 Review: print uses the light palette tokens instead of literal colours
    The print rule body{background:#fff;color:#000} left dark-theme text tokens in place, so
    printing from dark mode put light grey text on white (654 detector contrast warnings). Print
    now redefines the light token set over both dark-theme selectors.
2026-10-19 Engineering drawings DBF-DRW-001 and report-style review
    cad/Drawings.cs builds a five-sheet ANSI B SOLIDWORKS drawing set from the model:
    general arrangement (front elevation, plan, side elevation, isometric), ballooned parts list
    with the SOLIDWORKS BOM, wing panel and saddle, printed parts, tube cut list and landing leg.
    Every dimension is a driven dimension between points placed at model coordinates from
    cad/params.txt (38 dimensions, all matching the sizing). Title blocks carry the project,
    drawing number, revision, scales, metric units and 'not released for manufacture'.
    Exports SLDDRW, a vector PDF and sheet PNGs; run by cad/build.ps1.
    Review (issue 2): the drawings appear as numbere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
    [DBF-DRW-001.SLDDRW]
2026-10-21 Review: continuous report layout, summary first (layout, distill, polish)
    Layout: the sidebar contents and one-section-at-a-time tabs are replaced by one continuous
    report: cover with document control, a numbered contents page, chapters in sequence with ink
    rules, and a thin running head naming the current section once the contents scroll away.
    In-page links move focus to their target; instant scrolling for long jumps.
    Easier to read the data: each section leads with its verdict, key figures and charts. Tables
    over ten rows fold behind 'Show the full table · N rows'; decision cards show the question and
    recommendation with facts and sources one click away; requirement status is a count lin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
2026-10-21 Review: graphite dark theme, STIX Two Text, title-page cover, viewer stage, clarify
    - One dark theme on a mid-grey ground with lighter grey panels; theme switch removed
    - STIX Two Text throughout (Times New Roman fallback)
    - Cover rebuilt as a report title page: document line, revision record, signature lines
    - CAD viewer on a graded stage with labelled View / Display control groups
    - Clarify: consistent disclosure labels, plainer viewer help and offline message
    - DESIGN.md and sidecar updated; detector 0 findings, verify.py clean
2026-10-22 Full engineering draft v0.4.0: hardware, CAD rev B, aero/CFD, trade study, build manual, test plan, flight software
    - Hardware and fits for every joint (docs/research/hardware-spec.md, cad/hardware.json)
    - CAD rev B: 75 part files, 397 components with every fastener; 9-sheet drawing set with tolerances; interference-checked
    - Aerodynamics: XFOIL, NeuralFoil, AVL, drag build-up, SU2 2-D RANS (analysis/aero); leg fairings and resized wing
    - 29-variant configuration trade study with literature survey (analysis/tradestudy.*, docs/research/configurations.md)
    - Build manual DBF-MAN-001, test plan DBF-TP-001, flight software package (ArduPlane 4.7.2, SITL A-G)
    - Review restructured into three parts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
    [Aileron_L.SLDPRT, Aileron_L.STL, Aileron_R.SLDPRT, Aileron_R.STL, Battery_6S_LiPo.SLDPRT, Battery_Tray.SLDPRT, Battery_Tray.STL, Bolt_Pillar.SLDPRT]
2026-10-23 aero: SU2 driver survives crashed cases and parses wall time correctly
2026-10-23 aero: retry rewrites only the main ITER count; Cp from incompressible pressure output
2026-10-23 Aero: final 2-D CFD at the v0.4 cruise Reynolds number, shown honestly in the review
    - Fine-mesh SU2 agrees with XFOIL within about 10 % in lift at 2 and 10 deg; coarse-to-fine change 2.3 % / 10.6 %
    - Medium mesh and most transition-model runs did not converge: shown as "-", kept out of the polar
    - docs/research/aerodynamics.md: v0.4 summary and final CFD status
    [case.cfg]
2026-10-24 Review: one chapter at a time (binder tabs, routing) and animated CFD flow views
    - Binder navigation: Part tabs, chapter strip, hash routing, previous/next cards; print shows all
    - Flow visualisation in the aerodynamics chapter: SU2 2-D field over the NACA 2415 at 0-15 deg
    (particles over speed or Cp) and VLM streamlines over the aircraft at cruise trim (orbitable)
    - analysis/aero/flowfield_2d.py, flowfield_3d.py; out/flowviz/*.json; plots/flow_*.png
    - aerodynamics.md section 11; DESIGN.md binder and flow-viewer components
    - Measure and text-wrap fixes from rendered Impeccable scans (all pages 0 findings)
2026-10-24 Drawings DBF-DRW-001 rev C and review issue 4
    - Zone-based sheet layout: 24 balloons on the exploded view, 75-item parts list in three columns,
    hole callouts and narrow dimensions placed clear of every extension line, legible title block
    - Review issue 4: revision record, rev C references, rebuilt pages and companion documents
    [DBF-DRW-001.SLDDRW, cut-list.csv, test-matrix.csv]
2026-10-25 Code review cleanup: page routing and CSS scope, flow-viewer performance, SU2 result gating
    Review page
    - Binder CSS scoped to .binder-on so companion pages keep their masthead, back link and contents
    - Skip link stays in the current chapter; route changes redraw only that chapter's charts
    - Dead running-head code removed; all inline JSON escaped through one helper; writeSafe retries only on locks
    - Flow viewer: theme tokens cached, per-angle decode and separation cached, 3-D projection and depth
    sort cached until the camera moves, Play works under reduced motion, literals sourced
    Analysis
    - su2_2d: 'usable' gate (residual drop, CD > 0, |CL| <= 2.5) keeps diverged cases out of polars,
    m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
2026-10-25 Close R11: wing re-sized on the aero package's CL_max; CAD rev C, drawings rev D
    - sizing.mjs reads CL_max, boom and rotor drag areas and the pod NP shift from aero_results.json
    (no hand copies); sizing -> aero iterated to convergence: CL_max 1.121, stall 12.00 m/s (R11 met)
    - C0: chord 266.6 mm, S 0.640 m2, MTOW 6.45 kg, front boom 965.7 mm; BOM unchanged (,896.79)
    - CAD rev C rebuilt (modelled 6.27 kg; 286 interferences, 201 intended insert fits); drawing set
    DBF-DRW-001 rev D with geometry-dependent dimensions and notes read from params.txt
    - Nut pocket 9.0 mm (bears on the root tongue; accepted, recorded in hardware-spec)
    - Templates, build manual, test plan, test cards, design basis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
    [Aileron_L.SLDPRT, Aileron_L.STL, Aileron_R.SLDPRT, Aileron_R.STL, Battery_6S_LiPo.SLDPRT, Battery_Tray.SLDPRT, Bolt_Pillar.SLDPRT, Bolt_Pillar.STL]
2026-10-25 Review issue 5: interactive engineering review platform
    - App shell: top bar (search, theme, Report view), grouped sidebar, drawer on phones;
    one page per chapter with sub-tabs, hash routes, legacy anchors resolved
    - Visual-first workspaces: shared SOLIDWORKS viewport on Overview and CAD, parts inspector,
    drawing sheet viewer, flow viewer; key parameters as a spec list
    - IBM Plex type, dark graphite default with a light theme, one blue accent, tinted status chips
    - Report view and print render the traditional document (cover, revision record, approvals,
    every page); revision record, metadata and approvals moved to Report info; Downloads page
    - Content preserved (number-by-number check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
2026-10-25 FEA re-run on the CAD rev C / v0.4 inputs
    - cad/Sim.cs: all seven studies re-run 2026-10-25 from params.txt (boom arm 0.4498 m, tip force
    30.7 N, spar root moment 72.5 N m, hover heat 44.6 W); material name read from params
    - Results: boom 35.7 MPa fine (hand 34.1), tip 2.49 mm (hand 2.62), f1 35.9 Hz (hand 33.7);
    spar 152 MPa fine (hand 155), RF 1.91; motor steady 141.1 C (hand 140.7); verify.py passes
    - Test plan S01-S03, C08 and data sheets re-based on the new FEA; joiner RF 1.77 in hardware-spec
    [FEA_Boom_Arm.SLDPRT, FEA_Spar_Joiner.SLDPRT, THERM_Lift_Motor.SLDPRT, test-matrix.csv]
2026-10-25 Design stall 11.75 m/s, CAD rev D, CFD/FEA on the final wing, thermal analysis, C0 SITL, single-sourced geometry
    Stall margin (docs/research/stall-margin.md): design stall 11.75 m/s, 4.1 % CL_max margin under R11.
    Sizing and aero converged at CL_max 1.114: chord 284.2 mm, S 0.682 m2, MTOW 6.55 kg, cruise 12.26 min,
    BOM unchanged (,896.79). common.py separates the R11 limit (12 m/s) from the design target.
    CAD model rev D, drawing DBF-DRW-001 rev E: all sheets re-laid out. The wing-bolt nut pocket would have sat
    in the root tongue (nylock not engaged); spot-face deepened to 2.0 mm, 9.6 mm pocket, near-flush.
    FEA re-run on rev D (verify.py passes). CFD on the final wing: 29/29 SU2 cases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
    [Aileron_L.SLDPRT, Aileron_L.STL, Aileron_R.SLDPRT, Aileron_R.STL, Battery_6S_LiPo.SLDPRT, Battery_Tray.SLDPRT, Bolt_Pillar.SLDPRT, Bolt_Pillar.STL]
2026-10-25 Review: heat-dissipation workspace, 11.75 m/s design stall, rev D/E labels
    - Simulation chapter: thermal viewer (rotatable SOLIDWORKS temperature fields in a thermal-camera palette
    with hot-spot markers, static renders for the pod and pusher), mission temperature history against
    limits, findings table, blocking card for the hot-day battery overheat with the ventilation fixes
    - Stall decision card and aero verdict reflect the 11.75 m/s design target and its margin to R11
    - Revision record issue 5, CAD rev D, drawing rev E; FEA and CFD statuses updated
2026-10-25 CI: regenerate the analysis and review page on every push and fail on stale outputs
    Runs sizing, BOM export, vortex lattice and trade study, then analysis/verify.py and the review build,
    and fails if any committed output differs from what the sources produce (line endings normalised).
    SOLIDWORKS and the aero solvers cannot run on a hosted runner; their committed outputs are inputs and
    verify.py checks the sizing against them. The ArduPlane parameter check runs as an advisory step.
2026-10-27 Build manual: 27 step figures rendered from the CAD model
    cad/BuildFigs.cs renders each figure in docs/build/figs.txt from VTOL_Concept.SLDASM:
    the parts a step fits in orange with their fasteners in blue, earlier parts as they are,
    enclosing parts translucent; white background, cropped JPEGs in docs/build/img/.
    docpage.mjs renders ![caption](path) lines as figures embedded in the companion page.
    Print list P03 no longer calls for pusher-cup vent slots (BUILD-MANUAL 2.7).
    [print-list.csv]
2026-10-27 Companion pages: one section at a time instead of one long scroll
    Each section is a page; the build manual's work packages WP1-WP14 each get their own.
    Side contents with per-page Done counts on wide screens, a section menu on phones,
    previous/next at the foot of each page; any anchor (step, section) opens its page.
    A Full document toggle and print show every section. Figures no longer lazy-load.
